cnz95/SWTE_UTN_FRN_GESE_PID/docs/graf_interp_surf_EN_s.png

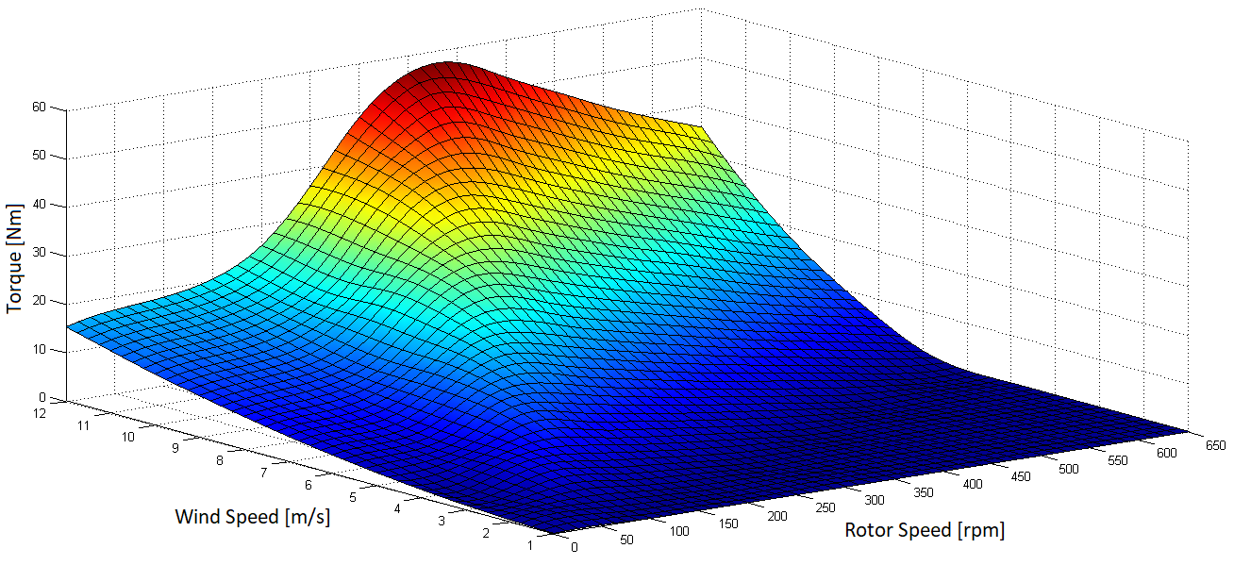
docs/graf_interp_surf_EN_s.png
