cnz95/SWTE_UTN_FRN_GESE_PID/docs/imgs otros/Figuras.docx

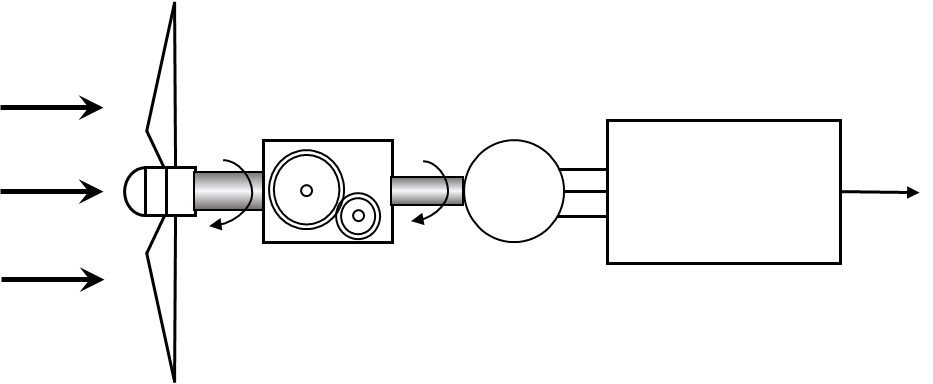
[picture p5: figure]
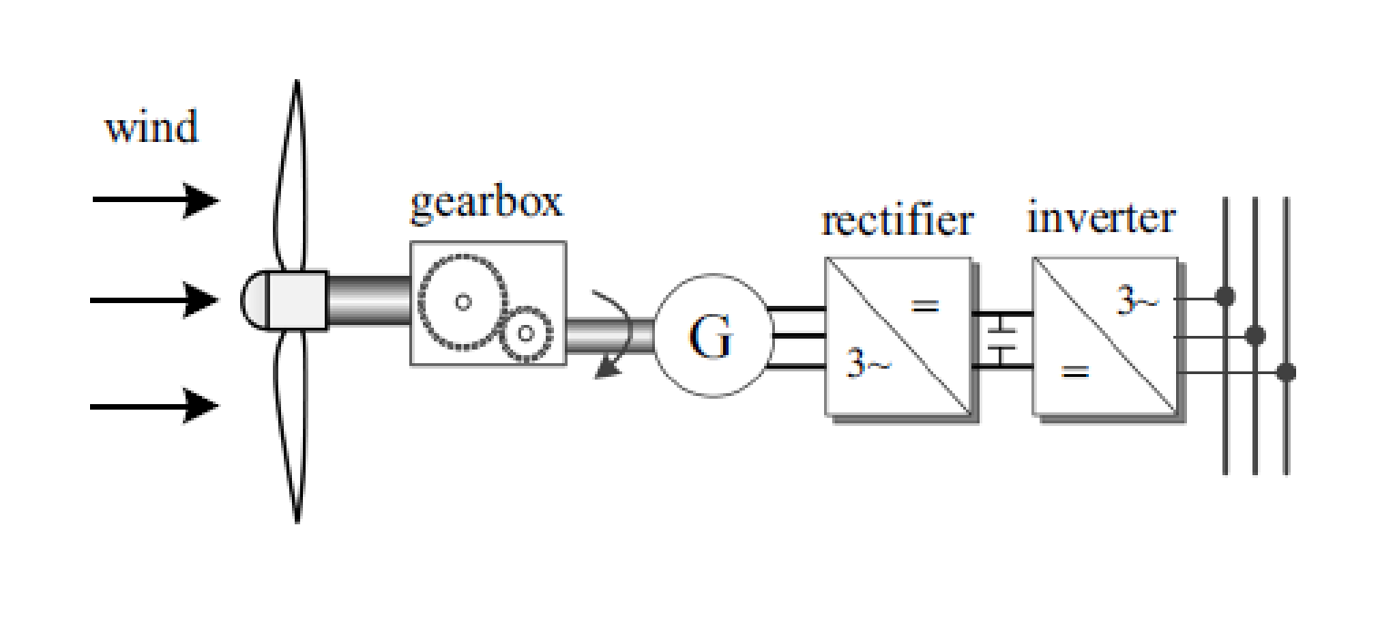
[picture p6: figure]
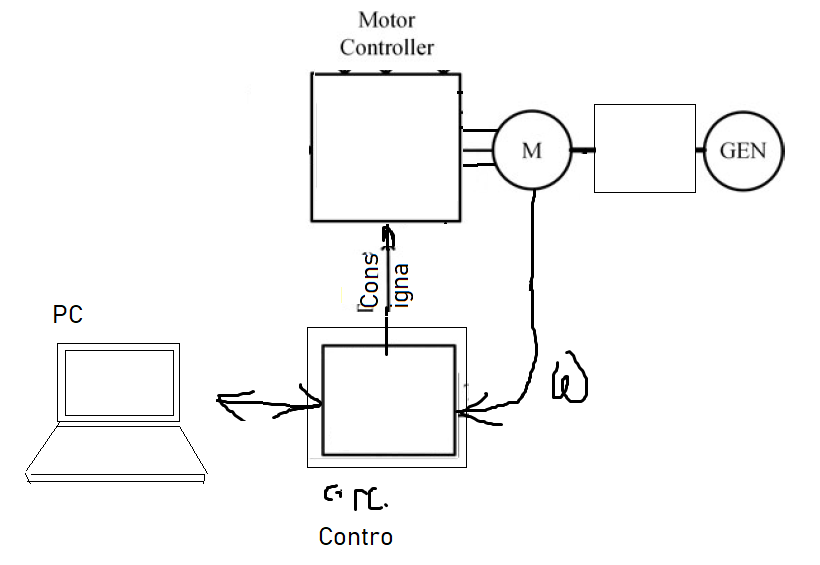
[picture p7: figure]
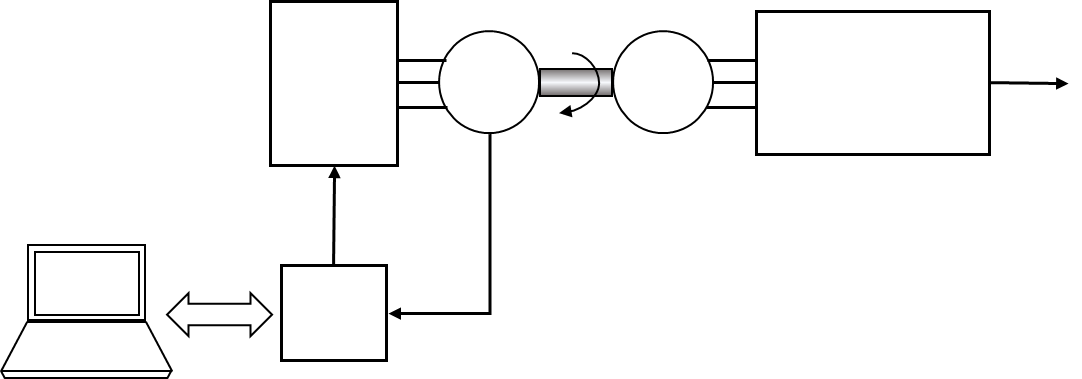
[picture p8: figure]
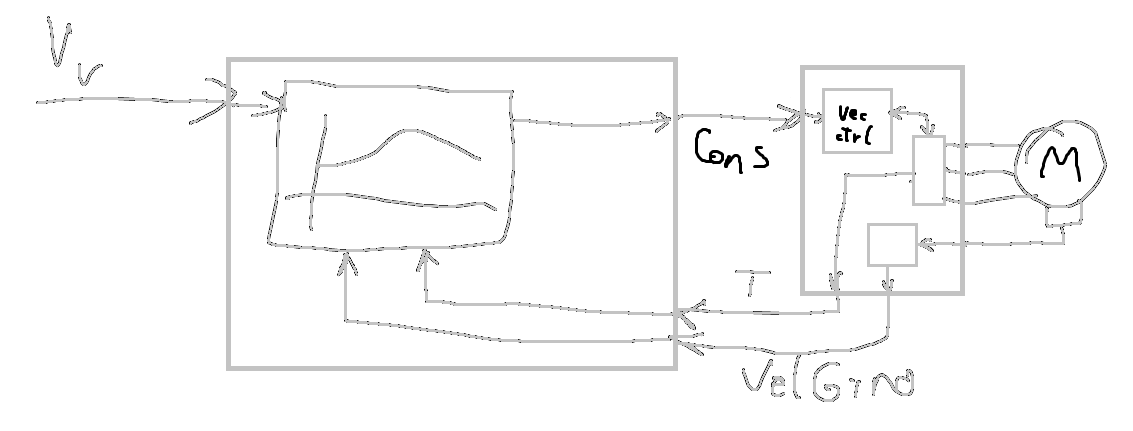
[picture p9: figure]
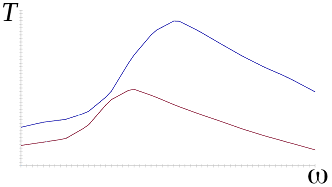
[picture p10: figure]
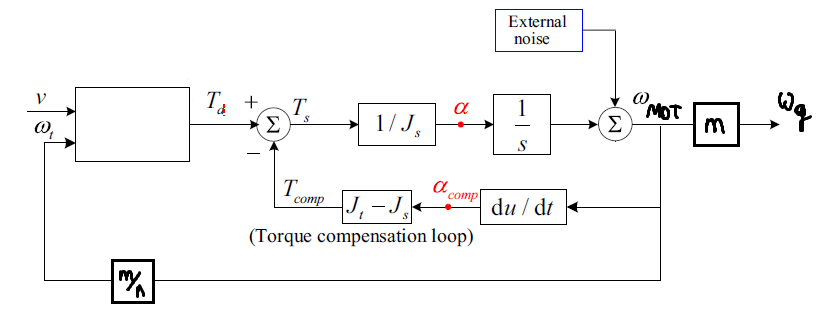
[picture p11: figure]
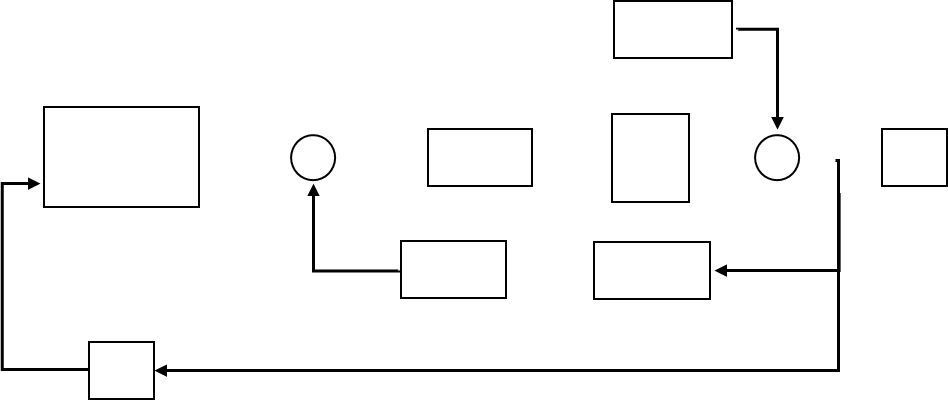
[picture p12: figure]
