cnz95/SWTE_UTN_FRN_GESE_PID/docs/control/flowchart_tarea_control_simplified.png

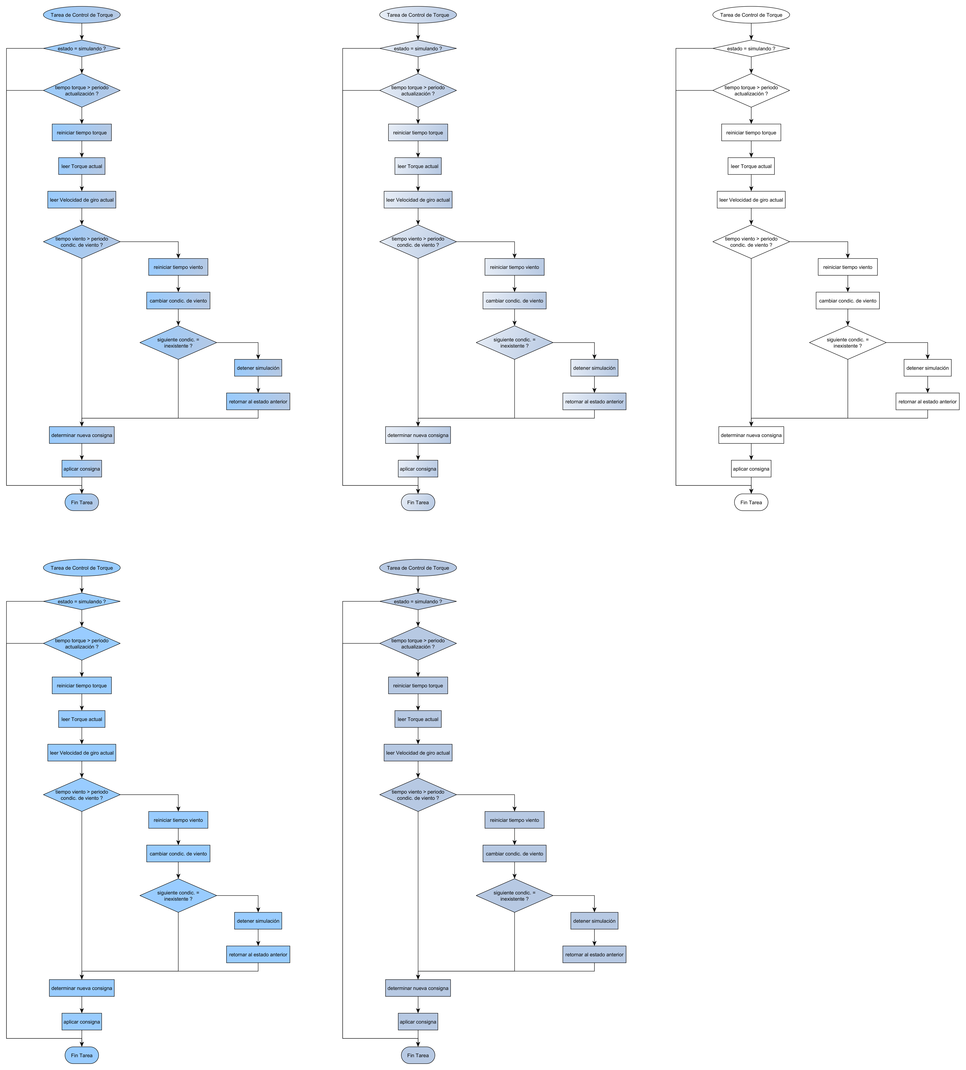
docs/control/flowchart_tarea_control_simplified.png
