cnz95/SWTE_UTN_FRN_GESE_PID/docs/control/flowchart_tarea_control_simplified_1.2.png

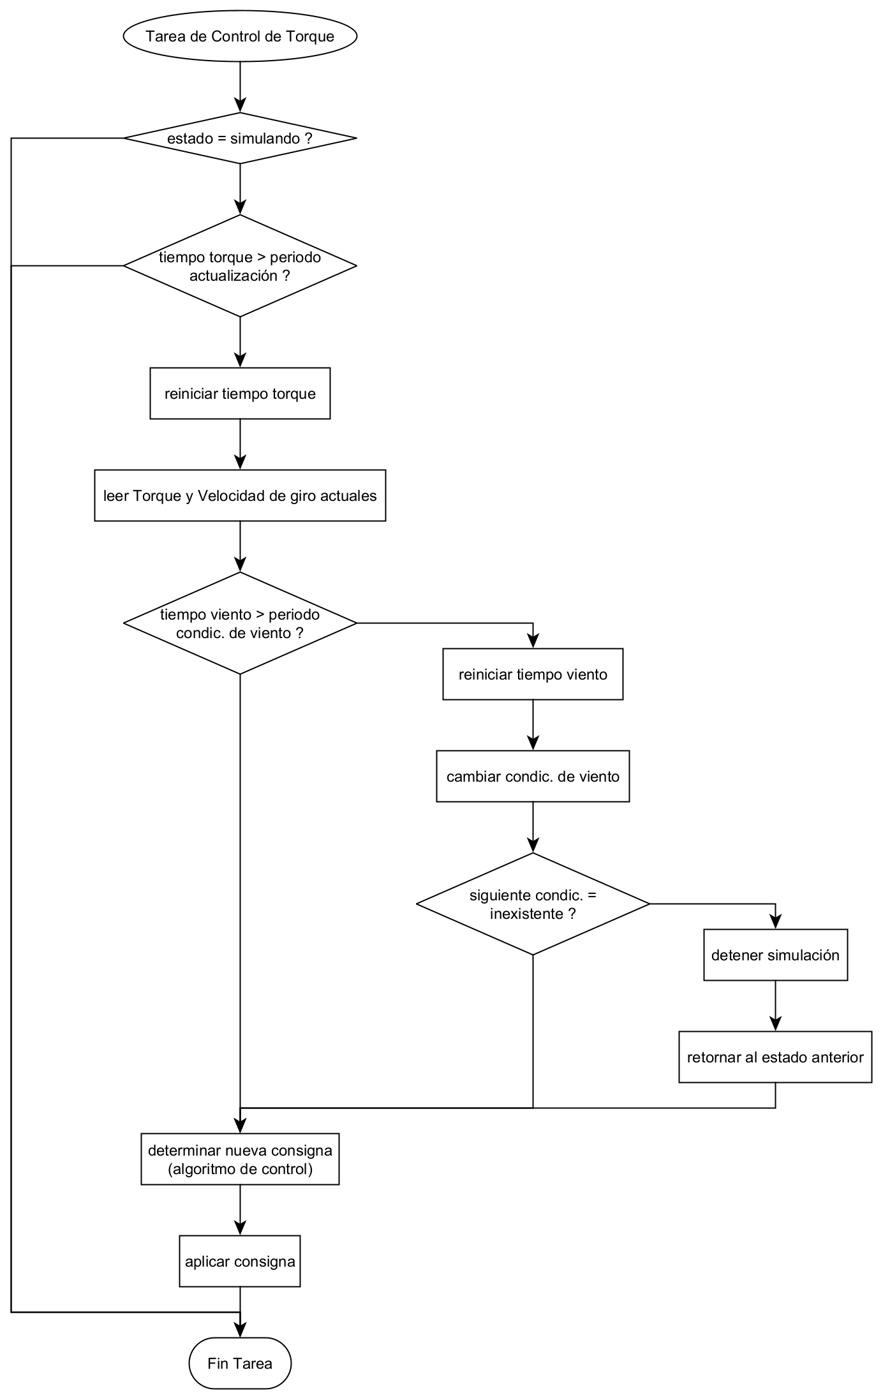
docs/control/flowchart_tarea_control_simplified_1.2.png
