cnz95/SWTE_UTN_FRN_GESE_PID/docs/imgs otros/capt_GUI.png

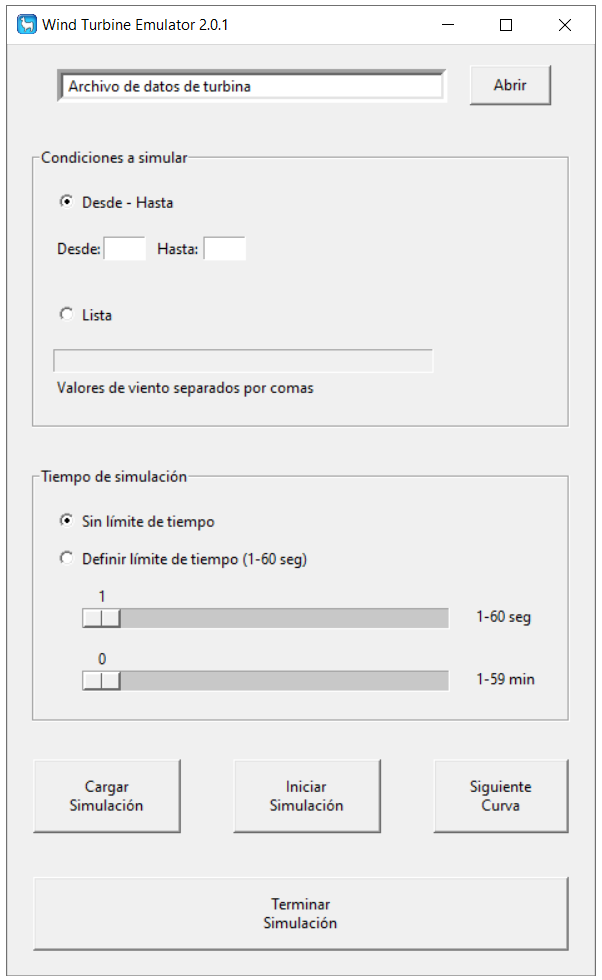
docs/imgs otros/capt_GUI.png
