cnz95/SWTE_UTN_FRN_GESE_PID/docs/imgs otros/control_circuit_1.png

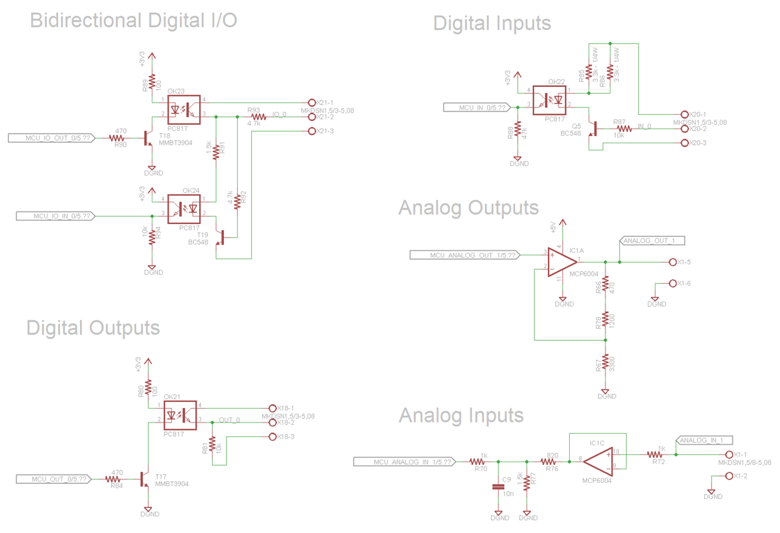
docs/imgs otros/control_circuit_1.png
