cnz95/SWTE_UTN_FRN_GESE_PID/docs/imgs otros/control_circuit_2.png

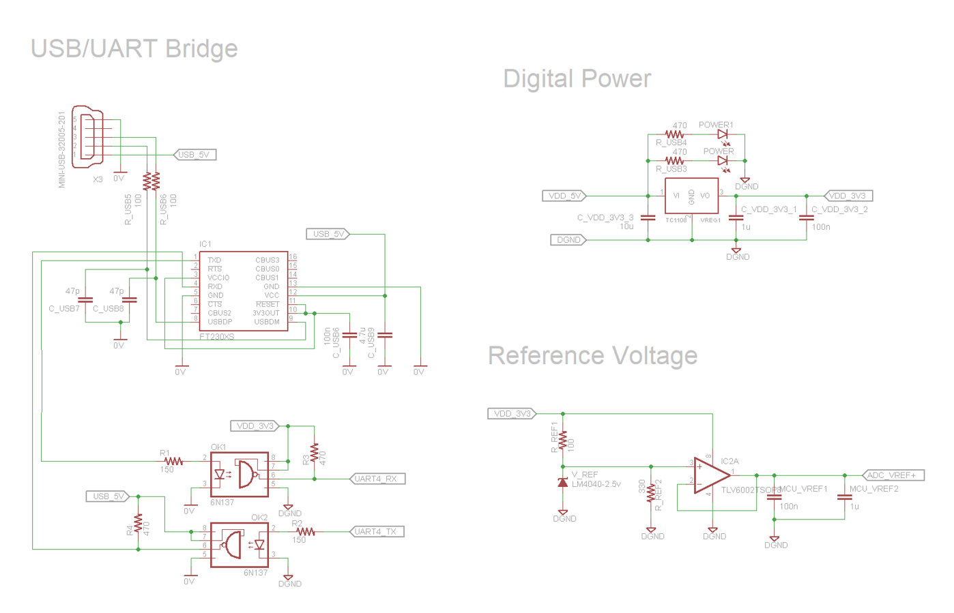
docs/imgs otros/control_circuit_2.png
