cnz95/SWTE_UTN_FRN_GESE_PID/docs/imgs otros/diagr_circ_control.png

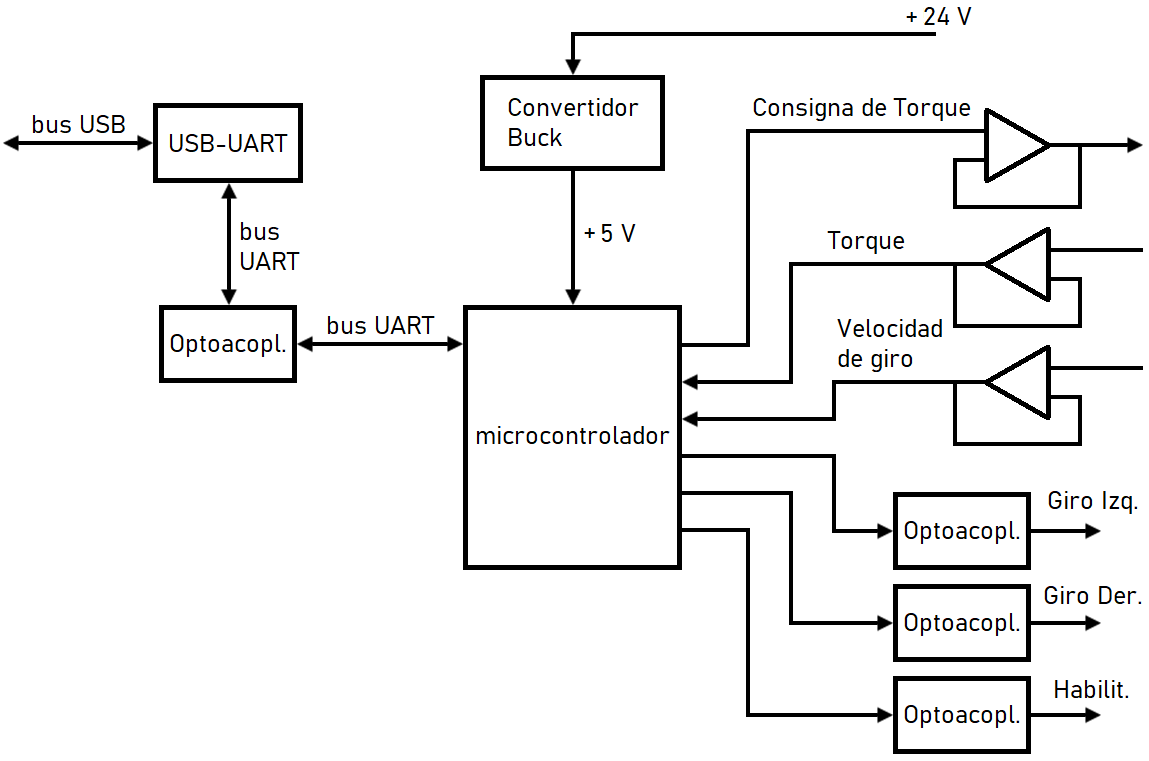
docs/imgs otros/diagr_circ_control.png
