cnz95/SWTE_UTN_FRN_GESE_PID/docs/imgs otros/ESQ1.png

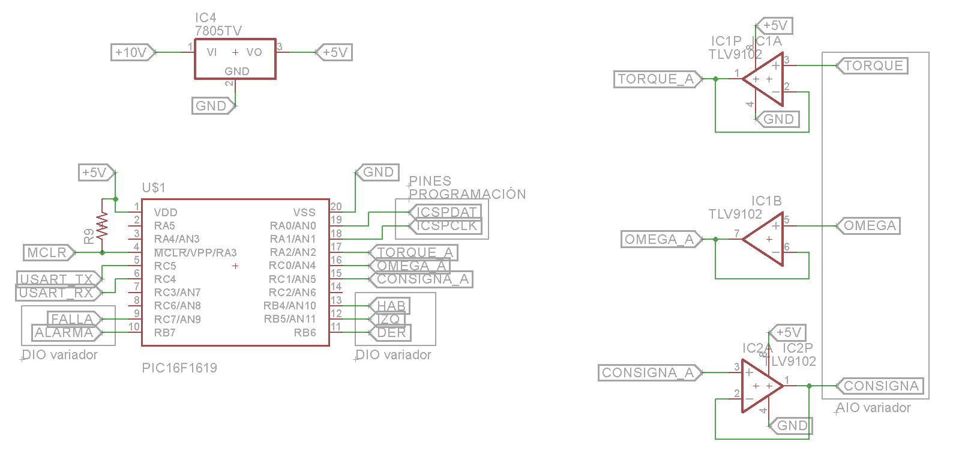
docs/imgs otros/ESQ1.png
