cnz95/SWTE_UTN_FRN_GESE_PID/docs/imgs otros/esq_circ_ed_control.png

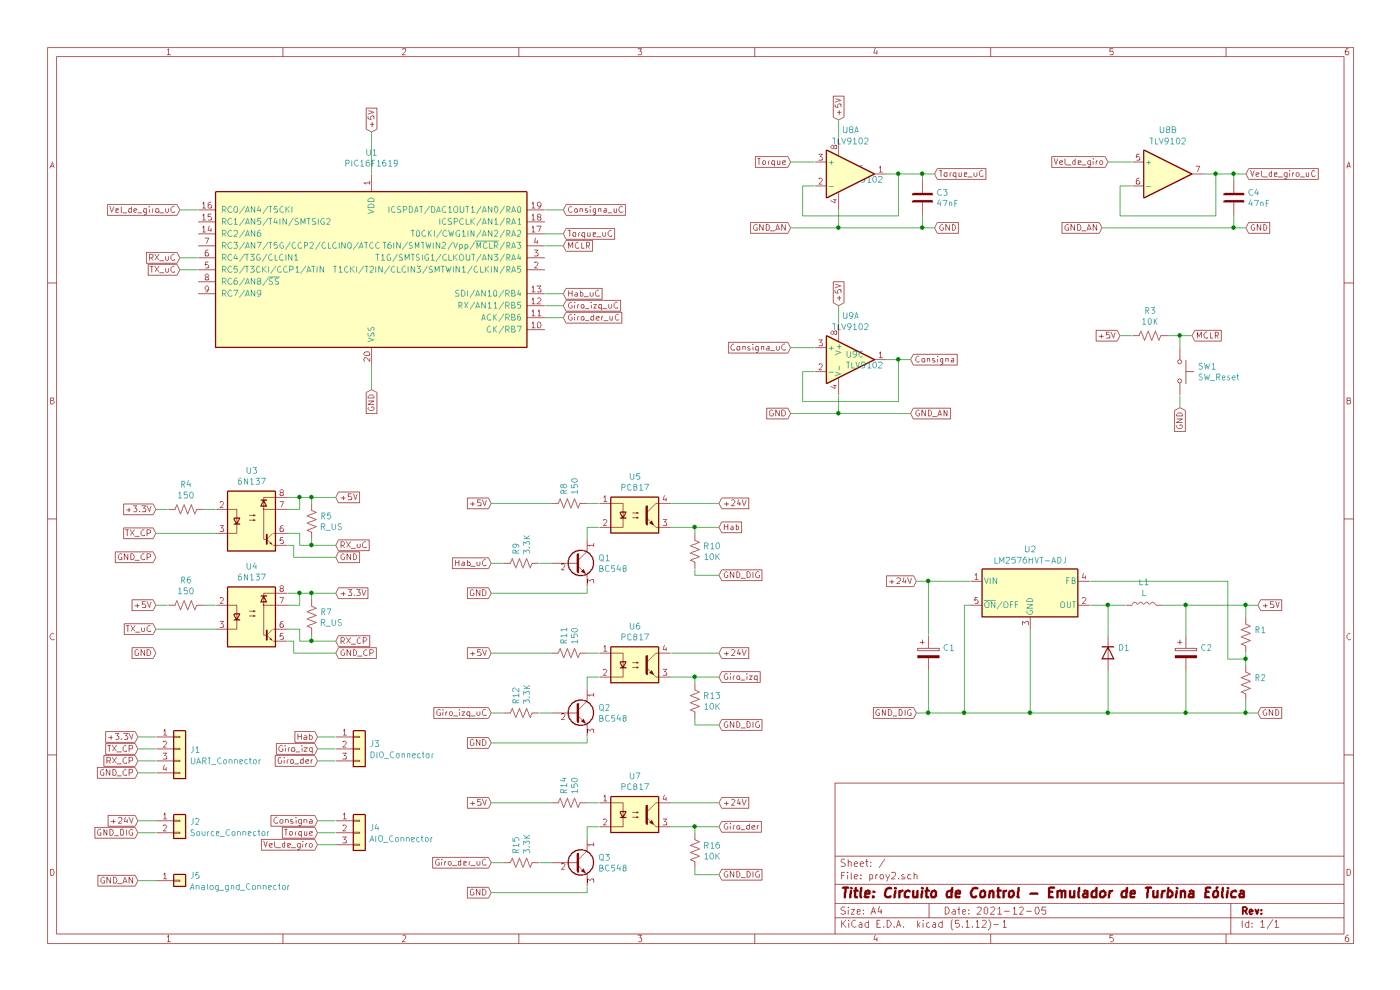
docs/imgs otros/esq_circ_ed_control.png
