cnz95/SWTE_UTN_FRN_GESE_PID/docs/imgs otros/Figures_1_EN/Diagrama de bloques control_fig3.png

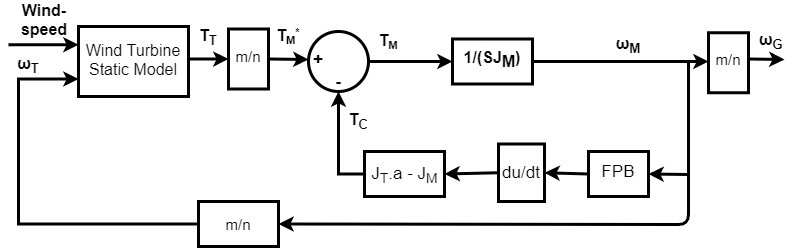
docs/imgs otros/Figures_1_EN/Diagrama de bloques control_fig3.png
