cnz95/SWTE_UTN_FRN_GESE_PID/docs/imgs otros/Figures_1_EN/Figure_Aplicativo_fig5.png

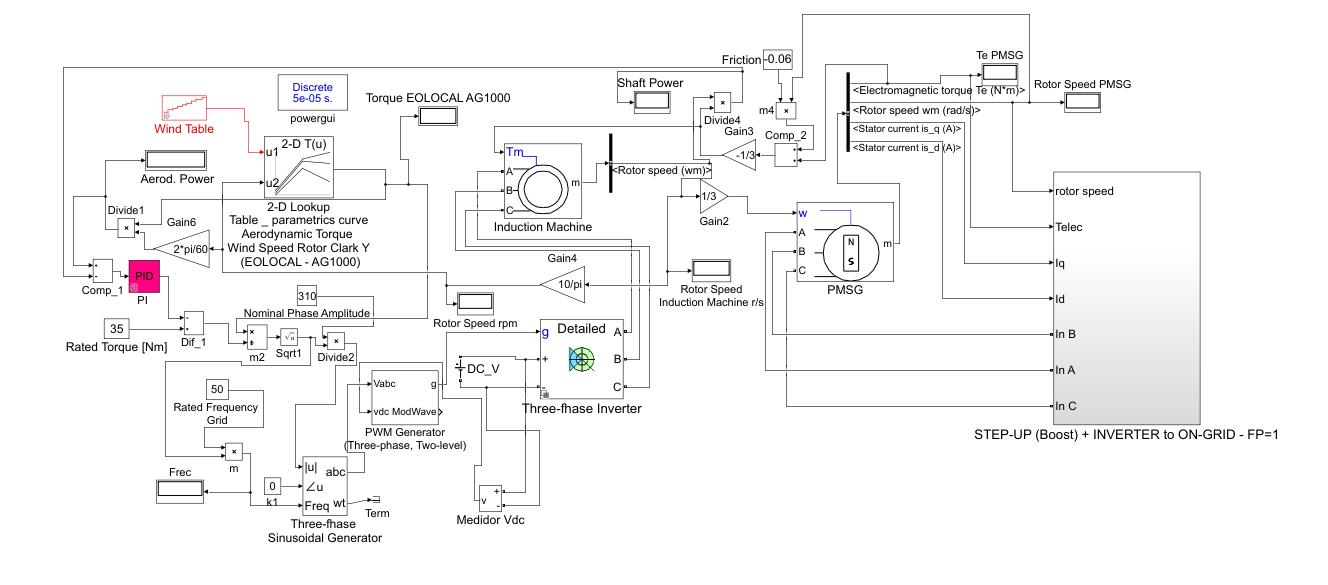
docs/imgs otros/Figures_1_EN/Figure_Aplicativo_fig5.png
