cnz95/SWTE_UTN_FRN_GESE_PID/docs/imgs otros/Figures_1_EN/Modelo_dinamico_WTE_fig2.jpg

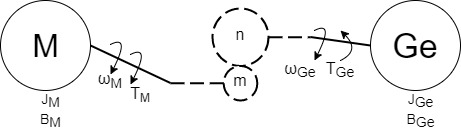
docs/imgs otros/Figures_1_EN/Modelo_dinamico_WTE_fig2.jpg
