cnz95/SWTE_UTN_FRN_GESE_PID/docs/imgs otros/Figures_1_EN/Modelo_simplificado_aplicativo_informático_grid_fig4.png

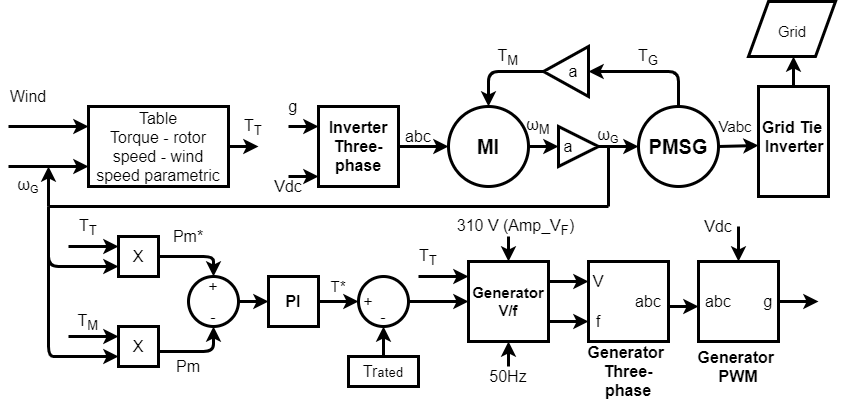
docs/imgs otros/Figures_1_EN/Modelo_simplificado_aplicativo_informático_grid_fig4.png
