cnz95/SWTE_UTN_FRN_GESE_PID/docs/imgs otros/graf_interp_plot3.png

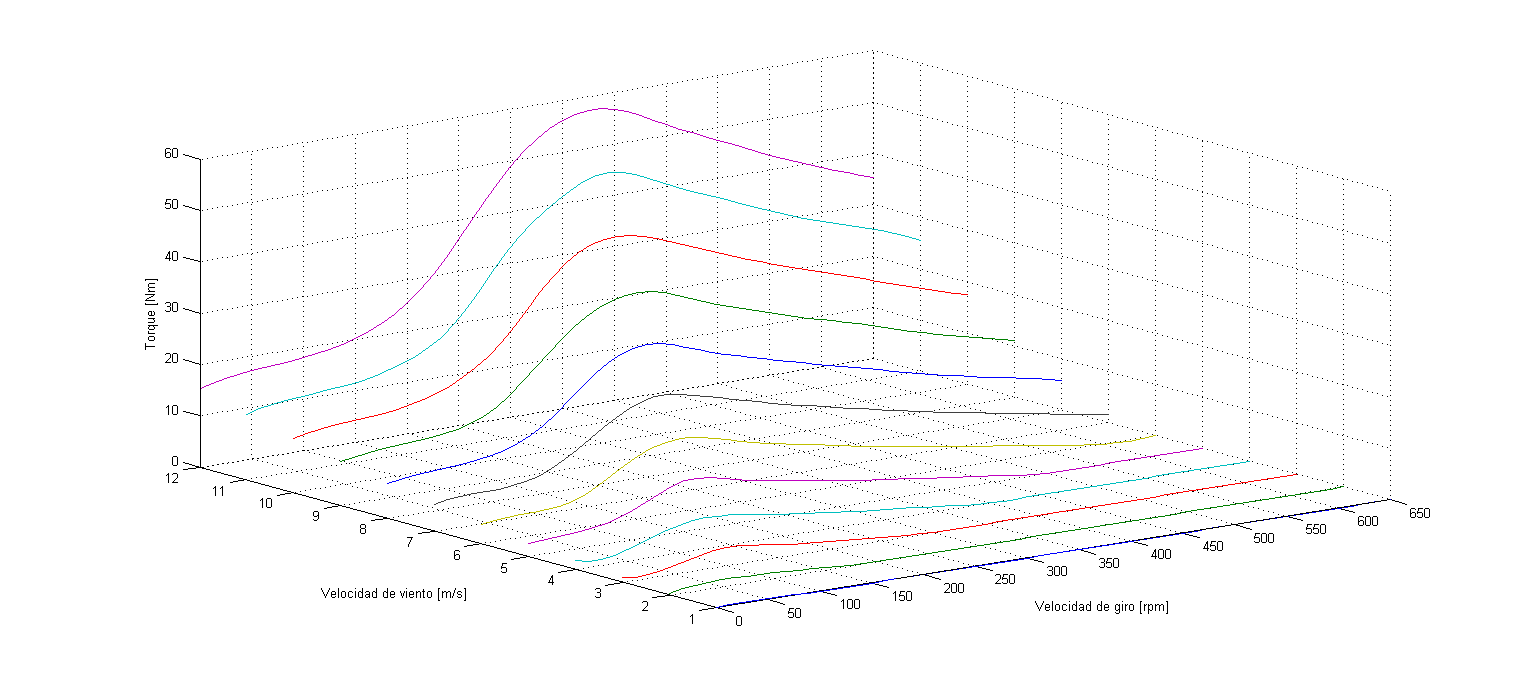
docs/imgs otros/graf_interp_plot3.png
