cnz95/SWTE_UTN_FRN_GESE_PID/docs/imgs otros/graf_mesh.png

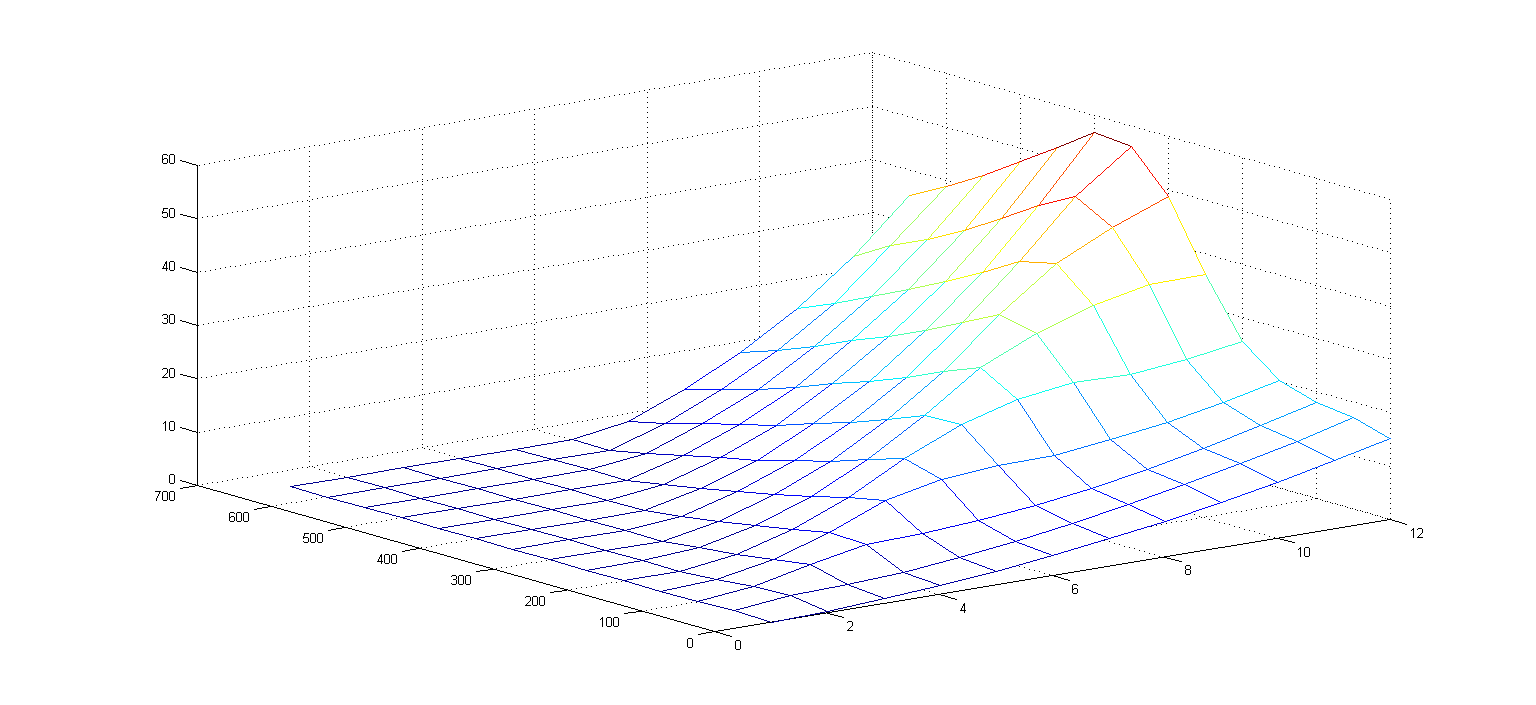
docs/imgs otros/graf_mesh.png
