cnz95/SWTE_UTN_FRN_GESE_PID/docs/imgs otros/graf_perfil_viento_simulado.png

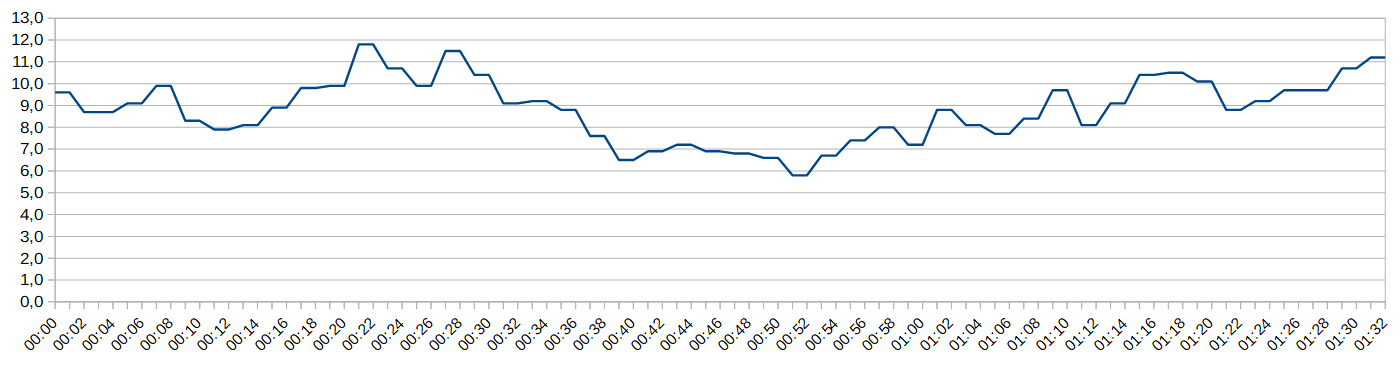
docs/imgs otros/graf_perfil_viento_simulado.png
