cnz95/SWTE_UTN_FRN_GESE_PID/docs/imgs otros/graf_torque-omega_areas.png

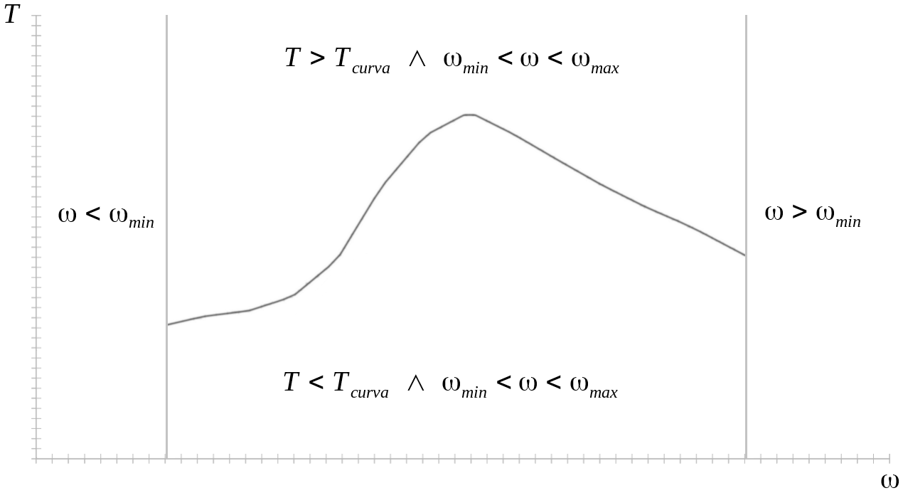
docs/imgs otros/graf_torque-omega_areas.png
