cnz95/SWTE_UTN_FRN_GESE_PID/docs/imgs otros/graf_torque-omega_mini_ok_1.png

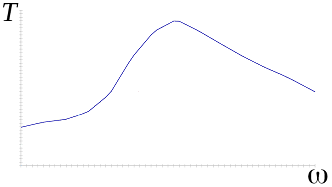
docs/imgs otros/graf_torque-omega_mini_ok_1.png
