cnz95/SWTE_UTN_FRN_GESE_PID/docs/imgs otros/IMG_control_block_diagram_3.png

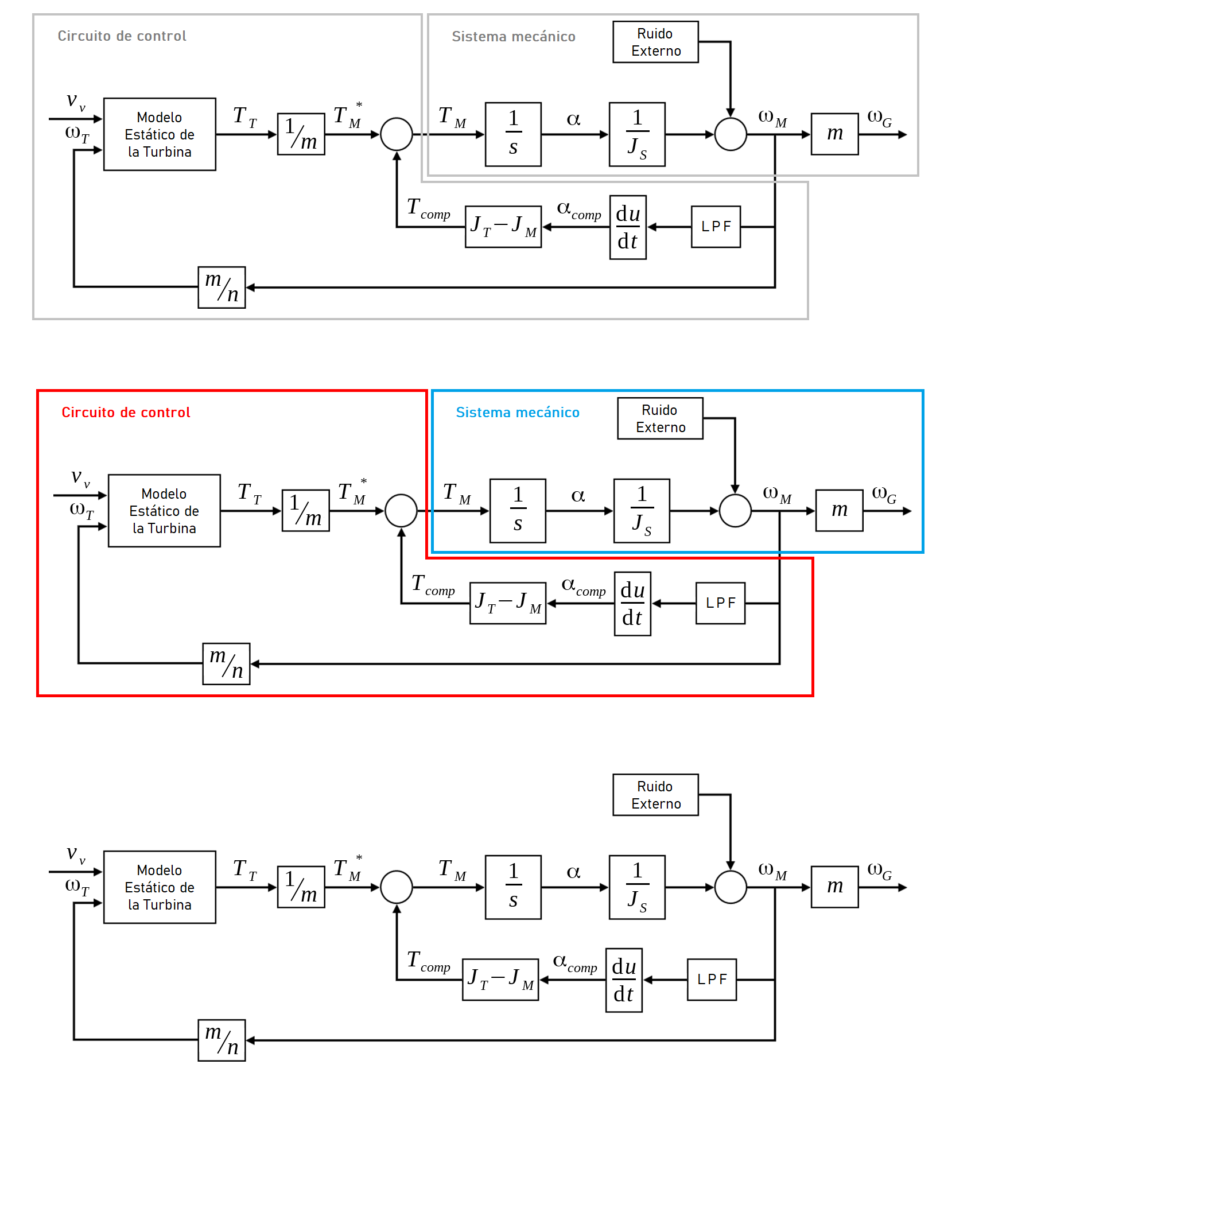
docs/imgs otros/IMG_control_block_diagram_3.png
