cnz95/SWTE_UTN_FRN_GESE_PID/docs/imgs otros/IMG_data_sequence_2.png

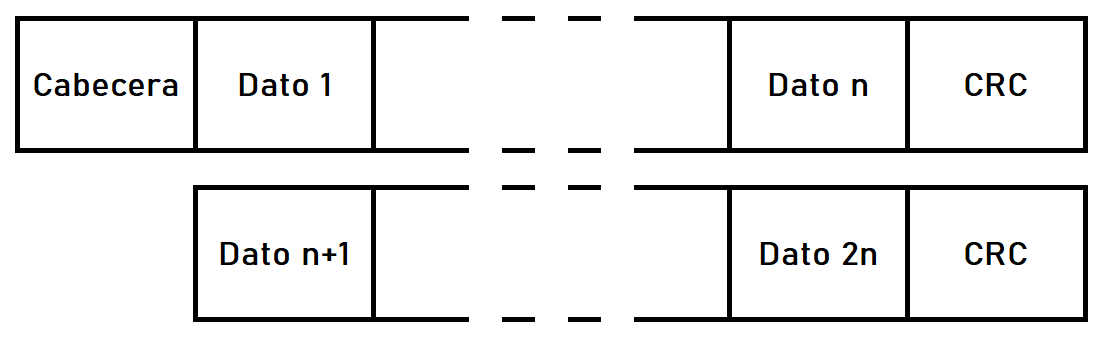
docs/imgs otros/IMG_data_sequence_2.png
