cnz95/SWTE_UTN_FRN_GESE_PID/docs/imgs otros/IMG_mecanic_models.png

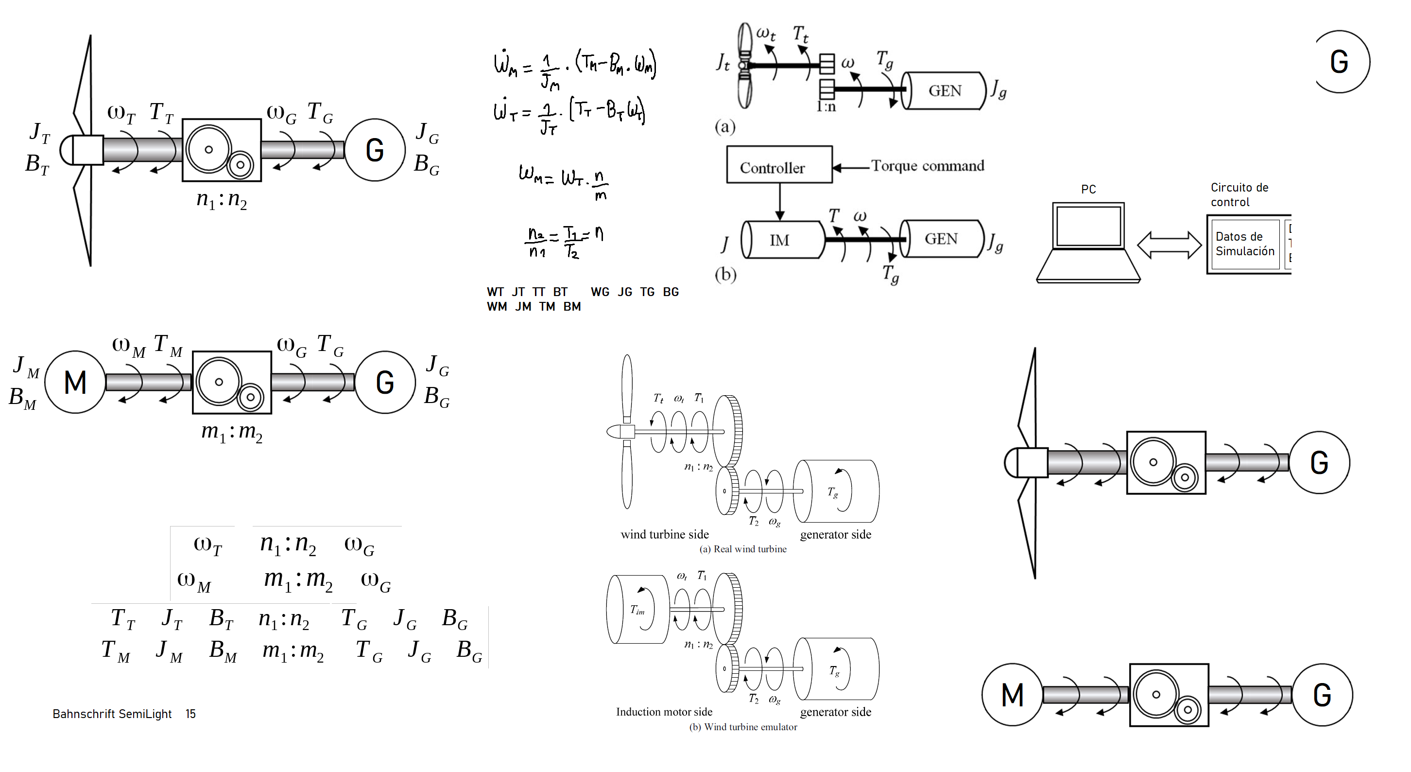
docs/imgs otros/IMG_mecanic_models.png
