cnz95/SWTE_UTN_FRN_GESE_PID/docs/imgs otros/IMG_mecanic_models_ok_1.png

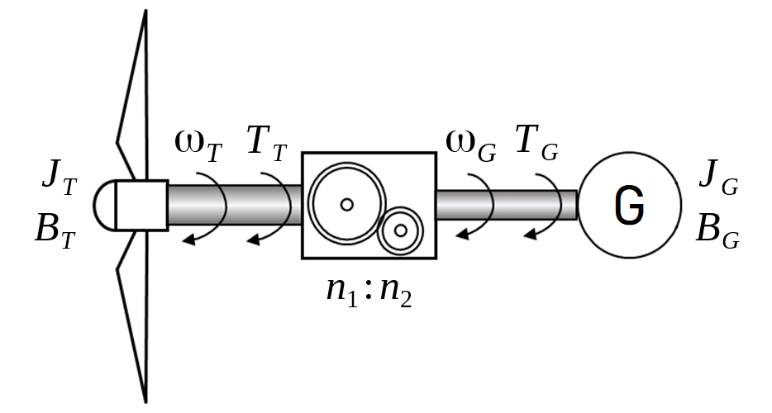
docs/imgs otros/IMG_mecanic_models_ok_1.png
