cnz95/SWTE_UTN_FRN_GESE_PID/docs/imgs otros/IMG_WECS_block_diagram.png

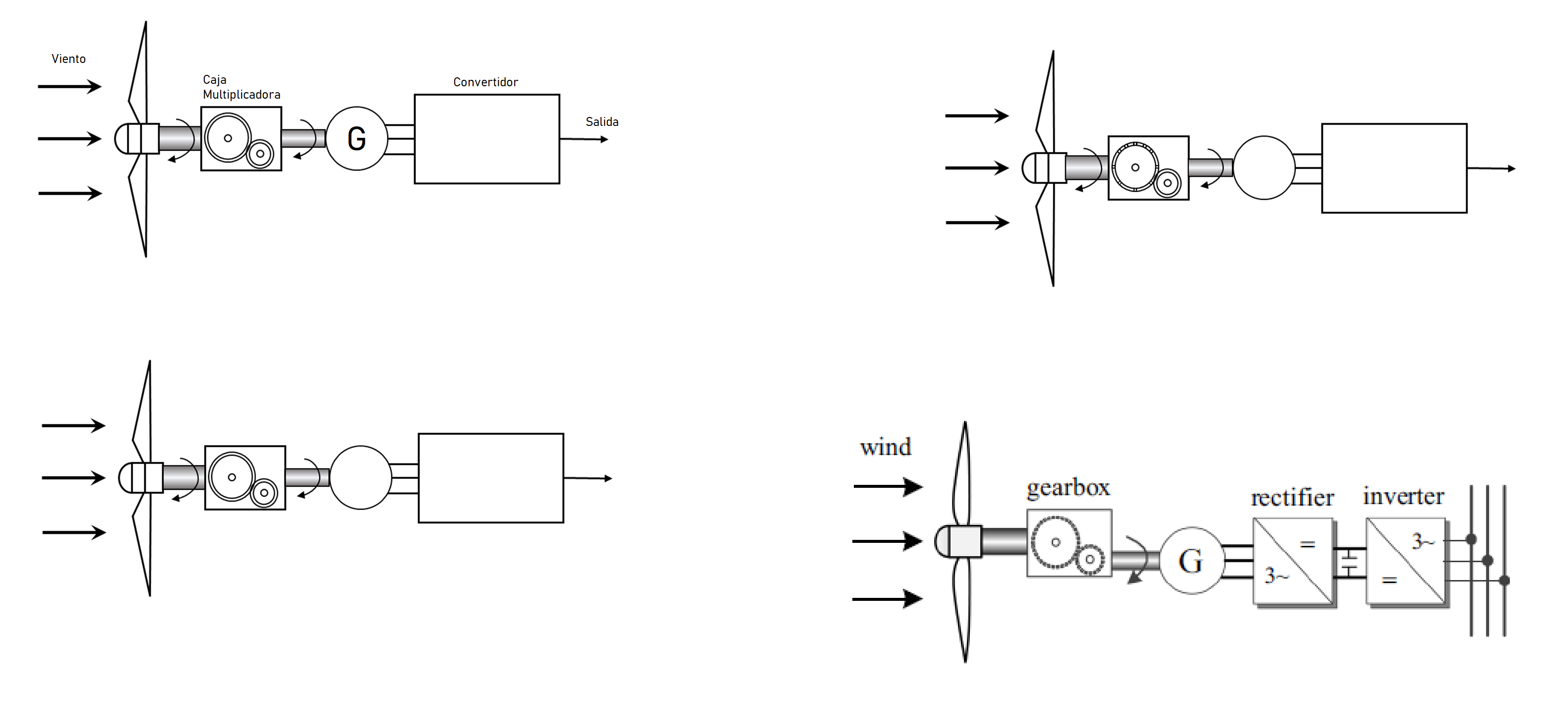
docs/imgs otros/IMG_WECS_block_diagram.png
