cnz95/SWTE_UTN_FRN_GESE_PID/docs/imgs otros/solving_mecanic_model_equation.png

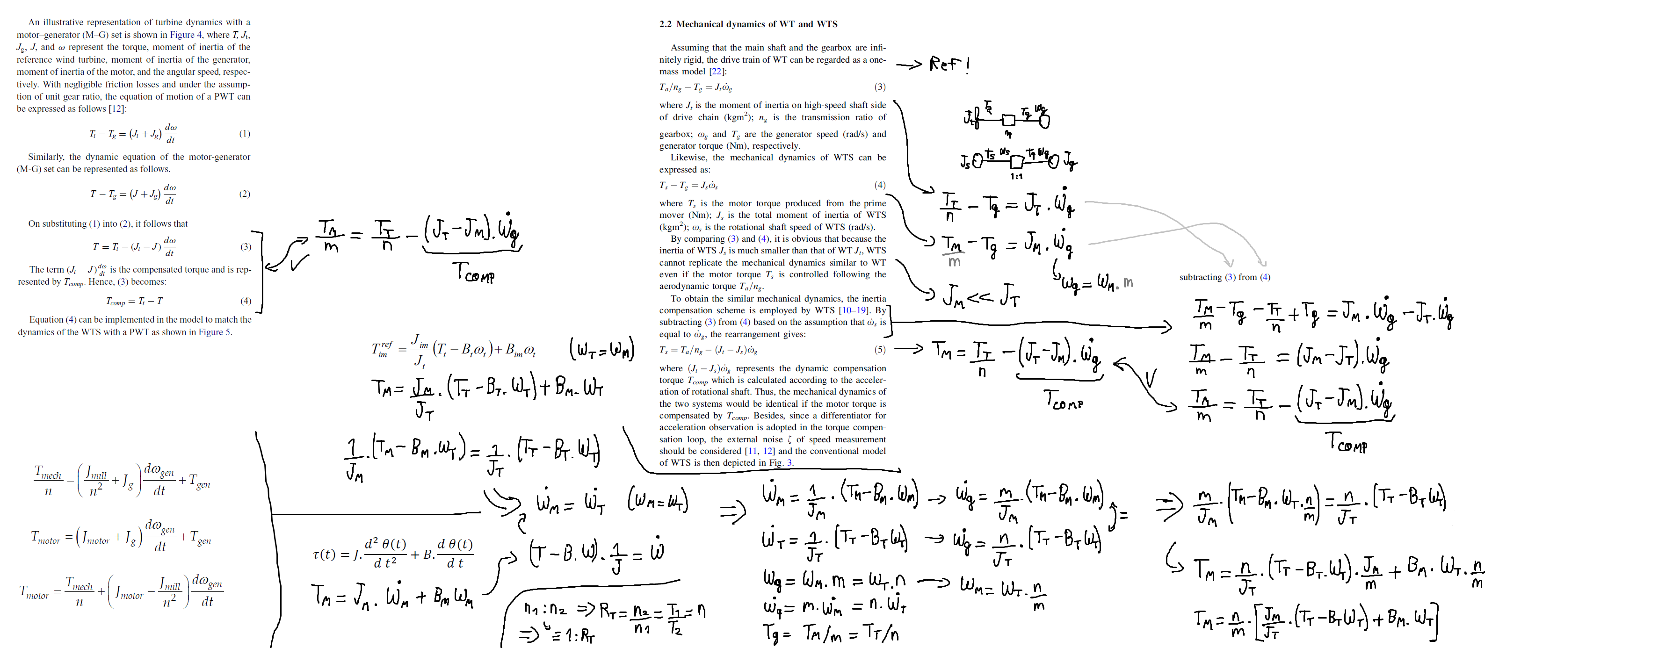
docs/imgs otros/solving_mecanic_model_equation.png
