cnz95/SWTE_UTN_FRN_GESE_PID/docs/pruebas lab/Simulacion en triangulo rev 3 - edit.xlsx

mt/seg | VL1 | VL2 | VL3 | IL1 | IL2 | IL3 | S | P | Q |  |  |  | Fricción Viscosa [NmS] | resistencias de fase PMSG
10 | 78.98 | 85.27 | 84.37 | 7 | 6.97 | 7.73 | 1039.82 | 1039.69 | 16.88 |  |  |  | 0.06 | 0.8
10 | 79.19 | 85.37 | 84.42 | 7.03 | 6.99 | 7.77 | 1045.44 | 1045.29 | 17.12 |  |  |  | Flujo de enlace PMSG [V.S]
10 | 75.96 | 81.98 | 81.14 | 6.75 | 6.73 | 7.5 | 967.06 | 966.94 | 15.29 |  |  |  | 0.275
9 | 65.19 | 69.95 | 69.73 | 5.74 | 5.79 | 6.12 | 696.75 | 696.66 | 11.01 |  |  |  | Cte Vel. PMSG (V_rms L-L)/rpm
9 | 65.92 | 70.82 | 70.58 | 5.82 | 5.87 | 6.23 | 715.65 | 715.56 | 11.29 |  |  |  | 0.2166
9 | 65.95 | 71.18 | 70.9 | 5.87 | 5.94 | 6.32 | 726.48 | 726.38 | 11.91
9 | 66.24 | 71.15 | 70.91 | 5.87 | 5.94 | 6.33 | 728.26 | 728.16 | 11.76
8 | 52.6 | 56.52 | 56.36 | 4.67 | 4.72 | 5.04 | 460.02 | 459.96 | 7.52
8 | 51.58 | 55.69 | 55.51 | 4.6 | 4.65 | 4.96 | 445.95 | 445.89 | 7.5
8 | 52.72 | 56.85 | 56.66 | 4.7 | 4.75 | 5.07 | 465.04 | 464.98 | 7.74
8 | 51.26 | 55.34 | 55.19 | 4.55 | 4.59 | 4.86 | 436.47 | 436.4 | 7.35
7 | 35.91 | 38.67 | 38.61 | 3.18 | 3.2 | 3.39 | 213.1 | 213.06 | 4.03
7 | 35.65 | 38.4 | 38.31 | 3.16 | 3.18 | 3.37 | 210.05 | 210.02 | 3.9
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
