cnz95/SWTE_UTN_FRN_GESE_PID/conversión e inyección a la red/pruebas/med V-I vs T-W - 2025-08/PIV(convertidor) vs TW - viento V2 2025-8-14.xlsx

 |  |  |  |  | Fluke |  |  |  |  |  |  | Convertidor |  |  | Multímetros
VV [m/s] | Torque [V] | Torque [Nm] | Omega [V] | Omega [rpm] | V [V] | I [A] | P [W] | S [VA] | Q [VAr] | PF | DPF | P [W] | VDC [V] | Vred [V] | Vgen [V] | Igen [A] |  | * voltajes y corrientes son eficaces
3
 |  |  |  |  |  |  |  |  |  |  |  |  |  |  |  |  |  | Nota: pruebas realizadas con valores de I-V reajustados ("desplazados")
4 | 0.11 |  | 1.72 |  |  |  |  |  |  |  |  | 27.9 | 47.5 | 222.6
 |  |  |  |  |  |  |  |  |  |  |  | 29.1 | 41.4 | 222.7
 |  |  |  |  |  |  |  |  |  |  |  | 18.1 | 40.8 | 222.5
5 | 0.19 |  | 2.22 |  |  |  |  |  |  |  |  | 74.9 | 52.6 | 223
 |  |  |  |  |  |  |  |  |  |  |  | 72.5 | 53.4 | 222.9
 |  |  |  |  |  |  |  |  |  |  |  | 75.3 | 52.6 | 222.9
6 | 0.32 |  | 2.58 |  |  |  |  |  |  |  |  | 164.7 | 60.6 | 224.1
 |  |  |  |  |  |  |  |  |  |  |  | 154.9 | 60.6 | 224.1
 |  |  |  |  |  |  |  |  |  |  |  | 157.3 | 60 | 224.1
7 | 0.44 |  | 2.96 |  |  |  |  |  |  |  |  | 284.8 | 68 | 224.6
 |  |  |  |  |  |  |  |  |  |  |  | 280.6 | 68.1 | 224.7
 |  |  |  |  |  |  |  |  |  |  |  | 283.5 | 68.5 | 223.9
8 | 0.58 |  | 3.28 |  |  |  |  |  |  |  |  | 430.1 | 73.9 | 224.7
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
