cnz95/SWTE_UTN_FRN_GESE_PID/conversión e inyección a la red/pruebas/medición potencia generada - 2022/calculating TEMP.xlsx

10 Ohm |  |  |  |  |  | 15 Ohm |  |  |  |  |  | 20 Ohm |  |  |  |  |  | 30 Ohm |  |  |  |  |  | 40 Ohm |  |  |  |  |  | 50 Ohm |  |  |  |  |  | 60 Ohm
 |  |  |  |  |  |  | Medición |  | Motor | Generador | Potencias |  | Medición |  | Motor | Generador | Potencias |  | Medición |  | Motor | Generador | Potencias |  | Medición |  | Motor | Generador | Potencias |  | Medición |  | Motor | Generador | Potencias |  | Medición |  | Motor | Generador | Potencias |  | Medición |  | Motor | Generador | Potencias
 |  |  |  |  |  | Omega | 0.6 | Omega [rpm] | 180 | 60 | 23.58381039 | Omega | 1.76 | Omega [rpm] | 528 | 176 | 138.3583543 | Omega | 2.28 | Omega [rpm] | 684 | 228 | 167.6732842 | Omega | 2.58 | Omega [rpm] | 774 | 258 | 179.9216502 | Omega | 2.78 | Omega [rpm] | 834 | 278 | 179.7694966 | Omega | 2.92 | Omega [rpm] | 876 | 292 | 181.4178274 | Omega |  | Omega [rpm] | 0 | 0 | 0
 |  |  |  |  |  | Torque | 0.62 | Torque [Nm] | 1.25116 | 3.75348 |  | Torque | 1.24 | Torque [Nm] | 2.50232 | 7.50696 |  | Torque | 1.16 | Torque [Nm] | 2.34088 | 7.02264 |  | Torque | 1.1 | Torque [Nm] | 2.2198 | 6.6594 |  | Torque | 1.02 | Torque [Nm] | 2.05836 | 6.17508 |  | Torque | 0.98 | Torque [Nm] | 1.97764 | 5.93292 |  | Torque |  | Torque [Nm] | 0 | 0
 |  |  |  |  |  | Voltaje [V] |  |  |  |  | 0 | Voltaje [V] | 43 |  |  |  | 92.45 | Voltaje [V] | 56 |  |  |  | 106.4 | Voltaje [V] | 64 |  |  |  | 102.4 | Voltaje [V] | 69.2 |  |  |  | 95.7728 | Voltaje [V] | 73.2 |  |  |  | 89.304 | Voltaje [V] |  |  |  |  | 0
 |  |  |  |  |  | Corriente [A] |  |  |  |  |  | Corriente [A] | 2.15 |  |  |  |  | Corriente [A] | 1.9 |  |  |  |  | Corriente [A] | 1.6 |  |  |  |  | Corriente [A] | 1.384 |  |  |  |  | Corriente [A] | 1.22 |  |  |  |  | Corriente [A]
 |  |  |  |  |  | Vel Viento |  |  |  | Pres/Pmotor | 0 | Vel Viento | 5 |  |  | Pres/Pmotor | 0.6681923942 | Vel Viento | 5 |  |  | Pres/Pmotor | 0.6345674001 | Vel Viento | 5 |  |  | Pres/Pmotor | 0.5691366208 | Vel Viento | 5 |  |  | Pres/Pmotor | 0.5327533414 | Vel Viento | 5 |  |  | Pres/Pmotor | 0.4922559225 | Vel Viento |  |  |  | Pres/Pmotor | #DIV/0!
 |  |  |  |  |  |  | Medición |  | Motor | Generador | Potencias |  | Medición |  | Motor | Generador | Potencias |  | Medición |  | Motor | Generador | Potencias |  | Medición |  | Motor | Generador | Potencias |  | Medición |  | Motor | Generador | Potencias |  | Medición |  | Motor | Generador | Potencias
 |  |  |  |  |  | Omega | 0.96 | Omega [rpm] | 288 | 96 | 53.55807262 | Omega | 2.22 | Omega [rpm] | 666 | 222 | 208.2982995 | Omega | 2.68 | Omega [rpm] | 804 | 268 | 227.6725265 | Omega | 3.04 | Omega [rpm] | 912 | 304 | 248.6190076 | Omega | 3.28 | Omega [rpm] | 984 | 328 | 241.2141983 | Omega | 3.44 | Omega [rpm] | 1032 | 344 | 239.8955336
 |  |  |  |  |  | Torque | 0.88 | Torque [Nm] | 1.77584 | 5.32752 |  | Torque | 1.48 | Torque [Nm] | 2.98664 | 8.95992 |  | Torque | 1.34 | Torque [Nm] | 2.70412 | 8.11236 |  | Torque | 1.29 | Torque [Nm] | 2.60322 | 7.80966 |  | Torque | 1.16 | Torque [Nm] | 2.34088 | 7.02264 |  | Torque | 1.1 | Torque [Nm] | 2.2198 | 6.6594
 |  |  |  |  |  | Voltaje [V] |  |  |  |  | 0 | Voltaje [V] | 53.6 |  |  |  | 147.4 | Voltaje [V] | 66 |  |  |  | 151.8 | Voltaje [V] | 75.2 |  |  |  | 141.376 | Voltaje [V] | 82.4 |  |  |  | 135.7952 | Voltaje [V] | 86.4 |  |  |  | 124.416
 |  |  |  |  |  | Corriente [A] |  |  |  |  |  | Corriente [A] | 2.75 |  |  |  |  | Corriente [A] | 2.3 |  |  |  |  | Corriente [A] | 1.88 |  |  |  |  | Corriente [A] | 1.648 |  |  |  |  | Corriente [A] | 1.44
 |  |  |  |  |  | Vel Viento |  |  |  | Pres/Pmotor | 0 | Vel Viento | 5.5 |  |  | Pres/Pmotor | 0.7076389983 | Vel Viento | 5.5 |  |  | Pres/Pmotor | 0.6667471141 | Vel Viento | 5.5 |  |  | Pres/Pmotor | 0.5686451788 | Vel Viento | 5.5 |  |  | Pres/Pmotor | 0.5629652026 | Vel Viento | 6 |  |  | Pres/Pmotor | 0.5186257457
 |  |  |  |  |  |  | Medición |  | Motor | Generador | Potencias |  | Medición |  | Motor | Generador | Potencias |  | Medición |  | Motor | Generador | Potencias |  | Medición |  | Motor | Generador | Potencias |  | Medición |  | Motor | Generador | Potencias |  | Medición |  | Motor | Generador | Potencias
 |  |  |  |  |  | Omega | 2.16 | Omega [rpm] | 648 | 216 | 241.0113268 | Omega | 2.56 | Omega [rpm] | 768 | 256 | 272.6592788 | Omega | 3.1 | Omega [rpm] | 930 | 310 | 298.7282649 | Omega | 3.5 | Omega [rpm] | 1050 | 350 | 315.0847786 | Omega | 3.76 | Omega [rpm] | 1128 | 376 | 307.5024567 | Omega | 3.96 | Omega [rpm] | 1188 | 396 | 306.2852278
 |  |  |  |  |  | Torque | 1.76 | Torque [Nm] | 3.55168 | 10.65504 |  | Torque | 1.68 | Torque [Nm] | 3.39024 | 10.17072 |  | Torque | 1.52 | Torque [Nm] | 3.06736 | 9.20208 |  | Torque | 1.42 | Torque [Nm] | 2.86556 | 8.59668 |  | Torque | 1.29 | Torque [Nm] | 2.60322 | 7.80966 |  | Torque | 1.22 | Torque [Nm] | 2.46196 | 7.38588
 |  |  |  |  |  | Voltaje [V] | 51.2 |  |  |  | 176.64 | Voltaje [V] | 62 |  |  |  | 198.4 | Voltaje [V] | 77.6 |  |  |  | 197.88 | Voltaje [V] | 86.8 |  |  |  | 188.356 | Voltaje [V] | 94 |  |  |  | 176.72 | Voltaje [V] | 99.2 |  |  |  | 164.0106667
 |  |  |  |  |  | Corriente [A] | 3.45 |  |  |  |  | Corriente [A] | 3.2 |  |  |  |  | Corriente [A] | 2.55 |  |  |  |  | Corriente [A] | 2.17 |  |  |  |  | Corriente [A] | 1.88 |  |  |  |  | Corriente [A] | 1.653333333
 |  |  |  |  |  | Vel Viento | 6 |  |  | Pres/Pmotor | 0.7329116119 | Vel Viento | 6 |  |  | Pres/Pmotor | 0.7276480774 | Vel Viento | 6 |  |  | Pres/Pmotor | 0.6624080251 | Vel Viento | 6 |  |  | Pres/Pmotor | 0.5977946661 | Vel Viento | 6 |  |  | Pres/Pmotor | 0.5746945956 | Vel Viento | 6.5 |  |  | Pres/Pmotor | 0.5354834376
 |  |  |  |  |  |  | Medición |  | Motor | Generador | Potencias |  | Medición |  | Motor | Generador | Potencias |  | Medición |  | Motor | Generador | Potencias |  | Medición |  | Motor | Generador | Potencias |  | Medición |  | Motor | Generador | Potencias
 |  |  |  |  |  | Omega | 2.56 | Omega [rpm] | 768 | 256 | 331.0862671 | Omega | 3 | Omega [rpm] | 900 | 300 | 361.3648366 | Omega | 3.56 | Omega [rpm] | 1068 | 356 | 383.6807002 | Omega | 4.06 | Omega [rpm] | 1218 | 406 | 406.681255 | Omega | 4.32 | Omega [rpm] | 1296 | 432 | 388.904641
 |  |  |  |  |  | Torque | 2.04 | Torque [Nm] | 4.11672 | 12.35016 |  | Torque | 1.9 | Torque [Nm] | 3.8342 | 11.5026 |  | Torque | 1.7 | Torque [Nm] | 3.4306 | 10.2918 |  | Torque | 1.58 | Torque [Nm] | 3.18844 | 9.56532 |  | Torque | 1.42 | Torque [Nm] | 2.86556 | 8.59668
 |  |  |  |  |  | Voltaje [V] | 61 |  |  |  | 250.1 | Voltaje [V] | 72.8 |  |  |  | 273 | Voltaje [V] | 88.8 |  |  |  | 270.84 | Voltaje [V] | 100 |  |  |  | 250 | Voltaje [V] | 107 |  |  |  | 228.98
 |  |  |  |  |  | Corriente [A] | 4.1 |  |  |  |  | Corriente [A] | 3.75 |  |  |  |  | Corriente [A] | 3.05 |  |  |  |  | Corriente [A] | 2.5 |  |  |  |  | Corriente [A] | 2.14
 |  |  |  |  |  | Vel Viento | 6.5 |  |  | Pres/Pmotor | 0.7553922492 | Vel Viento | 6.5 |  |  | Pres/Pmotor | 0.755469189 | Vel Viento | 6.5 |  |  | Pres/Pmotor | 0.7058994625 | Vel Viento | 6.5 |  |  | Pres/Pmotor | 0.6147320461 | Vel Viento | 6.5 |  |  | Pres/Pmotor | 0.5887818655
 |  |  |  |  |  |  | Medición |  | Motor | Generador | Potencias |  | Medición |  | Motor | Generador | Potencias |  | Medición |  | Motor | Generador | Potencias
 |  |  |  |  |  | Omega | 2.96 | Omega [rpm] | 888 | 296 | 435.3622115 | Omega | 3.36 | Omega [rpm] | 1008 | 336 | 451.5919305 | Omega | 4.06 | Omega [rpm] | 1218 | 406 | 478.7513509
 |  |  |  |  |  | Torque | 2.32 | Torque [Nm] | 4.68176 | 14.04528 |  | Torque | 2.12 | Torque [Nm] | 4.27816 | 12.83448 |  | Torque | 1.86 | Torque [Nm] | 3.75348 | 11.26044
 |  |  |  |  |  | Voltaje [V] | 70.4 |  |  |  | 334.4 | Voltaje [V] | 82 |  |  |  | 344.4 | Voltaje [V] | 100 |  |  |  | 325
 |  |  |  |  |  | Corriente [A] | 4.75 |  |  |  |  | Corriente [A] | 4.2 |  |  |  |  | Corriente [A] | 3.25
 |  |  |  |  |  | Vel Viento | 7 |  |  | Pres/Pmotor | 0.7680960615 | Vel Viento | 7 |  |  | Pres/Pmotor | 0.7626354165 | Vel Viento | 7 |  |  | Pres/Pmotor | 0.6788492595
 | Medición |  | Motor | Generador | Potencias |  | Medición |  | Motor | Generador | Potencias |  | Medición |  | Motor | Generador | Potencias
Omega | 2.6 | Omega [rpm] | 780 | 260 | 454.93931 | Omega | 3.36 | Omega [rpm] | 1008 | 336 | 553.8391601 | Omega | 3.86 | Omega [rpm] | 1158 | 386 | 562.8415823
Torque | 2.76 | Torque [Nm] | 5.56968 | 16.70904 |  | Torque | 2.6 | Torque [Nm] | 5.2468 | 15.7404 |  | Torque | 2.3 | Torque [Nm] | 4.6414 | 13.9242
Voltaje [V] | 58.4 |  |  |  | 344.56 | Voltaje [V] | 80 |  |  |  | 428 | Voltaje [V] | 93.6 |  |  |  | 435.24
Corriente [A] | 5.9 |  |  |  |  | Corriente [A] | 5.35 |  |  |  |  | Corriente [A] | 4.65
Vel Viento | 7.5 |  |  | Pres/Pmotor | 0.7573757475 | Vel Viento | 7.5 |  |  | Pres/Pmotor | 0.7727875363 | Vel Viento | 7.5 |  |  | Pres/Pmotor | 0.7732904137
 | Medición |  | Motor | Generador | Potencias |  | Medición |  | Motor | Generador | Potencias |  | Medición |  | Motor | Generador | Potencias
Omega | 2.96 | Omega [rpm] | 888 | 296 | 585.4871121 | Omega | 3.76 | Omega [rpm] | 1128 | 376 | 676.9821528 | Omega | 4.24 | Omega [rpm] | 1272 | 424 | 698.8922734
Torque | 3.12 | Torque [Nm] | 6.29616 | 18.88848 |  | Torque | 2.84 | Torque [Nm] | 5.73112 | 17.19336 |  | Torque | 2.6 | Torque [Nm] | 5.2468 | 15.7404
Voltaje [V] | 68 |  |  |  | 472.6 | Voltaje [V] | 88.8 |  |  |  | 532.8 | Voltaje [V] | 104 |  |  |  | 530.4
Corriente [A] | 6.95 |  |  |  |  | Corriente [A] | 6 |  |  |  |  | Corriente [A] | 5.1
Vel Viento | 8 |  |  | Pres/Pmotor | 0.8071911239 | Vel Viento | 8 |  |  | Pres/Pmotor | 0.7870222248 | Vel Viento | 8 |  |  | Pres/Pmotor | 0.7589152437
 | Medición |  | Motor | Generador | Potencias |  | Medición |  | Motor | Generador | Potencias
Omega | 3.4 | Omega [rpm] | 1020 | 340 | 758.7393621 | Omega | 4.22 | Omega [rpm] | 1266 | 422 | 834.7147341
Torque | 3.52 | Torque [Nm] | 7.10336 | 21.31008 |  | Torque | 3.12 | Torque [Nm] | 6.29616 | 18.88848
Voltaje [V] | 76.8 |  |  |  | 595.2 | Voltaje [V] | 98.4 |  |  |  | 649.44
Corriente [A] | 7.75 |  |  |  |  | Corriente [A] | 6.6
Vel Viento | 8.5 |  |  | Pres/Pmotor | 0.7844591038 | Vel Viento | 8.5 |  |  | Pres/Pmotor | 0.7780382608
 | Medición |  | Motor | Generador | Potencias
Omega | 3.76 | Omega [rpm] | 1128 | 376 | 915.3561502
Torque | 3.84 | Torque [Nm] | 7.74912 | 23.24736
Voltaje [V] | 84 |  |  |  | 730.8
Corriente [A] | 8.7
Vel Viento | 9 |  |  | Pres/Pmotor | 0.7983777678
