cnz95/SWTE_UTN_FRN_GESE_PID/conversión e inyección a la red/pruebas/med salida rect enero-2025/con placa V-I-P/barrido V1 25-03-15.xlsx

Res [Ohm] | Torque [%] | Voltaje [V] | Omega [%] | omega real [rpm]
10 | 2 | 9.5 | 8.33 | 145 |  |  |  | 1500 max omega
 | 2.5 | 13 | 12.41 | 198
 | 3 | 17.3 | 16.19 | 254
 | 3.5 | 22 | 19.54 | 317
 | 4 | 25.5 | 21.54 | 361
 | 4.5 | 28.9 | 25.2 | 408 | 21.6 | 19.78 | 307
 | 5 |  |  |  | 24.5 | 22.44 | 346
 | 5.5 |  |  |  | 27.5 | 25.25 | 387
 | 6 |  |  |  | 30.5 | 27.16 | 427
 | 6.5 |  |  |  | 33.6 | 29.96 | 470
 | 7 |  |  |  | 36.7 | 32.5 | 512
 | 7.5 |  |  |  | 47 a 100
 | 8
 | 8.5
 | 9
 | 9.5
 | 10
 | 10.5
 | 11
 | 11.5
 | 12
 | 12.5
 | 13
 | 13.5
 | 14
 | 14.5
 | 15
 | 15.5
 | 16
 | 16.5
 | 17
 | 17.5
 | 18
 | 18.5
 | 19
 | 19.5
 | 20
