cnz95/SWTE_UTN_FRN_GESE_PID/conversión e inyección a la red/pruebas/med salida rect enero-2025/con placa V-I-P/TWV_10_Ohm.csv

Torque Omega Voltaje
7.50 35.19 38.4
8.00 37.75 41.5
8.50 40.34 45.0
9.00 42.56 47.6
9.50 45.93 50.6
10.00 47.72 53.0
10.50 50.60 55.7
11.00 53.04 58.6
11.50 55.26 61.0
12.00 57.88 63.9
12.50 59.63 66.5
13.00 62.91 69.3
13.50 65.71 72.4
14.00 67.86 75.7
14.50 70.96 78.5
15.00 74.58 81.6
15.50 76.70 84.8
16.00 79.54 87.8
16.50 82.88 90.7
17.00 85.69 94.0
