cnz95/SWTE_UTN_FRN_GESE_PID/docs/pruebas lab/Simulacion en triangulo rev 1.xlsx

mt/seg | VL1 | VL2 | VL3 | IL1 | IL2 | IL3 | S | P | Q
9 | 78.36 | 84.5 | 83.59 | 7.04 | 6.92 | 7.75 | 1030.94 | 1030.8 | 16.93
9 | 76.3 | 82.17 | 81.28 | 6.87 | 6.75 | 7.59 | 980.35 | 980.21 | 16.35
9 | 75.84 | 81.95 | 81.12 | 6.87 | 6.75 | 7.61 | 977.37 | 977.23 | 16.79
9 | 76.01 | 82.1 | 81.25 | 6.89 | 6.77 | 7.64 | 982.95 | 982.8 | 16.79
8 | 62.68 | 7.66 | 67.01 | 5.69 | 5.58 | 6.3 | 668.39 | 668.29 | 11.24
8 | 62.49 | 67.53 | 66.9 | 5.67 | 5.57 | 6.29 | 665.34 | 665.25 | 11.34
8 | 63.78 | 68.87 | 68.22 | 5.79 | 5.68 | 6.41 | 692.56 | 692.46 | 11.73
8 | 62.66 | 67.51 | 66.96 | 5.68 | 5.57 | 6.29 | 666.58 | 666.48 | 11.33
8 | 63.01 | 68.09 | 67.47 | 5.63 | 5.51 | 6.08 | 659.21 | 659.12 | 10.73
8 | 61.46 | 66.34 | 65.73 | 5.5 | 5.38 | 5.49 | 627.44 | 627.35 | 10.23
7 | 50.68 | 54.55 | 54.1 | 4.52 | 4.43 | 4.89 | 425 | 424.94 | 7.08
7 | 49.51 | 53.44 | 52.98 | 4.43 | 4.33 | 4.77 | 406.59 | 406.53 | 6.89
6 | 39.72 | 42.76 | 42.44 | 3.55 | 3.47 | 3.82 | 260.84 | 260.8 | 4.61
6 | 37.54 | 40.5 | 40.22 | 3.66 | 3.28 | 3.72 | 233.9 | 233.86 | 4.29
5 | No encuentra punto de equilibrio
Promedio
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
