cnz95/SWTE_UTN_FRN_GESE_PID/docs/pruebas lab/Simulacion en triangulo.xlsx

mt/seg | VL1 | VL2 | VL3 | IL1 | IL2 | IL3 | S | P | Q
10 | Sale de rango de operación por velocidad
9 | 63.21 | 68.03 | 68.42 | 5.62 | 5.51 | 6.07 | 658.29 | 658.2 | 10.92
9 | 61.83 | 66.48 | 65.87 | 5.5 | 5.39 | 5.44 | 630.03 | 629.94 | 10.41
8 | 63.01 | 68.09 | 67.47 | 5.63 | 5.51 | 6.08 | 659.21 | 659.12 | 10.73
8 | 61.46 | 66.34 | 65.73 | 5.5 | 5.38 | 5.49 | 627.44 | 627.35 | 10.23
7 | 50.68 | 54.55 | 54.1 | 4.52 | 4.43 | 4.89 | 425 | 424.94 | 7.08
7 | 49.51 | 53.44 | 52.98 | 4.43 | 4.33 | 4.77 | 406.59 | 406.53 | 6.89
6 | 39.72 | 42.76 | 42.44 | 3.55 | 3.47 | 3.82 | 260.84 | 260.8 | 4.61
6 | 37.54 | 40.5 | 40.22 | 3.66 | 3.28 | 3.72 | 233.9 | 233.86 | 4.29
5 | No encuentra punto de equilibrio
Promedio
mt/seg | VL1 | VL2 | VL3 | IL1 | IL2 | IL3 | S | P | Q
9 | 62.52 | 67.255 | 67.145 | 5.56 | 5.45 | 5.755 | 644.16 | 644.07 | 10.665
8 | 62.235 | 67.215 | 66.6 | 5.565 | 5.445 | 5.785 | 643.325 | 643.235 | 10.48
7 | 50.095 | 53.995 | 53.54 | 4.475 | 4.38 | 4.83 | 415.795 | 415.735 | 6.985
6 | 38.63 | 41.63 | 41.33 | 3.605 | 3.375 | 3.77 | 247.37 | 247.33 | 4.45
