cnz95/SWTE_UTN_FRN_GESE_PID/conversión e inyección a la red/pruebas/med V-I vs T-W - 2025-04/VI vs TW.xlsx

Cargas [Ohm] | Torque [%] | Omega [%] | Va [V] | Vb [V] | Vc [V] | Ia [A] | Ib [A] | Ic [A]
60
 | 0.5
 | 0.75
 | 1
 | 1.25
 | 1.5
 | 1.75
 | 2
 | 2.25
 | 2.5 | 30
 | 2.75
 | 3 | 38
 | 3.25
 | 3.5 | 49
 | 3.75
 | 4 | 62
 | 4.25
 | 4.5 | 71
 | 4.75
 | 5
40
 | 0.5
 | 0.75
 | 1
 | 1.25
 | 1.5
 | 1.75
 | 2
 | 2.25
 | 2.5 | 30
 | 2.75
 | 3 | 38
 | 3.25
 | 3.5 | 49
 | 3.75
 | 4 | 62
 | 4.25
 | 4.5 | 71
 | 4.75
 | 5
 | 5.25
 | 5.5
20
 | 0.5
 | 1
 | 1.5
 | 2
 | 2.5
 | 3 | 33
 | 3.5 | 40
 | 4 | 48
 | 4.5 | 57
 | 5 | 66
 | 5.5
 | 6
 | 6.5
 | 7
10
 | 3
 | 3.5
 | 4
 | 4.5
 | 5
 | 5.5
 | 6
 | 6.5
 | 7
 | 7.5 | 38.4
 | 8 | 41.5
 | 8.5 | 45
 | 9 | 47.6
 | 9.5 | 50.6
 | 10 | 53
 | 10.5
 | 11
 | 11.5
 | 12
 | 12.5
 | 13
 | 13.5
 | 14
 | 14.5
 | 15
 | 15.5
 | 16
6.66
 | 1
 | 2
 | 3
 | 4
 | 5
 | 6
 | 7
 | 8
 | 9
 | 10
 | 11
 | 12
 | 13
 | 14
 | 15
 | 16
 | 17
 | 18
 | 19
 | 20
 | 21
 | 22
 | 23
 | 24
¿¿¿¿¿¿¿¿¿¿¿¿¿¿¿¿¿¿¿¿¿¿¿¿¿¿¿¿¿¿ 5 ????????????????????????????????????????????????????????????????????????????????????????????????????????????????
