cnz95/SWTE_UTN_FRN_GESE_PID/conversión e inyección a la red/pruebas/med V-I vs T-W - 2025-05/PIV(convertidor) vs TW - viento Mayo V2.xlsx

 |  |  |  |  | Fluke |  |  |  |  |  |  | Convertidor |  |  | Multímetros
VV [m/s] | Torque [V] | Torque [Nm] | Omega [V] | Omega [rpm] | V [V] | I [A] | P [W] | S [VA] | Q [VAr] | PF | DPF | P [W] | VDC [V] | Vred [V] | Vgen [V] | Igen [A] | * voltajes y corrientes son eficaces
3 | 0.096 | 2.94912 | 1.32 | 132 | 231.4 | 0.3 | 0 | 0.06 | 0.06 | -0.01 | -0.02 | 0 | 38.8 | 288 | 25.45 | 0.04
 |  |  |  |  | 231.4 | 0.3 | 0 | 0.06 | 0.06 | -0.01 | -0.02 | 0 | 41.2 | 288.4 | 22.21 | 0.03
 |  |  |  |  | 231.4 | 0.3 | 0 | 0.06 | 0.06 | -0.01 | -0.04 | 0 | 41.2 | 228.4 | 23.84 | 0.04
4 | 0.168 | 5.16096 | 1.8 | 180 | 231.8 | 0.2 | 0.03 | 0.06 | 0.05 | 0.48 | 0.52 | 24 | 40.1 | 228.1 | 34.46 | 0.83
 |  |  |  |  | 230.9 | 0.2 | 0.03 | 0.06 | 0.05 | 0.48 | 0.52 | 26 | 43.4 | 228 | 32.23 | 0.88
 |  |  |  |  | 230.8 | 0.2 | 0.03 | 0.06 | 0.05 | 0.47 | 0.51 | 26 | 43.4 | 228 | 33.09 | 0.79
5 | 0.248 | 7.61856 | 2 | 200 | 231.2 | 0.4 | 0.08 | 0.09 | 0.05 | 0.83 | 0.89 | 72.2 | 45.5 | 228.4 | 36.39 | 1.7
 |  |  |  |  | 231.1 | 0.4 | 0.07 | 0.09 | 0.05 | 0.83 | 0.88 | 86.9 | 45.4 | 228.5 | 36.19 | 1.74
 |  |  |  |  | 231.1 | 0.4 | 0.07 | 0.08 | 0.05 | 0.79 | 0.84 | 95.7 | 45.6 | 228.8 | 36.49 | 99
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
