cnz95/SWTE_UTN_FRN_GESE_PID/conversión e inyección a la red/pruebas/med V-I vs T-W - 2025-05/PIV(convertidor) vs TW - viento Mayo.xlsx

 |  |  |  |  | Fluke |  |  |  |  |  |  | Convertidor |  |  | Multímetros
VV [m/s] | Torque [V] | Torque [Nm] | Omega [V] | Omega [rpm] | V [V] | I [A] | P [W] | S [VA] | Q [VAr] | PF | DPF | P [W] | VDC [V] | Vred [V] | Vgen [V] | Igen [A] | * voltajes y corrientes son eficaces
6 | 0.344 | 10.56768 | 2.08 | 208 | 230.5 | 0.5 | 0.12 | 0.12 | 0.04 | 0.93 | 0.96 | 132 | 47.4 | 228.2 | 37.68 | 2.63
 |  |  |  |  | 230.4 | 0.6 | 0.12 | 0.13 | 0.04 | 0.94 | 0.96 | 145.5 | 46.6 | 228.2 | 37.84 | 2.54
 |  |  |  |  | 230.6 | 0.6 | 0.13 | 0.14 | 0.05 | 0.94 | 0.97 | 132.1 | 47 | 228.2 | 37.9 | 2.57
7 | 0.42 | 12.9024 | 2.32 | 232 | 230.7 | 0.9 | 0.2 | 0.2 | 0.06 | 0.96 | 0.99 | 223.3 | 52.4 | 228.7 | 41.81 | 3.59
 |  |  |  |  | 230.7 | 0.8 | 0.19 | 0.19 | 0.05 | 0.96 | 0.99 | 239.5 | 51.2 | 228.8 | 40.99 | 3.57
 |  |  |  |  | 230.8 | 0.9 | 0.19 | 0.2 | 0.06 | 0.96 | 0.99 | 238.4 | 53.4 | 228.7 | 42.69 | 3.57
8 | 0.6 | 18.432 | 3.2 | 320 | 232.1 | 1.7 | 0.38 | 0.39 | 0.05 | 0.99 | 1 | 437.5 | 70.5 | 229.7 | 57.01 | 5.31
 |  |  |  |  | 232.1 | 1.7 | 0.38 | 0.39 | 0.05 | 0.99 | 1 | 440 | 70.5 | 229.6 | 56.97 | 5.17
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
