cnz95/SWTE_UTN_FRN_GESE_PID/conversión e inyección a la red/pruebas/med V-I vs T-W - 2025-05/PIV(convertidor) vs TW.xlsx

Cargas [Ohm] | Torque [%] | Omega [%] | V [V] | I [A] | P [W] | VDC [V] | Vred [V] | V [V] | I [A] | I(punta+osc) [A] |  | * voltajes y corrientes son eficaces
60
 | 0.5
 | 0.75
 | 1
 | 1.25
 | 1.5
 | 1.75
 | 2
 | 2.25
 | 2.5 | 30
 | 2.75
 | 3 | 38
 | 3.25
 | 3.5 | 49
 | 3.75
 | 4 | 62
 | 4.25
 | 4.5 | 71
 | 4.75
 | 5
40
 | 0.5 |  |  |  |  |  |  |  |  |  |  | * v e i frec demasiado baja
 |  |  |  |  |  |  |  |  |  |  |  |  |  |  |  | T | W | V | I | P [W]
 |  |  |  |  |  |  |  |  |  |  |  |  |  |  | 40 | 2 | 11 | 10.2 | 0.51 | 5.202
 | 0.75 |  |  |  |  |  |  |  |  |  |  |  |  |  |  | 10 | 92 | 89.58 | 3.87 | 346.6746
 |  |  |  |  |  |  |  |  |  |  |  |  |  |  | 20 | 3 | 12 | 10.8 | 1.05 | 11.34
 |  |  |  |  |  |  |  |  |  |  |  |  |  |  |  | 17 | 95 | 86.6 | 7.48 | 647.768
 | 1 |  |  |  |  |  |  | 7 | 0.37 | 0.35 |  | * voltaje frec demasiado baja |  |  | 10 | 5 | 14 | 11.57 | 2.05 | 23.7185
 |  |  |  |  |  |  |  |  |  |  |  |  |  |  |  | 23 | 78 | 63.47 | 10.52 | 667.7044
 |  |  |  |  |  |  |  |  |  |  |  |  |  |  | 6.6 |  |  |  |  | 0
 | 1.25 |  |  |  |  |  |  |  |  |  |  |  |  |  |  |  |  |  |  | 0
 | 1.5 |  |  |  |  |  |  |  | 0.37 | 0.35 |  | * voltaje frec demasiado baja
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
