cnz95/SWTE_UTN_FRN_GESE_PID/conversión e inyección a la red/pruebas/med V-I vs T-W - 2025-06/PIV(convertidor) vs TW - viento V2 - Junio.xlsx

 |  |  |  |  | Fluke |  |  |  |  |  |  | Convertidor |  |  | Multímetros
VV [m/s] | Torque [V] | Torque [Nm] | Omega [V] | Omega [rpm] | V [V] | I [A] | P [W] | S [VA] | Q [VAr] | PF | DPF | P [W] | VDC [V] | Vred [V] | Vgen [V] | Igen [A] | * voltajes y corrientes son eficaces
3 | 0.088 | 2.70336 | 1.3 | 130 |  |  |  |  |  |  |  | 0 | 29.4 | 229.4 | 22.26 | 0.03
 |  |  |  |  |  |  |  |  |  |  |  | 0 | 33.1 | 229.4 | 19.97 | 0.04
 |  |  |  |  |  |  |  |  |  |  |  | 0 | 35.1 | 229.3 | 19.58 | 0.04
4 | 0.156 | 4.79232 | 1.76 | 176 |  |  |  |  |  |  |  | 26.1 | 41.1 | 229.8 | 34.88 | 0.87
 |  |  |  |  |  |  |  |  |  |  |  | 32.4 | 41 | 229.9 | 33.36 | 0.86
 |  |  |  |  |  |  |  |  |  |  |  | 36.8 | 43.6 | 229.8 | 33.44 | 0.86
5 | 0.236 | 7.24992 | 1.96 | 196 |  |  |  |  |  |  |  | 73.6 | 45 | 230.2 | 36.54 | 1.77
 |  |  |  |  |  |  |  |  |  |  |  | 72.9 | 44.9 | 229.9 | 36.1 | 1.52
 |  |  |  |  |  |  |  |  |  |  |  | 64.7 | 45 | 229.8 | 36.14 | 1.41
6 | 0.336 | 10.32192 | 2.08 | 208 |  |  |  |  |  |  |  | 136.7 | 46.6 | 229.8 | 37.81 | 2.78
 |  |  |  |  |  |  |  |  |  |  |  | 138.9 | 46.6 | 230 | 37.81 | 2.88
 |  |  |  |  |  |  |  |  |  |  |  | 141.4 | 46.5 | 230.1 | 37.42 | 2.49
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
