cnz95/SWTE_UTN_FRN_GESE_PID/conversión e inyección a la red/pruebas/med V-I vs T-W - 2025-07/PIV(convertidor) vs TW - viento V2.xlsx

Sheet: Hoja1
 |  |  |  |  | Fluke |  |  |  |  |  |  | Convertidor |  |  | Multímetros
VV [m/s] | Torque [V] | Torque [Nm] | Omega [V] | Omega [rpm] | V [V] | I [A] | P [W] | S [VA] | Q [VAr] | PF | DPF | P [W] | VDC [V] | Vred [V] | Vgen [V] | Igen [A] | * voltajes y corrientes son eficaces
3 | 0.076 | 2.33472 | 1.64 | 164 |  |  |  |  |  |  |  | 18 | 40 | 226.6 |  | 0.59
 |  |  |  |  |  |  |  |  |  |  |  | 25.2 | 42.9 | 226.8 |  | 0.55
 |  |  |  |  |  |  |  |  |  |  |  | 18.5 | 44.6 | 226.7 |  | 0.75
4 | 0.132 | 4.05504 | 2.12 | 212 |  |  |  |  |  |  |  | 54.3 | 52.5 | 227.3 |  | 1.2
 |  |  |  |  |  |  |  |  |  |  |  | 68.7 | 55.6 | 227.3 |  | 1.15
 |  |  |  |  |  |  |  |  |  |  |  | 62.1 | 54.6 | 227.3 |  | 1.37
5 | 0.22 | 6.7584 | 2.36 | 236 |  |  |  |  |  |  |  | 82 | 57.1 | 227.4 |  | 1.51
 |  |  |  |  |  |  |  |  |  |  |  | 78 | 57 | 227.5 |  | 1.56
 |  |  |  |  |  |  |  |  |  |  |  | 87.2 | 56.5 | 227.5 |  | 1.63
6 | 0.312 | 9.58464 | 2.84 | 284 |  |  |  |  |  |  |  | 227.2 | 69.8 | 228.8 |  | 3.11
 |  |  |  |  |  |  |  |  |  |  |  | 227.2 | 69.8 | 228.8 |  | 3.18
 |  |  |  |  |  |  |  |  |  |  |  | 224.3 | 68.9 | 229 |  | 3.15
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
