cnz95/SWTE_UTN_FRN_GESE_PID/conversión e inyección a la red/pruebas/medición potencia generada - 2022/prueba eolocal calc.xlsx

 | Torque vs rpm con vientos de 1m/s a 12m/s en pasos de 0.5m/s , Export File Created with QBlade v0.963 64bit on 11.01.2022 at 13:18:22
 |  | 10 | 9 | 8 | 7 | 6 | 5 | 4 | 3 | 2 | 1
 | R [Ohm] | 2 | 2.22 | 2.5 | 2.85 | 3.33 | 4 | 5 | 6.66 | 10 | 20
1 | V [V]
 | I [A]
 | P [W]
1.5 | V [V]
 | I [A]
 | P [W]
2 | V [V]
 | I [A]
 | P [W]
2.5 | V [V]
 | I [A]
 | P [W]
3 | V [V]
 | I [A]
 | P [W]
3.5 | V [V]
 | I [A]
 | P [W]
4 | V [V]
 | I [A]
 | P [W]
4.5 | V [V]
 | I [A]
 | P [W]
5 | V [V] | 0.6139 |  | 0.7626 |  | 0.9984 | 1.2301 | 1.2845 | 1.8278 | 3.3312 | 5.928
 | I [A] | 0.3289 |  | 0.34 |  | 0.3334 | 0.3515 | 0.29248 | 0.32392 | 0.3472 | 0.3352
 | P [W] | 0.20191171 | 0 | 0.259284 | 0 | 0.33286656 | 0.43238015 | 0.37569056 | 0.592060976 | 1.15659264 | 1.9870656
5.5 | V [V]
 | I [A]
 | P [W]
6 | V [V] | 1.1697 |  | 1.4033 |  | 1.8933 | 2.2772 | 2.5379 | 3.5831 | 6.1936 | 10.5814
 | I [A] | 0.6027 |  | 0.5942 |  | 0.6009 | 0.6094 | 0.54083 | 0.58641 | 0.6341 | 0.56744
 | P [W] | 0.70497819 | 0 | 0.83384086 | 0 | 1.13768397 | 1.38772568 | 1.372572457 | 2.101165671 | 3.92736176 | 6.004309616
6.5 | V [V]
 | I [A]
 | P [W]
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
