cnz95/SWTE_UTN_FRN_GESE_PID/conversión e inyección a la red/pruebas/medición salida generador - 2023/Simulación.xlsx

mt/seg | Vr | Vs | Vt | Ir | Is | It | S | P | Q
7 | 83.51 | 89.99 | 89.63 | 2.44 | 2.46 | 2.7 | 385 | 384.9 | 8.69
6 | 63.83 | 68.58 | 68.4 | 1.86 | 1.87 | 2.05 | 223.7 | 223.6 | 5.61
5 | 48.12 | 51.64 | 51.5 | 1.4 | 1.41 | 1.55 | 127.27 | 127.22 | 3.79
4 | 34.93 | 37.53 | 37.44 | 1.02 | 1.03 | 1.13 | 67.32 | 67.27 | 2.53
3 | No encuentra punto de equilibrio
2 | No encuentra punto de equilibrio
1 | No encuentra punto de equilibrio
