cnz95/SWTE_UTN_FRN_GESE_PID/conversión e inyección a la red/pruebas/medición salida generador - 2023/Simulación_v2.xlsx

mt/seg | Vr | Vs | Vt | Ir | Is | It | S | P | Q | m/seg | prom Vr | prom Vs | prom Vt | prom Ir | prom Is | prom It | prom S | prom P | prom Q
7 | 83.51 | 89.99 | 89.63 | 2.44 | 2.46 | 2.7 | 385 | 384.9 | 8.69 | 7 | 82.58 | 88.83666667 | 88.49 | 2.41 | 2.426666667 | 2.656666667 | 375.3233333 | 375.23 | 8.32
6 | 63.83 | 68.58 | 68.4 | 1.86 | 1.87 | 2.05 | 223.7 | 223.6 | 5.61 | 6 | 65.89333333 | 70.77666667 | 70.58333333 | 1.92 | 1.933333333 | 2.12 | 238.6566667 | 238.5733333 | 5.823333333
5 | 48.12 | 51.64 | 51.5 | 1.4 | 1.41 | 1.55 | 127.27 | 127.22 | 3.79 | 5 | 48.37666667 | 51.97333333 | 51.84 | 1.41 | 1.42 | 1.56 | 128.7833333 | 128.7333333 | 3.726666667
4 | 34.93 | 37.53 | 37.44 | 1.02 | 1.03 | 1.13 | 67.32 | 67.27 | 2.53 | 4 | 32.81333333 | 35.29666667 | 35.21666667 | 0.96 | 0.97 | 1.06 | 59.67 | 59.62333333 | 2.35
3 | No encuentra punto de equilibrio
2 | No encuentra punto de equilibrio
1 | No encuentra punto de equilibrio
mt/seg | Vr | Vs | Vt | Ir | Is | It | S | P | Q
7 | 81.45 | 87.39 | 87.06 | 2.37 | 2.39 | 2.61 | 363.43 | 363.34 | 8.22
6 | 67.64 | 72.8 | 72.6 | 1.97 | 1.99 | 2.18 | 252.17 | 252.1 | 5.9
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
