cnz95/SWTE_UTN_FRN_GESE_PID/conversión e inyección a la red/pruebas/med salida rect enero-2025/con placa V-I-P/rastreo umbral 50VDC V1 25-03-14.xlsx

 |  |  |  |  |  |  | Interpolados para obtener 50VDC
Cargas [Ohm] | Torque [%] | VDC [V] | Omega [%] |  | mTorque | mOmega | Omega [%] | Torque [%]
20 | 3 | 33 | 20 |  | 0.07142857143 | 0.7142857143 | 29.11 | 4.11
 | 3.5 | 40 | 25 |  | 0.0625 | 0.375 | 29.11 | 4.11
 | 4 | 48 | 28 |  | 0.05555555556 | 0.5555555556 | 29.11 | 4.11
 | 4.5 | 57 | 33 |  | 0.05555555556 | 0.5555555556 | 29.11 | 4.11
 | 5 | 66 | 38 |  |  |  | 29.11 | 4.11
40 | 2.5 | 30 | 22 |  | 0.0625 | 1 | 37.85 | 3.54
 | 3 | 38 | 30 |  | 0.04545454545 | 0.6363636364 | 37.85 | 3.54
 | 3.5 | 49 | 37 |  | 0.03846153846 | 0.8461538462 | 37.85 | 3.54
 | 4 | 62 | 48 |  | 0.05555555556 | 0.8888888889 | 37.85 | 3.54
 | 4.5 | 71 | 56 |  |  |  | 37.85 | 3.54
10 | 7.5 | 38.4 | 35.2 |  | 0.1612903226 | 0.8387096774 | 46.80 | 8.08
 | 8 | 41.5 | 37.8 |  | 0.1428571429 | 0.7142857143 | 46.80 | 8.08
 | 8.5 | 45 | 40.3 |  | 0.009090909091 | 1.058333333 | 46.80 | 8.08
 | 9 | 47.6 | 42.6 | inestable | 0.1851851852 | 0.9444444444 | 46.80 | 8.08
 | 9.5 | 50.6 | 45.9
 | 10 | 53 | 47.7 |  |  |  | 46.80 | 8.08
6.66 | 7 ???
