cnz95/SWTE_UTN_FRN_GESE_PID/docs/imgs otros/graf_prueba2_demo2.png

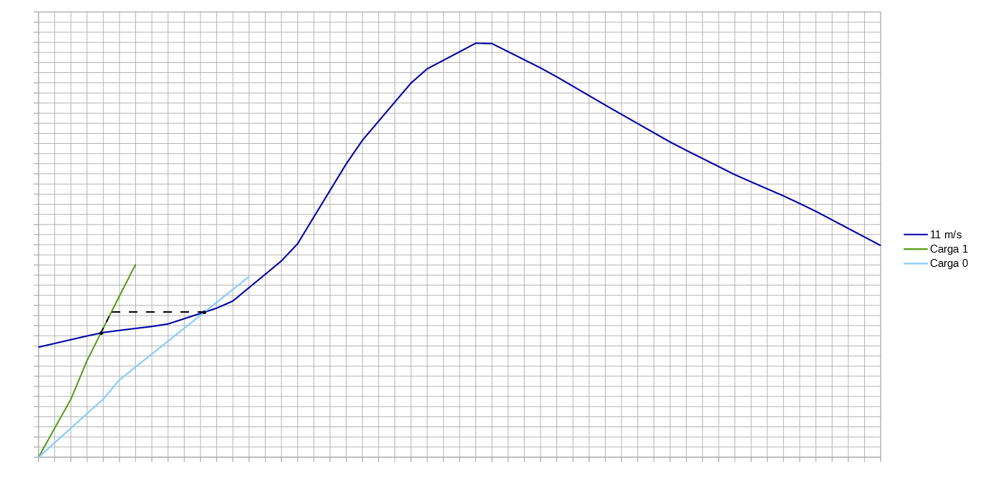
docs/imgs otros/graf_prueba2_demo2.png
