cnz95/SWTE_UTN_FRN_GESE_PID/docs/imgs otros/graph_test1_torque.png

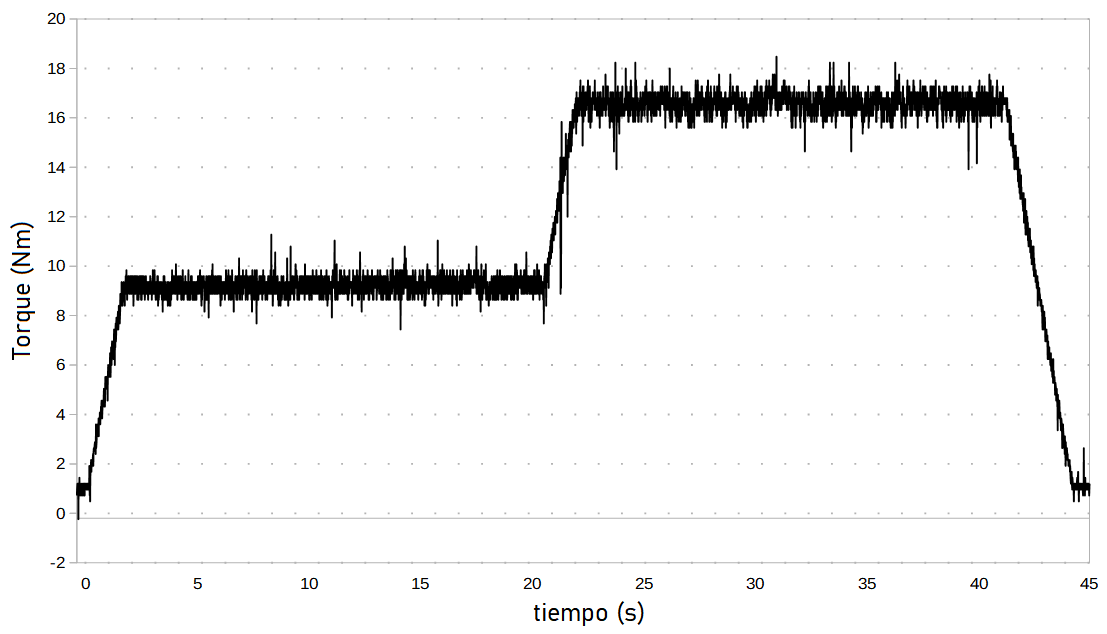
docs/imgs otros/graph_test1_torque.png
