cnz95/SWTE_UTN_FRN_GESE_PID/docs/imgs otros/graph_test3_speed.png

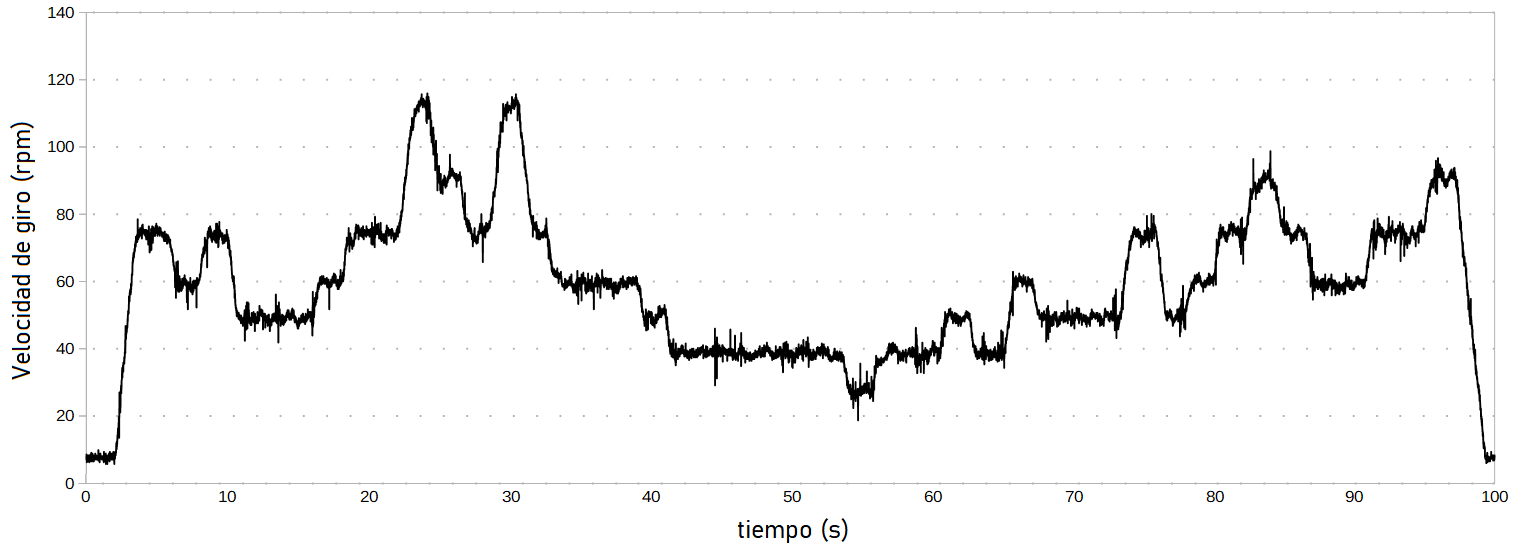
docs/imgs otros/graph_test3_speed.png
