cnz95/SWTE_UTN_FRN_GESE_PID/conversión e inyección a la red/rectificador trifásico/placa capacitores v3/rect_placa_pcb.pdf

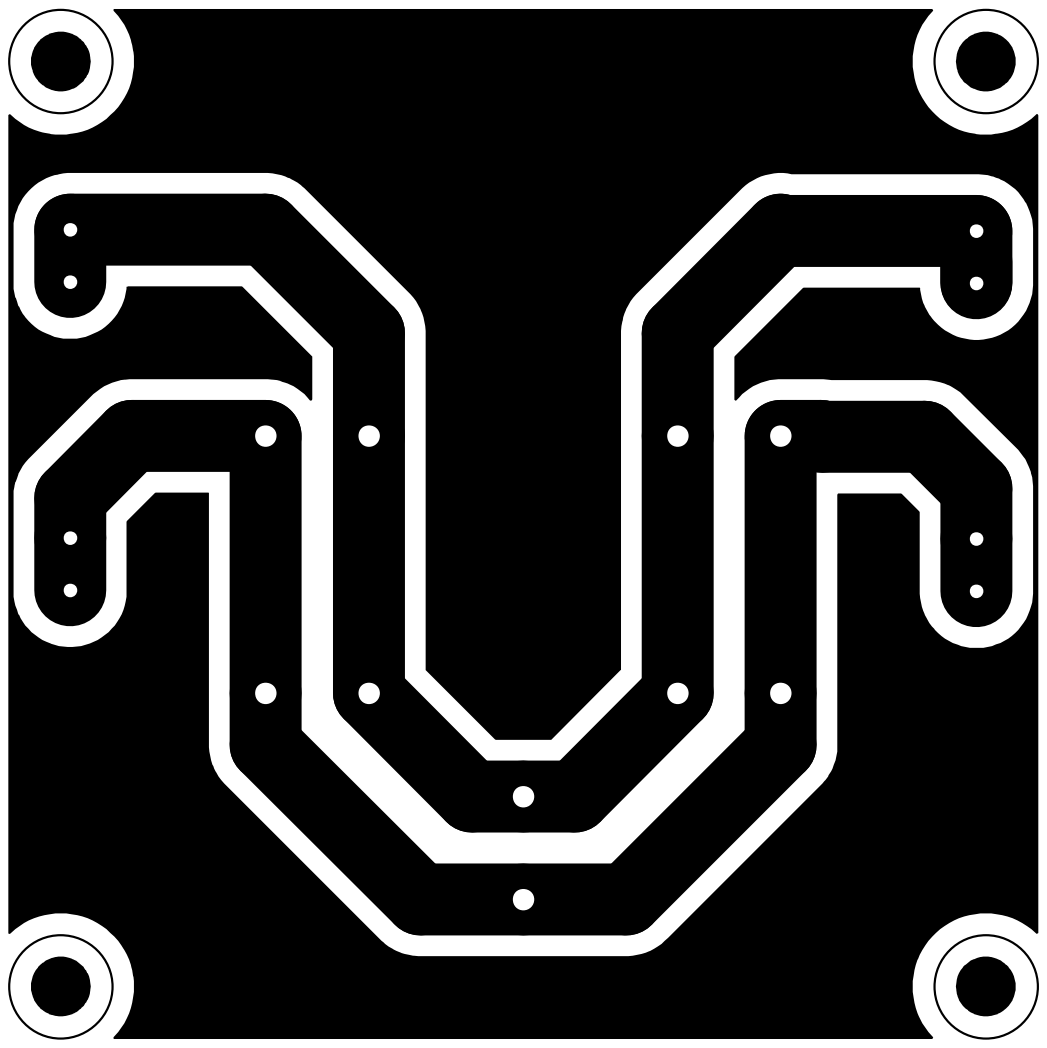
[picture p82: page 1]
