cnz95/SWTE_UTN_FRN_GESE_PID/conversión e inyección a la red/rectificador trifásico/placa capacitores v3/placa_v3.kicad_pcb

## KiCad design conversión e inyección a la red/rectificador trifásico/placa capacitores v3/placa_v3.kicad_pcb (2025-10-28)

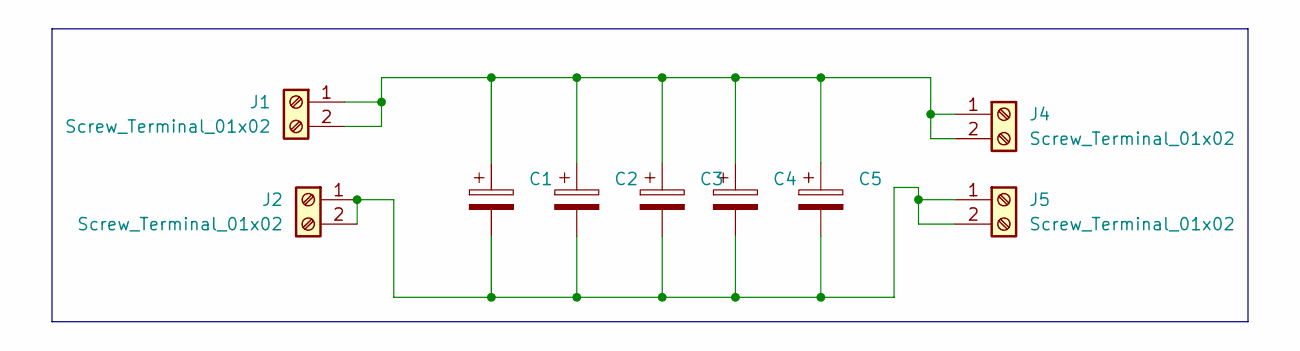
[picture p83: schematic placa_v3.kicad_sch]

Parts:
C1, C2, C3, C4, C5: C_Polarized; CP_Radial_D22.0mm_P10.00mm_SnapIn
J1, J2, J4, J5: Screw_Terminal_01x02; TerminalBlock_Phoenix_MKDS-1,5-2-5.08_1x02_P5.08mm_Horizont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

Connections:
unnamed: C1.1, C2.1, C3.1, C4.1, C5.1, J1.1, J1.2, J4.1, J4.2
unnamed: C1.2, C2.2, C3.2, C4.2, C5.2, J2.1, J2.2, J5.1, J5.2

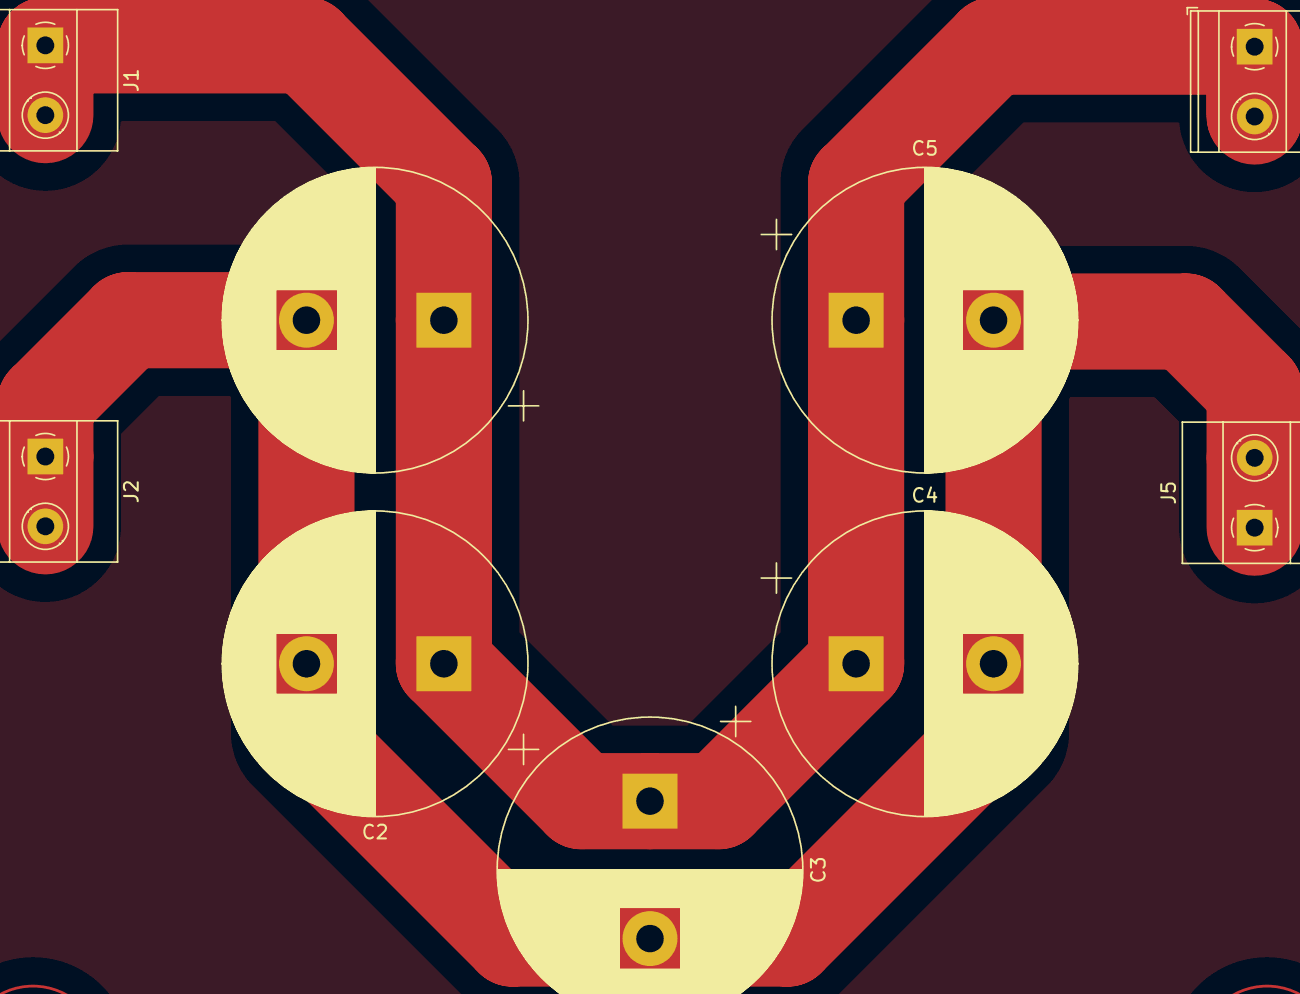
[picture p84: board placa_v3.kicad_pcb from above]

Board: 2 copper layers, 9 parts (0 on the bottom side), 2 nets.
