cnz95/SWTE_UTN_FRN_GESE_PID/partes/placa de control/placa micro PCB/WT_Interface/WT_ControlBoardV2.brd

## EAGLE design partes/placa de control/placa micro PCB/WT_Interface/WT_ControlBoardV2.brd (2025-10-28)

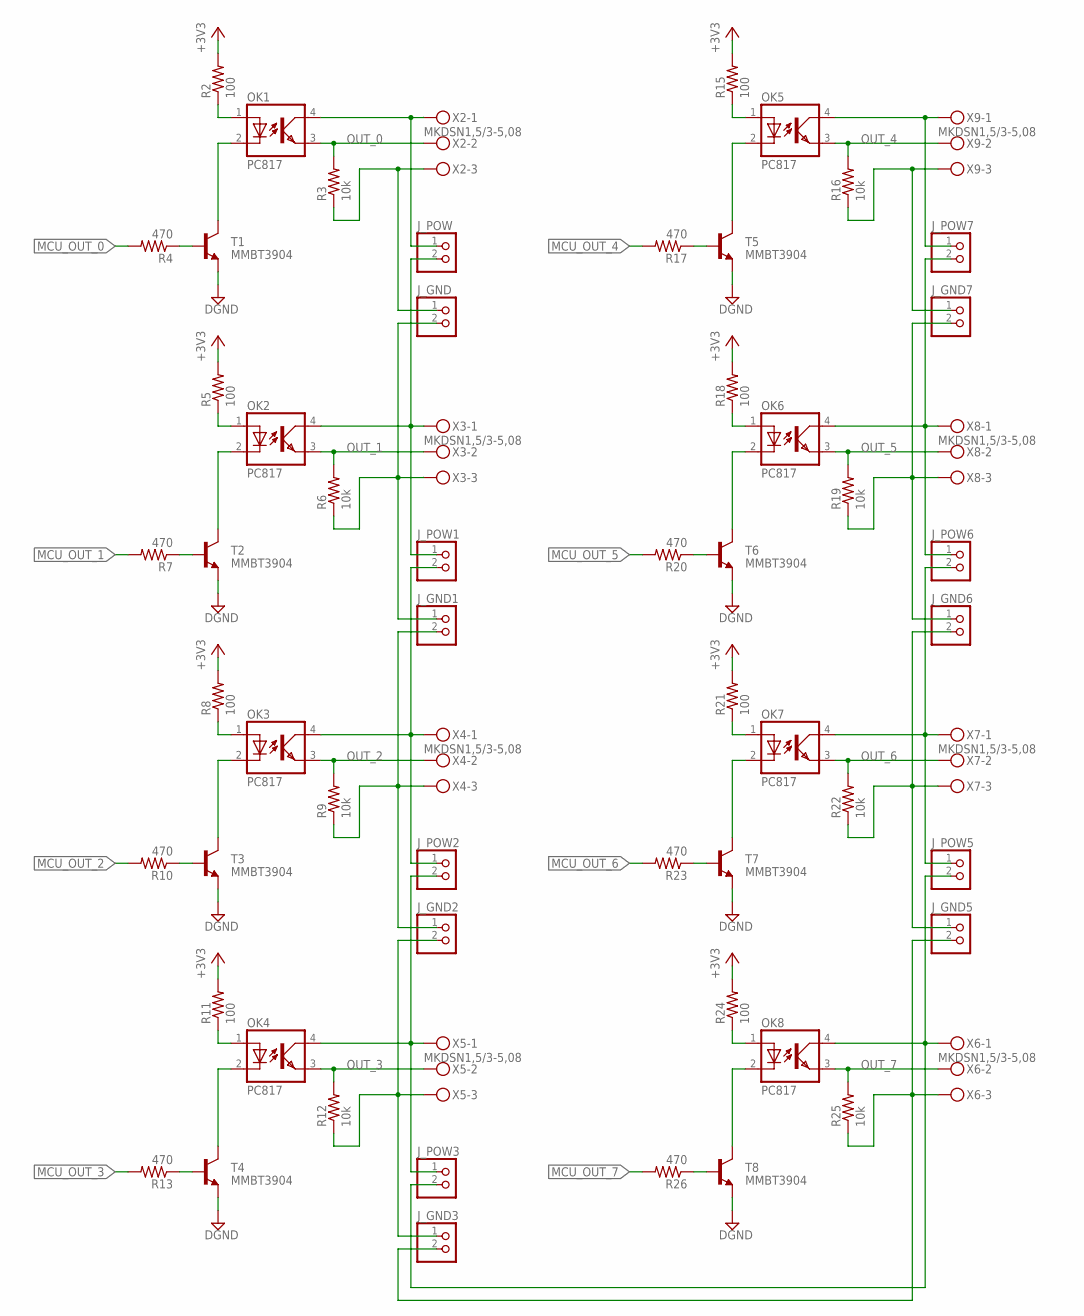
[picture p85: schematic WT_ControlBoardV2.sch, sheet 1, Outpus]

Parts:
J_GND, J_GND1, J_GND2, J_GND3, J_GND5, J_GND6, J_GND7: PINHD-1X2; 1X02
J_POW, J_POW1, J_POW2, J_POW3, J_POW5, J_POW6, J_POW7: PINHD-1X2; 1X02
OK1, OK2, OK3, OK4, OK5, OK6, OK7, OK8: PC817; DIL04
R2, R5, R8, R11, R15, R18, R21, R24: 100; R0402
R3, R6, R9, R12, R16, R19, R22, R25: 10k; R0402
R4, R7, R10, R13, R20, R23, R26: 470; 0204/5
R17: 470; 0204/7
T1, T2, T3, T4, T5, T6, T7, T8: MMBT3904; SOT23-BEC
X2, X3, X4, X5, X6, X7, X8, X9: MKDSN1,5/3-5,08

Connections:
+3V3: R2.2, R5.2, R8.2, R11.2, R15.2, R18.2, R21.2, R24.2; also elsewhere on the board
DGND: T1.E, T2.E, T3.E, T4.E, T5.E, T6.E, T7.E, T8.E; also elsewhere on the board
MCU_OUT_0: R4.2; also elsewhere on the board
MCU_OUT_1: R7.2; also elsewhere on the board
MCU_OUT_2: R10.2; also elsewhere on the board
MCU_OUT_3: R13.2; also elsewhere on the board
MCU_OUT_4: R17.2; also elsewhere on the board
MCU_OUT_5: R20.2; also elsewhere on the board
MCU_OUT_6: R23.2; also elsewhere on the board
MCU_OUT_7: R26.2; also elsewhere on the board
unnamed: OK1.2 (C), T1.C
unnamed: OK2.2 (C), T2.C
unnamed: R4.1, T1.B
unnamed: OK1.1 (A), R2.1
unnamed: R7.1, T2.B
unnamed: OK2.1 (A), R5.1
unnamed: OK3.2 (C), T3.C
unnamed: R10.1, T3.B
unnamed: OK3.1 (A), R8.1
unnamed: OK4.2 (C), T4.C
unnamed: R13.1, T4.B
unnamed: OK4.1 (A), R11.1
unnamed: OK5.2 (C), T5.C
unnamed: R17.1, T5.B
unnamed: OK5.1 (A), R15.1
unnamed: OK6.2 (C), T6.C
unnamed: R20.1, T6.B
unnamed: OK6.1 (A), R18.1
unnamed: OK7.2 (C), T7.C
unnamed: R23.1, T7.B
unnamed: OK7.1 (A), R21.1
unnamed: OK8.2 (C), T8.C
unnamed: R26.1, T8.B
unnamed: OK8.1 (A), R24.1
unnamed: J_GND6.1, J_GND7.2, R19.1, X8.3
unnamed: J_GND.1, R3.1, X2.3
unnamed: J_GND.2, J_GND1.1, R6.1, X3.3
unnamed: J_POW.2, J_POW1.1, OK2.4 (COL), X3.1
unnamed: J_POW1.2, J_POW2.1, OK3.4 (COL), X4.1
unnamed: J_GND1.2, J_GND2.1, R9.1, X4.3
unnamed: J_POW2.2, J_POW3.1, OK4.4 (COL), X5.1
unnamed: J_GND2.2, J_GND3.1, R12.1, X5.3
unnamed: J_GND3.2, J_GND5.2, R25.1, X6.3
unnamed: J_POW3.2, J_POW5.2, OK8.4 (COL), X6.1
unnamed: J_POW5.1, J_POW6.2, OK7.4 (COL), X7.1
unnamed: J_GND5.1, J_GND6.2, R22.1, X7.3
unnamed: J_POW6.1, J_POW7.2, OK6.4 (COL), X8.1
unnamed: J_POW7.1, OK5.4 (COL), X9.1
unnamed: J_GND7.1, R16.1, X9.3
unnamed: J_POW.1, OK1.4 (COL), X2.1
OUT_0: OK1.3 (EMIT), R3.2, X2.2
OUT_1: OK2.3 (EMIT), R6.2, X3.2
OUT_2: OK3.3 (EMIT), R9.2, X4.2
OUT_3: OK4.3 (EMIT), R12.2, X5.2
OUT_4: OK5.3 (EMIT), R16.2, X9.2
OUT_5: OK6.3 (EMIT), R19.2, X8.2
OUT_6: OK7.3 (EMIT), R22.2, X7.2
OUT_7: OK8.3 (EMIT), R25.2, X6.2

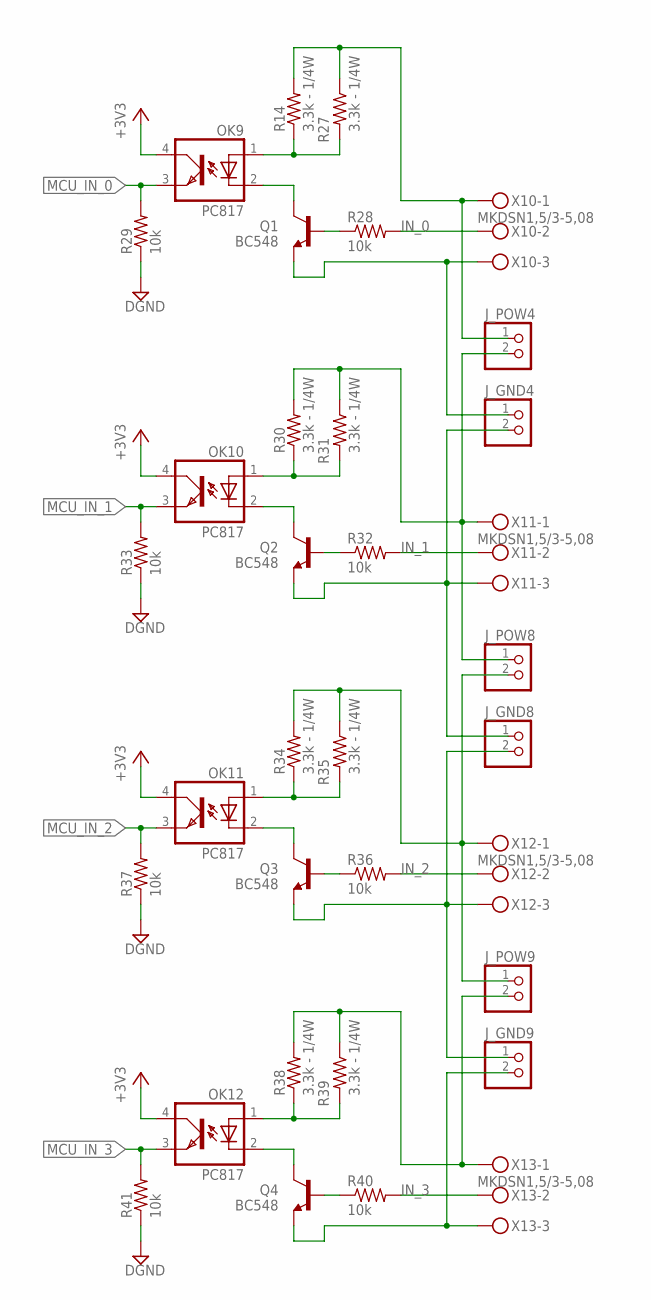
[picture p86: schematic WT_ControlBoardV2.sch, sheet 2, Inputs]

Parts:
J_GND4, J_GND8, J_GND9: PINHD-1X2; 1X02
J_POW4, J_POW8, J_POW9: PINHD-1X2; 1X02
OK9, OK10, OK11, OK12: PC817; DIL04
Q1, Q2, Q3, Q4: BC548; TO92-EBC
R14, R27, R30, R31, R34, R35, R38, R39: 3.3k - 1/4W; 0204V
R28, R32, R36, R40: 10k; 0204/5
R29, R33, R37, R41: 10k; R0402
X10, X11, X12, X13: MKDSN1,5/3-5,08

Connections:
+3V3: OK9.4 (COL), OK10.4 (COL), OK11.4 (COL), OK12.4 (COL); also elsewhere on the board
DGND: R29.1, R33.1, R37.1, R41.1; also elsewhere on the board
IN_0: R28.2, X10.2
IN_1: R32.2, X11.2
IN_2: R36.2, X12.2
IN_3: R40.2, X13.2
MCU_IN_0: OK9.3 (EMIT), R29.2; also elsewhere on the board
MCU_IN_1: OK10.3 (EMIT), R33.2; also elsewhere on the board
MCU_IN_2: OK11.3 (EMIT), R37.2; also elsewhere on the board
MCU_IN_3: OK12.3 (EMIT), R41.2; also elsewhere on the board
unnamed: OK9.1 (A), R14.1, R27.2
unnamed: OK9.2 (C), Q1.C
unnamed: Q1.B, R28.1
unnamed: OK10.1 (A), R30.1, R31.2
unnamed: OK10.2 (C), Q2.C
unnamed: Q2.B, R32.1
unnamed: OK11.1 (A), R34.1, R35.2
unnamed: OK11.2 (C), Q3.C
unnamed: Q3.B, R36.1
unnamed: OK12.1 (A), R38.1, R39.2
unnamed: OK12.2 (C), Q4.C
unnamed: Q4.B, R40.1
unnamed: J_GND4.2, J_GND8.1, Q2.E, X11.3
unnamed: J_GND9.2, Q4.E, X13.3
unnamed: J_POW9.2, R38.2, R39.1, X13.1
unnamed: J_POW4.2, J_POW8.1, R30.2, R31.1, X11.1
unnamed: J_GND8.2, J_GND9.1, Q3.E, X12.3
unnamed: J_POW8.2, J_POW9.1, R34.2, R35.1, X12.1
unnamed: J_GND4.1, Q1.E, X10.3
unnamed: J_POW4.1, R14.2, R27.1, X10.1

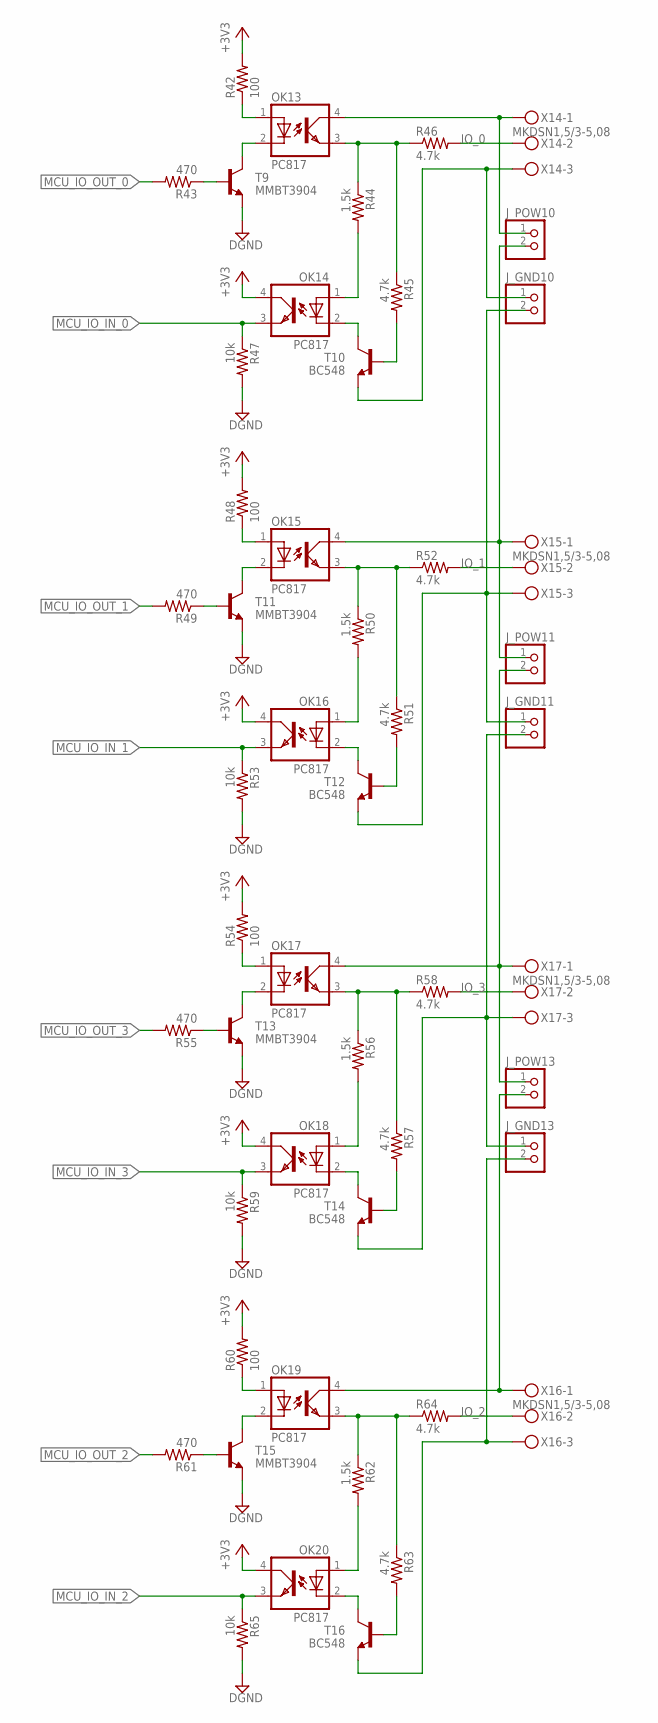
[picture p87: schematic WT_ControlBoardV2.sch, sheet 3, Bidirectional]

Parts:
J_GND10, J_GND11, J_GND13: PINHD-1X2; 1X02
J_POW10, J_POW11, J_POW13: PINHD-1X2; 1X02
OK13, OK14, OK15, OK16, OK17, OK18, OK19, OK20: PC817; DIL04
R42, R48, R54, R60: 100; 0204/7
R43, R49, R55, R61: 470; R0402
R44, R50, R56, R62: 1.5k; 0204/5
R45, R46, R51, R52, R57, R58, R63, R64: 4.7k; 0204V
R47, R53, R59, R65: 10k; 0204/5
T9, T11, T13, T15: MMBT3904; SOT23-BEC
T10, T12, T14, T16: BC548; TO92-CBE
X14, X15, X16, X17: MKDSN1,5/3-5,08

Connections:
+3V3: OK14.4 (COL), OK16.4 (COL), OK18.4 (COL), OK20.4 (COL), R42.2, R48.2, R54.2, R60.2; also elsewhere on the board
DGND: R47.2, R53.2, R59.2, R65.2, T9.E, T11.E, T13.E, T15.E; also elsewhere on the board
IO_0: R46.2, X14.2
IO_1: R52.2, X15.2
IO_2: R64.2, X16.2
IO_3: R58.2, X17.2
MCU_IO_IN_0: OK14.3 (EMIT), R47.1; also elsewhere on the board
MCU_IO_IN_1: OK16.3 (EMIT), R53.1; also elsewhere on the board
MCU_IO_IN_2: OK20.3 (EMIT), R65.1; also elsewhere on the board
MCU_IO_IN_3: OK18.3 (EMIT), R59.1; also elsewhere on the board
MCU_IO_OUT_0: R43.2; also elsewhere on the board
MCU_IO_OUT_1: R49.2; also elsewhere on the board
MCU_IO_OUT_2: R61.2; also elsewhere on the board
MCU_IO_OUT_3: R55.2; also elsewhere on the board
unnamed: OK14.2 (C), T10.C
unnamed: OK13.2 (C), T9.C
unnamed: R43.1, T9.B
unnamed: OK13.1 (A), R42.1
unnamed: OK13.3 (EMIT), R44.1, R45.1, R46.1
unnamed: OK14.1 (A), R44.2
unnamed: R45.2, T10.B
unnamed: OK16.2 (C), T12.C
unnamed: OK15.2 (C), T11.C
unnamed: R49.1, T11.B
unnamed: OK15.1 (A), R48.1
unnamed: OK15.3 (EMIT), R50.1, R51.1, R52.1
unnamed: OK16.1 (A), R50.2
unnamed: R51.2, T12.B
unnamed: OK18.2 (C), T14.C
unnamed: OK17.2 (C), T13.C
unnamed: R55.1, T13.B
unnamed: OK17.1 (A), R54.1
unnamed: OK17.3 (EMIT), R56.1, R57.1, R58.1
unnamed: OK18.1 (A), R56.2
unnamed: R57.2, T14.B
unnamed: OK20.2 (C), T16.C
unnamed: OK19.2 (C), T15.C
unnamed: R61.1, T15.B
unnamed: OK19.1 (A), R60.1
unnamed: OK19.3 (EMIT), R62.1, R63.1, R64.1
unnamed: OK20.1 (A), R62.2
unnamed: R63.2, T16.B
unnamed: J_POW11.2, J_POW13.1, OK17.4 (COL), X17.1
unnamed: J_GND13.2, T16.E, X16.3
unnamed: J_POW10.1, OK13.4 (COL), X14.1
unnamed: J_GND10.1, T10.E, X14.3
unnamed: J_POW10.2, J_POW11.1, OK15.4 (COL), X15.1
unnamed: J_GND10.2, J_GND11.1, T12.E, X15.3
unnamed: J_GND11.2, J_GND13.1, T14.E, X17.3
unnamed: J_POW13.2, OK19.4 (COL), X16.1

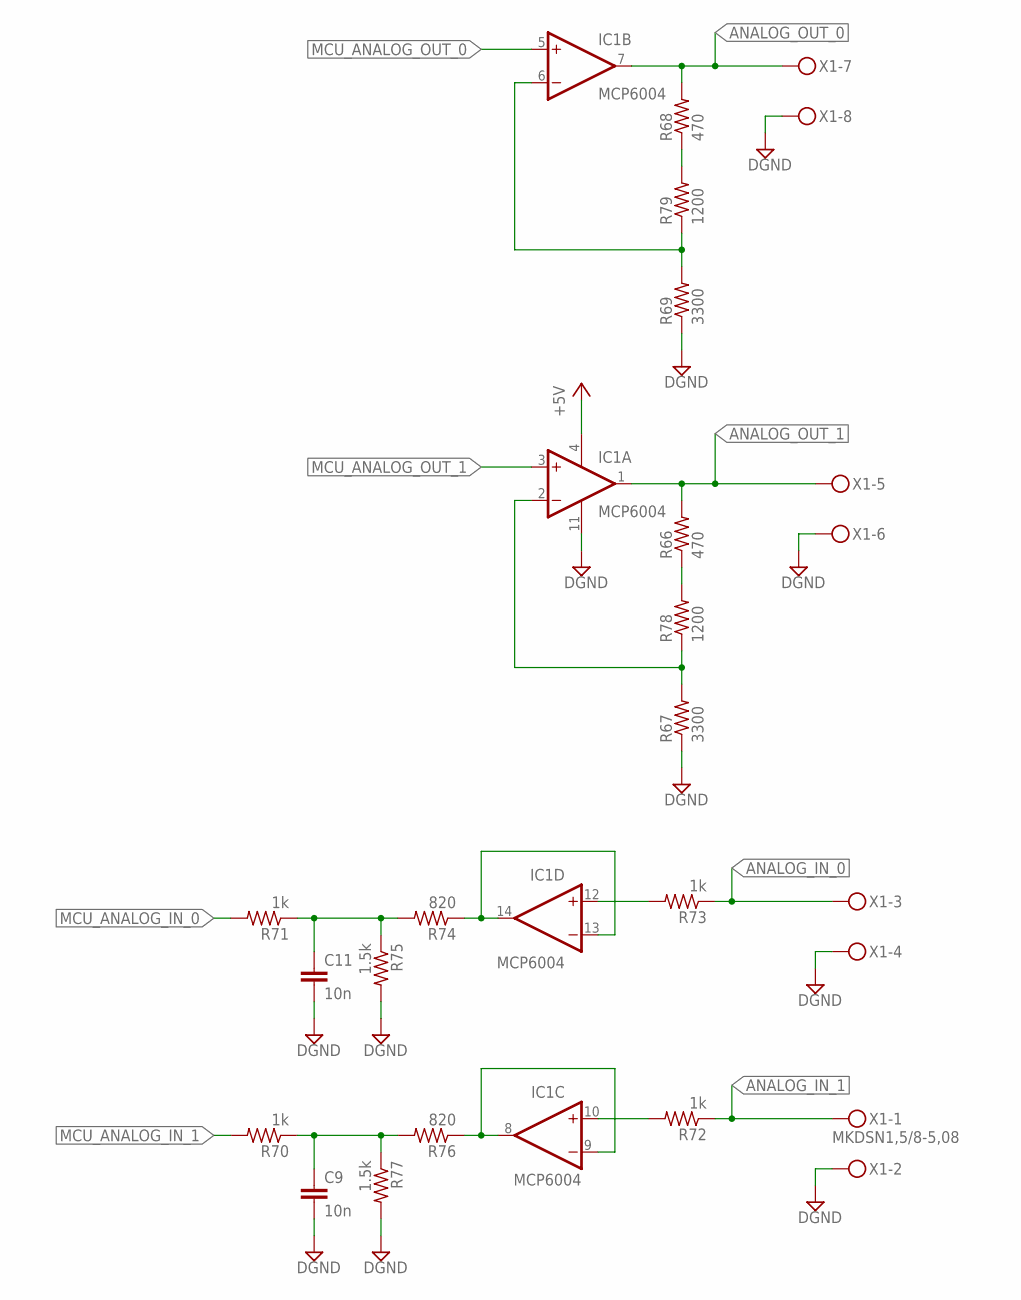
[picture p88: schematic WT_ControlBoardV2.sch, sheet 4, Analog IO]

Parts:
C9, C11: 10n; C0402
IC1: MCP6004; SO14
R66, R68: 470; R0402
R67, R69: 3300; R0402
R70, R71: 1k; R0402
R72: 1k; 0204V
R73: 1k; 0204/7
R74, R76: 820; R0402
R75, R77: 1.5k; R0402
R78, R79: 1200; R0402
X1: MKDSN1,5/8-5,08

Connections:
+5V: IC1.4 (V+); also elsewhere on the board
ANALOG_IN_0: R73.1, X1.3
ANALOG_IN_1: R72.1, X1.1
ANALOG_OUT_0: IC1.7 (OUT), R68.2, X1.7
ANALOG_OUT_1: IC1.1 (OUT), R66.2, X1.5
DGND: C9.2, C11.2, IC1.11 (V-), R67.1, R69.1, R75.2, R77.2, X1.2, X1.4, X1.6, X1.8; also elsewhere on the board
MCU_ANALOG_IN_0: R71.2; also elsewhere on the board
MCU_ANALOG_IN_1: R70.2; also elsewhere on the board
MCU_ANALOG_OUT_0: IC1.5 (+IN); also elsewhere on the board
MCU_ANALOG_OUT_1: IC1.3 (+IN); also elsewhere on the board
unnamed: IC1.6 (-IN), R69.2, R79.1
unnamed: IC1.2 (-IN), R67.2, R78.1
unnamed: IC1.10 (+IN), R72.2
unnamed: IC1.12 (+IN), R73.2
unnamed: IC1.8 (OUT), IC1.9 (-IN), R76.1
unnamed: IC1.13 (-IN), IC1.14 (OUT), R74.1
unnamed: C9.1, R70.1, R76.2, R77.1
unnamed: C11.1, R71.1, R74.2, R75.1
unnamed: R66.1, R78.2
unnamed: R68.1, R79.2

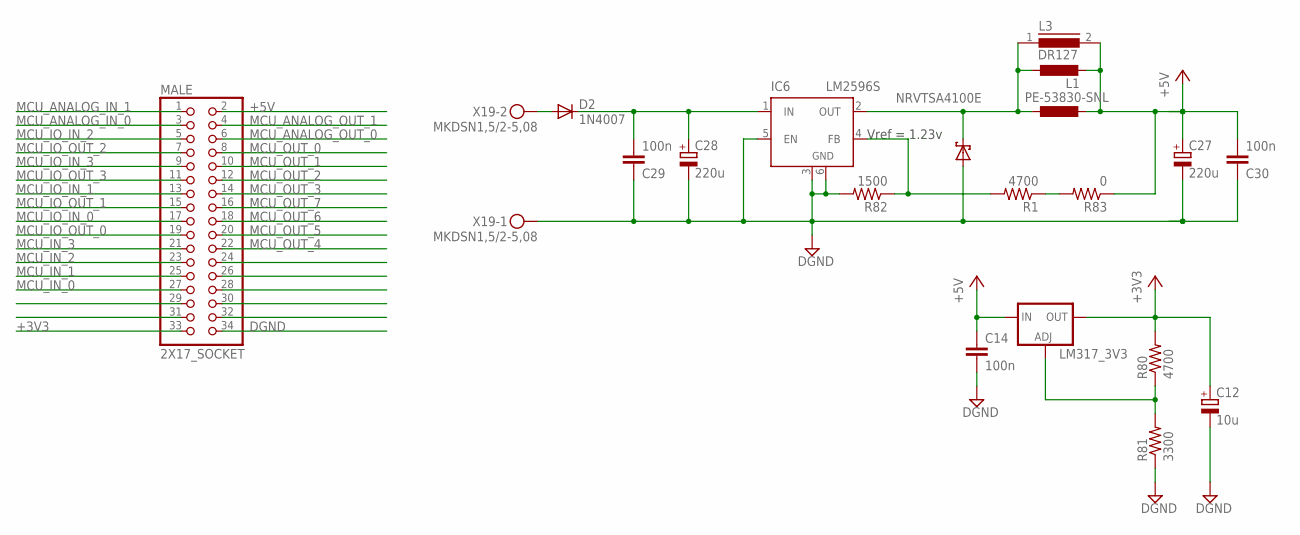
[picture p89: schematic WT_ControlBoardV2.sch, sheet 5, Power]

Parts:
C12: 10u; E1,8-4
C14, C29, C30: 100n; C1206
C27, C28: 220u; E5-10,5
D2: 1N4007; C1702-05
D8: NRVTSA4100E; SMA-2
IC6: LM2596S; TO263-5
L1: L-EUPIS2816; PIS2816
L2: PE-53830-SNL; LCI-44
L3: DR127
LM317_3V3: LM317TS; 317TS
MALE: 2X17_SOCKET
R1: 4700; R0402
R80: 4700; 0204V
R81: 3300; 0204V
R82: 1500; R0402
R83: 0; R0402
X19: MKDSN1,5/2-5,08

Connections:
+3V3: C12.+, LM317_3V3.2 (OUT), MALE.33, R80.2; also elsewhere on the board
+5V: C14.1, C27.+, C30.2, L1.2, L2.1, L3.2, LM317_3V3.3 (IN), MALE.2, R83.1; also elsewhere on the board
DGND: C12.-, C14.2, C27.-, C28.-, C29.1, C30.1, D8.A, IC6.3 (GND), IC6.5 (EN), IC6.6 (GND), MALE.34, R81.1, R82.2, X19.1; also elsewhere on the board
MCU_ANALOG_IN_0: MALE.3; also elsewhere on the board
MCU_ANALOG_IN_1: MALE.1; also elsewhere on the board
MCU_ANALOG_OUT_0: MALE.6; also elsewhere on the board
MCU_ANALOG_OUT_1: MALE.4; also elsewhere on the board
MCU_IN_0: MALE.27; also elsewhere on the board
MCU_IN_1: MALE.25; also elsewhere on the board
MCU_IN_2: MALE.23; also elsewhere on the board
MCU_IN_3: MALE.21; also elsewhere on the board
MCU_IO_IN_0: MALE.17; also elsewhere on the board
MCU_IO_IN_1: MALE.13; also elsewhere on the board
MCU_IO_IN_2: MALE.5; also elsewhere on the board
MCU_IO_IN_3: MALE.9; also elsewhere on the board
MCU_IO_OUT_0: MALE.19; also elsewhere on the board
MCU_IO_OUT_1: MALE.15; also elsewhere on the board
MCU_IO_OUT_2: MALE.7; also elsewhere on the board
MCU_IO_OUT_3: MALE.11; also elsewhere on the board
MCU_OUT_0: MALE.8; also elsewhere on the board
MCU_OUT_1: MALE.10; also elsewhere on the board
MCU_OUT_2: MALE.12; also elsewhere on the board
MCU_OUT_3: MALE.14; also elsewhere on the board
MCU_OUT_4: MALE.22; also elsewhere on the board
MCU_OUT_5: MALE.20; also elsewhere on the board
MCU_OUT_6: MALE.18; also elsewhere on the board
MCU_OUT_7: MALE.16; also elsewhere on the board
unnamed: D2.A, X19.2
unnamed: D8.C, IC6.2 (OUT), L1.1, L2.2, L3.1
unnamed: C28.+, C29.2, D2.C, IC6.1 (IN)
unnamed: LM317_3V3.1 (ADJ), R80.1, R81.2
unnamed: IC6.4 (FB), R1.2, R82.1
unnamed: R1.1, R83.2

Notes on the sheet:
Vref = 1.23v

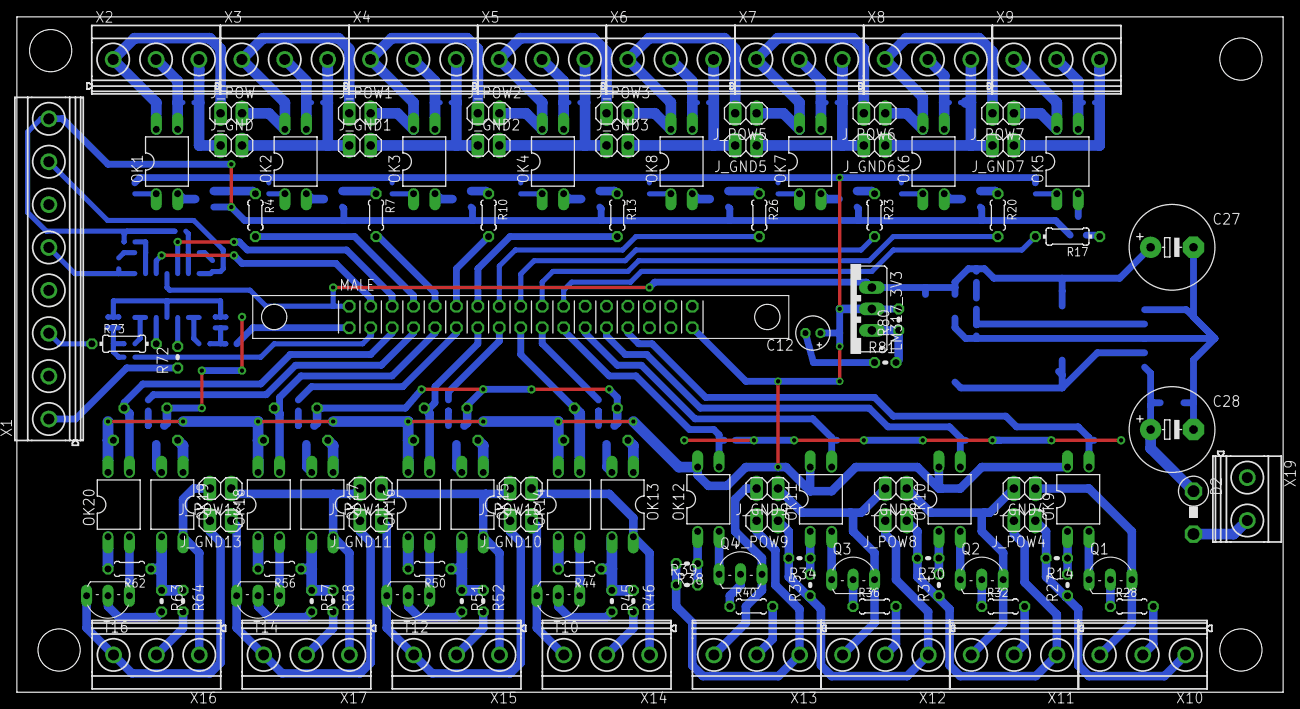
[picture p90: board WT_ControlBoardV2.brd from above]

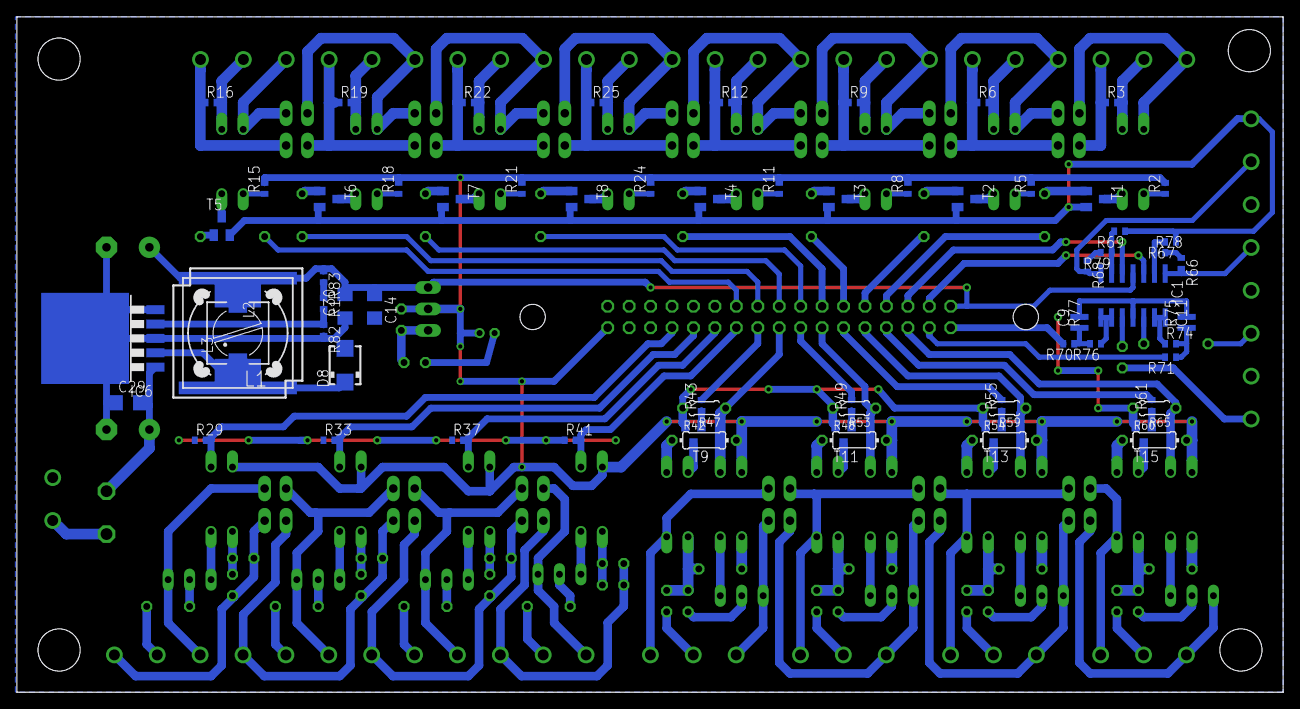
[picture p91: board WT_ControlBoardV2.brd from below]

Board: 2 copper layers, 150.0 x 80.0 mm, 184 parts (70 on the bottom side), 159 nets.
