cnz95/SWTE_UTN_FRN_GESE_PID/partes/placa de control/placa micro PCB/WT_Interface/ControlBoardUsb.brd

## EAGLE design partes/placa de control/placa micro PCB/WT_Interface/ControlBoardUsb.brd (2025-10-28)

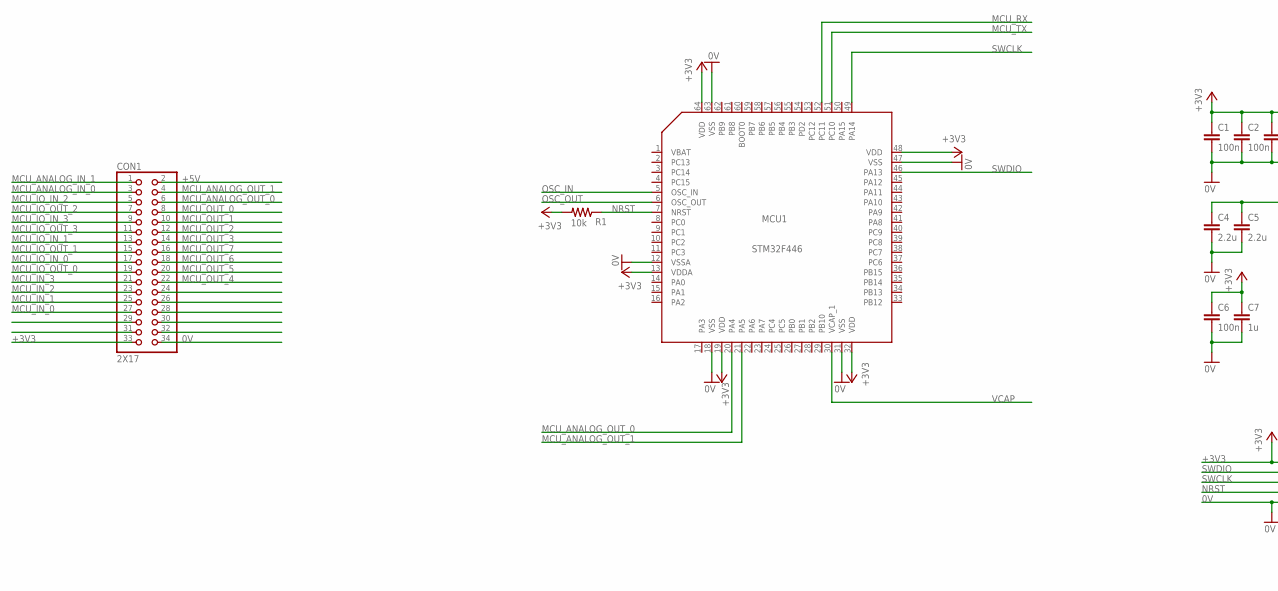
[picture p92: schematic ControlBoardUsb.sch, part in row 1, column 1]

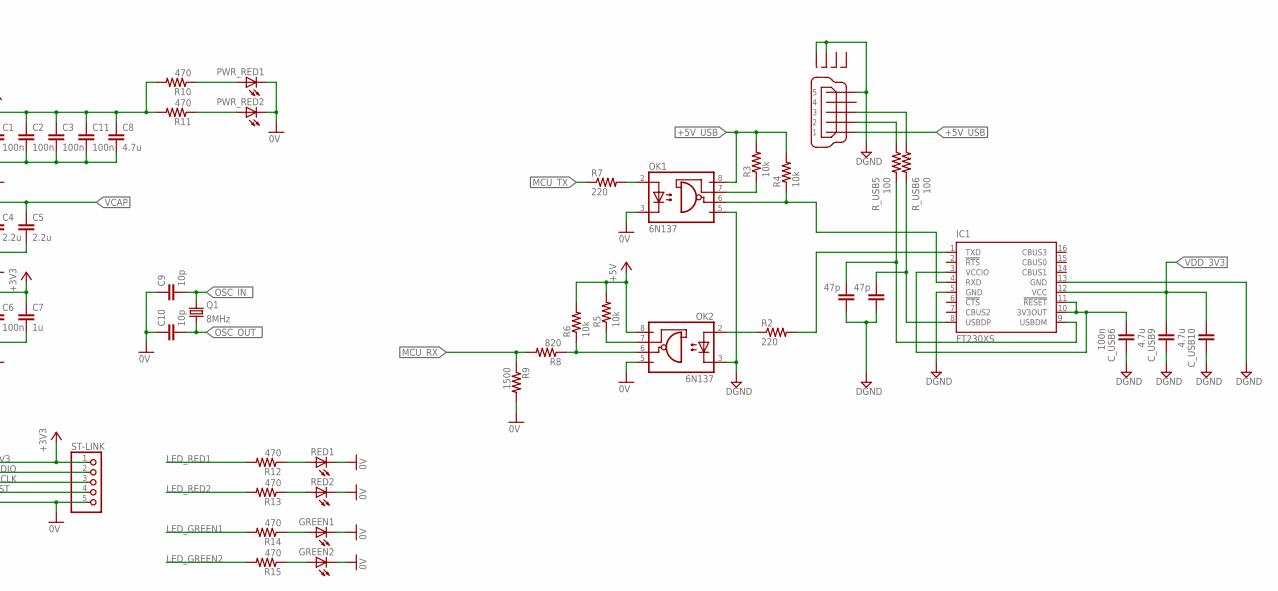
[picture p93: schematic ControlBoardUsb.sch, part in row 1, column 2]

Parts:
C1, C2, C3, C6, C11: 100n; C0402
C4, C5: 2.2u; C0402
C7: 1u; C0402
C8: 4.7u; C0402
C9, C10: 10p; C0402
CON1: 2X17
CON3: MICRO_USB_TYPE_A; MINI_USB_TYPE_A_THOLE
C_USB6: 100n; C0402
C_USB7, C_USB8: 47p; C0402
C_USB9, C_USB10: 4.7u; C0402
GREEN1, GREEN2: LEDCHIP-LED0805; CHIP-LED0805
IC1: FT230XS; SSOP16
MCU1: STM32F446; LQFP-64
OK1, OK2: 6N137; DIL08
PWR_RED1, PWR_RED2: LEDCHIP-LED0805; CHIP-LED0805
Q1: 8MHz; HC33U-V
R1, R3, R4, R5, R6: 10k; R0402
R2, R7: 220; R0402
R8: 820; R0402
R9: 1500; R0402
R10, R11, R12, R13, R14, R15: 470; R0402
RED1, RED2: LEDCHIP-LED0805; CHIP-LED0805
R_USB5, R_USB6: 100; R0402
ST-LINK: PINHD-1X5/90; 1X05/90

Connections:
0V: C1.2, C2.2, C3.2, C4.2, C5.2, C6.2, C7.2, C8.2, C9.1, C10.1, C11.2, CON1.34, GREEN1.C, GREEN2.C, MCU1.12 (VSSA), MCU1.18 (VSS), MCU1.31 (VSS), MCU1.47 (VSS), MCU1.63 (VSS), OK1.3 (C), OK2.5 (GND), PWR_RED1.C, PWR_RED2.C, R9.2, RED1.C, RED2.C, ST-LINK.5
+3V3: C1.1, C2.1, C3.1, C6.1, C7.1, C8.1, C11.1, CON1.33, MCU1.13 (VDDA), MCU1.19 (VDD), MCU1.32 (VDD), MCU1.48 (VDD), MCU1.64 (VDD), R1.2, R10.2, R11.2, ST-LINK.1
+5V: CON1.2, OK2.8 (VCC), R5.2, R6.2
+5V_USB: CON3.1, OK1.8 (VCC), R3.2, R4.2
DGND: CON3.5, CON3.M3 (S3), CON3.M4 (S4), C_USB6.1, C_USB7.1, C_USB8.1, C_USB9.1, C_USB10.1, IC1.5 (GND), IC1.13 (GND), OK1.5 (GND), OK2.3 (C)
LED_GREEN1: R14.2
LED_GREEN2: R15.2
LED_RED1: R12.2
LED_RED2: R13.2
MCU_ANALOG_IN_0: CON1.3
MCU_ANALOG_IN_1: CON1.1
MCU_ANALOG_OUT_0: CON1.6, MCU1.20 (PA4)
MCU_ANALOG_OUT_1: CON1.4, MCU1.21 (PA5)
MCU_IN_0: CON1.27
MCU_IN_1: CON1.25
MCU_IN_2: CON1.23
MCU_IN_3: CON1.21
MCU_IO_IN_0: CON1.17
MCU_IO_IN_1: CON1.13
MCU_IO_IN_2: CON1.5
MCU_IO_IN_3: CON1.9
MCU_IO_OUT_0: CON1.19
MCU_IO_OUT_1: CON1.15
MCU_IO_OUT_2: CON1.7
MCU_IO_OUT_3: CON1.11
MCU_OUT_0: CON1.8
MCU_OUT_1: CON1.10
MCU_OUT_2: CON1.12
MCU_OUT_3: CON1.14
MCU_OUT_4: CON1.22
MCU_OUT_5: CON1.20
MCU_OUT_6: CON1.18
MCU_OUT_7: CON1.16
MCU_RX: MCU1.52 (PC11), R8.2, R9.1
MCU_TX: MCU1.51 (PC10), R7.1
unnamed: OK2.2 (A), R2.1
unnamed: OK2.6 (VO), R6.1, R8.1
unnamed: OK2.7 (VE), R5.1
unnamed: OK1.7 (VE), R3.1
unnamed: PWR_RED1.A, R10.1
unnamed: OK1.2 (A), R7.2
unnamed: PWR_RED2.A, R11.1
unnamed: R12.1, RED1.A
unnamed: R13.1, RED2.A
unnamed: C_USB6.2, IC1.3 (VCCIO), IC1.10 (3V3OUT), IC1.11 (!RESET)
unnamed: GREEN1.A, R14.1
unnamed: GREEN2.A, R15.1
unnamed: C_USB8.2, IC1.8 (USBDP), R_USB6.2
unnamed: C_USB7.2, IC1.9 (USBDM), R_USB5.2
unnamed: CON3.2, R_USB5.1
unnamed: CON3.3, R_USB6.1
NRST: MCU1.7 (NRST), R1.1, ST-LINK.4
OSC_IN: MCU1.5 (OSC_IN)
OSC_IN_: C9.2, Q1.2
OSC_OUT: MCU1.6 (OSC_OUT)
OSC_OUT_: C10.2, Q1.1
SWCLK: MCU1.49 (PA14), ST-LINK.3
SWDIO: MCU1.46 (PA13), ST-LINK.2
UART4_RX: IC1.1 (TXD), R2.2
UART4_TX: IC1.4 (RXD), OK1.6 (VO), R4.1
VCAP: C4.1, C5.1, MCU1.30 (VCAP_1)
VDD_3V3: C_USB9.2, C_USB10.2, IC1.12 (VCC)

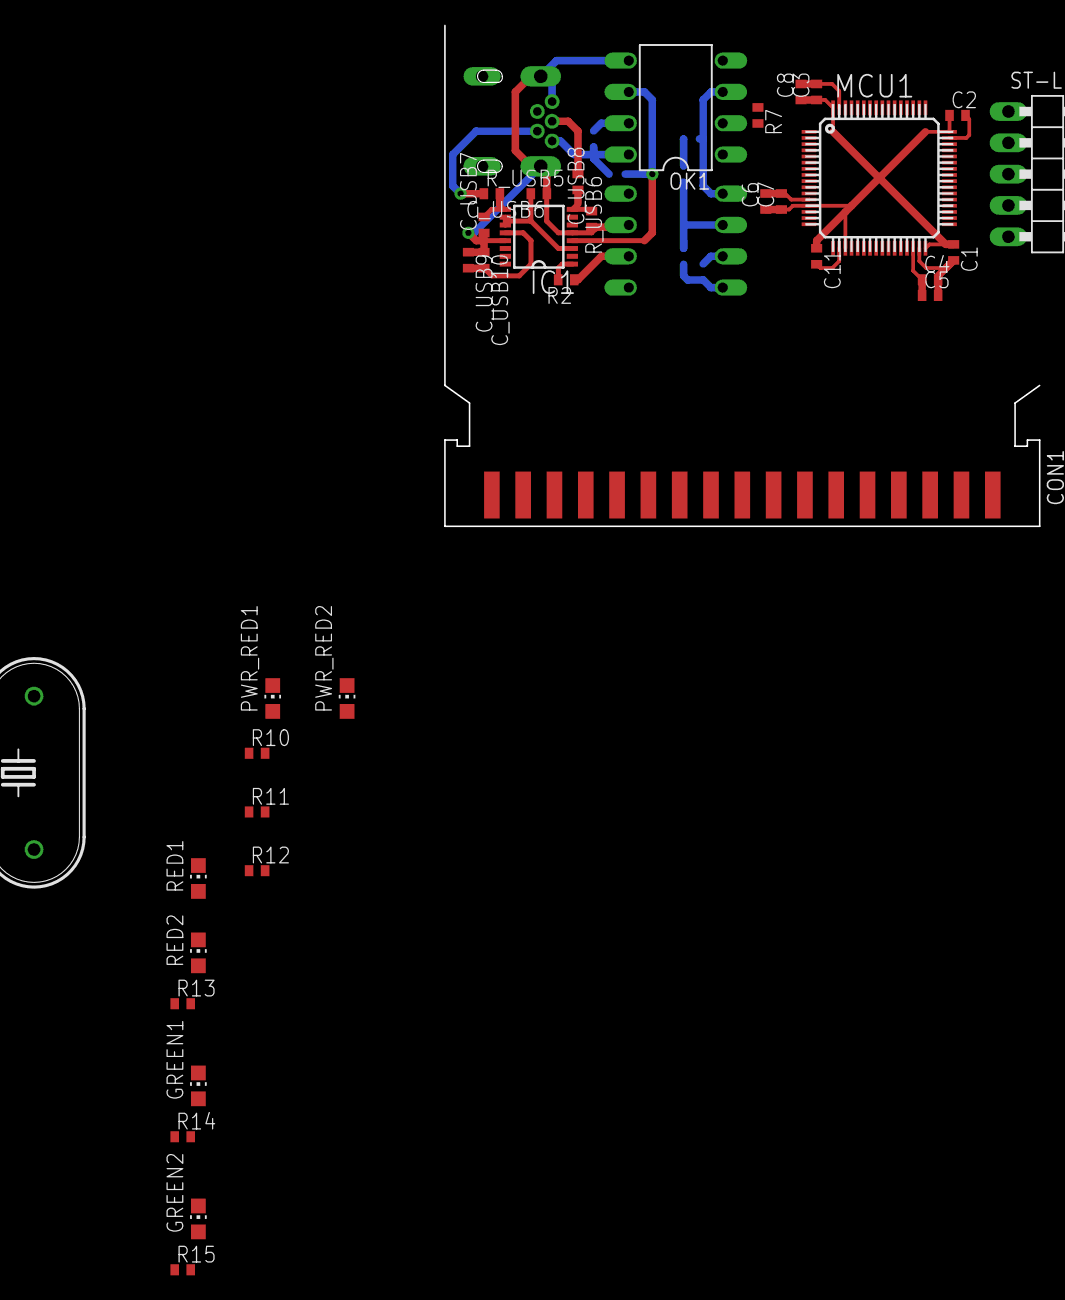
[picture p94: board ControlBoardUsb.brd from above]

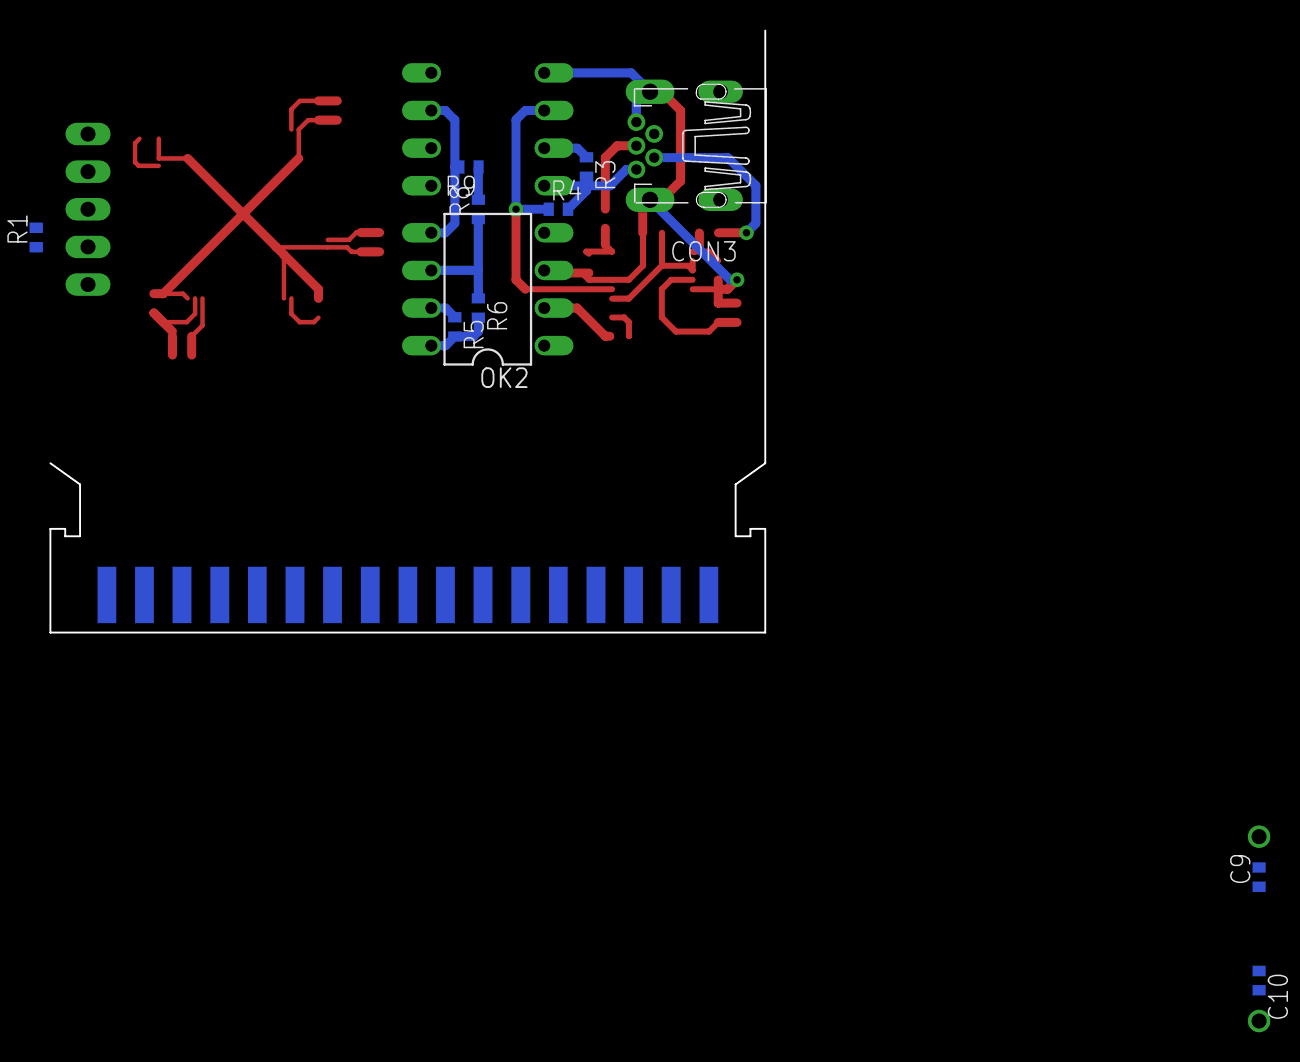
[picture p95: board ControlBoardUsb.brd from below]

Board: 2 copper layers, 47 parts (11 on the bottom side), 34 nets.
