cnz95/SWTE_UTN_FRN_GESE_PID/partes/placa de control/placa micro PCB/WT_Interface/ControlBoardEsp.brd

## EAGLE design partes/placa de control/placa micro PCB/WT_Interface/ControlBoardEsp.brd (2025-10-28)

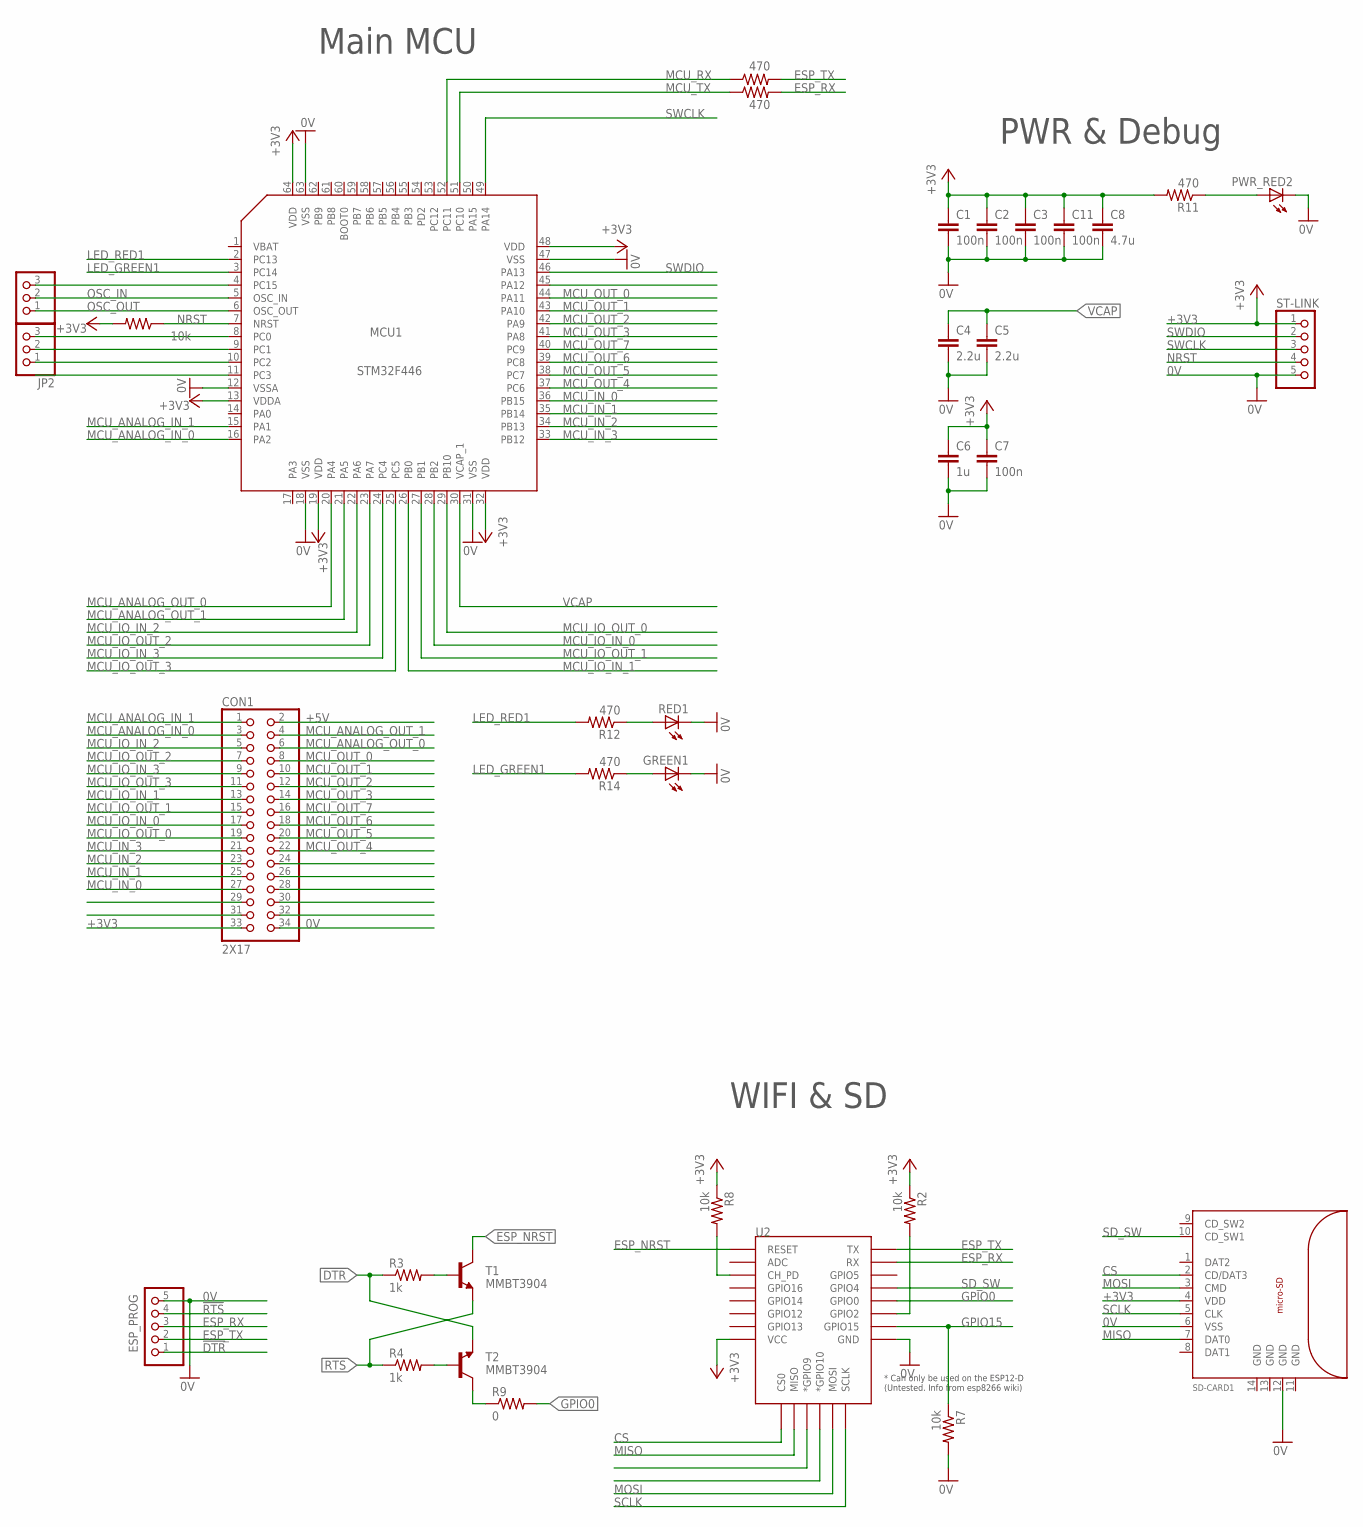
[picture p96: schematic ControlBoardEsp.sch]

Parts:
C1, C2, C3, C7, C11: 100n; C0402
C4, C5: 2.2u; C0402
C6: 1u; C0402
C8: 4.7u; C0402
CON1: 2X17
ESP_PROG: PINHD-1X5; 1X05
GREEN1: LEDCHIP-LED0805; CHIP-LED0805
JP1, JP2: PINHD-1X3; 1X03
MCU1: STM32F446; LQFP-64
PWR_RED2: LEDCHIP-LED0805; CHIP-LED0805
R1, R2, R7, R8: 10k; R0402
R3: 1k; R0402
R4: 1k; R1206
R5, R6, R11, R12, R14: 470; R0402
R9: 0; R1206
RED1: LEDCHIP-LED0805; CHIP-LED0805
SD-CARD1: MICRO-SD; MICRO_SD_FOOTPRINT
ST-LINK: PINHD-1X5; 1X05
T1, T2: MMBT3904; SOT23-BEC
U2: ESP12ESMD; ESP12E-SMD

Connections:
0V: C1.2, C2.2, C3.2, C4.2, C5.2, C6.2, C7.2, C8.2, C11.2, CON1.34, ESP_PROG.5, GREEN1.C, MCU1.12 (VSSA), MCU1.18 (VSS), MCU1.31 (VSS), MCU1.47 (VSS), MCU1.63 (VSS), PWR_RED2.C, R7.2, RED1.C, SD-CARD1.6 (VSS), SD-CARD1.12 (GND), ST-LINK.5, U2.GND
!DTR!: ESP_PROG.1, R3.1, T2.E
!RTS!: ESP_PROG.4, R4.1, T1.E
+3V3: C1.1, C2.1, C3.1, C6.1, C7.1, C8.1, C11.1, CON1.33, MCU1.13 (VDDA), MCU1.19 (VDD), MCU1.32 (VDD), MCU1.48 (VDD), MCU1.64 (VDD), R1.2, R2.1, R8.1, R11.2, SD-CARD1.4 (VDD), ST-LINK.1, U2.VCC
+5V: CON1.2
CS: SD-CARD1.2 (CD/DAT3), U2.CS0
ESP_NRST: T1.C, U2.RESET
ESP_RX: ESP_PROG.3, R6.2, U2.RXD0 (RX)
ESP_TX: ESP_PROG.2, R5.2, U2.TXD0 (TX)
GPIO0: R9.2, U2.GPIO0
GPIO15: R7.1, U2.GPIO15
LED_GREEN1: MCU1.3 (PC14), R14.2
LED_RED1: MCU1.2 (PC13), R12.2
MCU_ANALOG_IN_0: CON1.3, MCU1.16 (PA2)
MCU_ANALOG_IN_1: CON1.1, MCU1.15 (PA1)
MCU_ANALOG_OUT_0: CON1.6, MCU1.20 (PA4)
MCU_ANALOG_OUT_1: CON1.4, MCU1.21 (PA5)
MCU_IN_0: CON1.27, MCU1.36 (PB15)
MCU_IN_1: CON1.25, MCU1.35 (PB14)
MCU_IN_2: CON1.23, MCU1.34 (PB13)
MCU_IN_3: CON1.21, MCU1.33 (PB12)
MCU_IO_IN_0: CON1.17, MCU1.28 (PB2)
MCU_IO_IN_1: CON1.13, MCU1.26 (PB0)
MCU_IO_IN_2: CON1.5, MCU1.22 (PA6)
MCU_IO_IN_3: CON1.9, MCU1.24 (PC4)
MCU_IO_OUT_0: CON1.19, MCU1.29 (PB10)
MCU_IO_OUT_1: CON1.15, MCU1.27 (PB1)
MCU_IO_OUT_2: CON1.7, MCU1.23 (PA7)
MCU_IO_OUT_3: CON1.11, MCU1.25 (PC5)
MCU_OUT_0: CON1.8, MCU1.44 (PA11)
MCU_OUT_1: CON1.10, MCU1.43 (PA10)
MCU_OUT_2: CON1.12, MCU1.42 (PA9)
MCU_OUT_3: CON1.14, MCU1.41 (PA8)
MCU_OUT_4: CON1.22, MCU1.37 (PC6)
MCU_OUT_5: CON1.20, MCU1.38 (PC7)
MCU_OUT_6: CON1.18, MCU1.39 (PC8)
MCU_OUT_7: CON1.16, MCU1.40 (PC9)
MCU_RX: MCU1.52 (PC11), R5.1
MCU_TX: MCU1.51 (PC10), R6.1
MISO: SD-CARD1.7 (DAT0), U2.MISO
MOSI: SD-CARD1.3 (CMD), U2.MOSI
unnamed: R2.2, U2.GPIO2
unnamed: R3.2, T1.B
unnamed: R4.2, T2.B
unnamed: R8.2, U2.CH_PD
unnamed: R9.1, T2.C
unnamed: PWR_RED2.A, R11.1
unnamed: R12.1, RED1.A
unnamed: JP2.1, MCU1.10 (PC2)
unnamed: GREEN1.A, R14.1
unnamed: JP2.2, MCU1.9 (PC1)
unnamed: JP2.3, MCU1.8 (PC0)
unnamed: JP1.3, MCU1.4 (PC15)
NRST: MCU1.7 (NRST), R1.1, ST-LINK.4
OSC_IN: JP1.2, MCU1.5 (OSC_IN)
OSC_OUT: JP1.1, MCU1.6 (OSC_OUT)
SCLK: SD-CARD1.5 (CLK), U2.SCLK
SD_SW: SD-CARD1.10 (CD_SW1), U2.GPIO4
SWCLK: MCU1.49 (PA14), ST-LINK.3
SWDIO: MCU1.46 (PA13), ST-LINK.2
VCAP: C4.1, C5.1, MCU1.30 (VCAP_1)

Notes on the sheet:
PWR & Debug
Main MCU
WIFI & SD

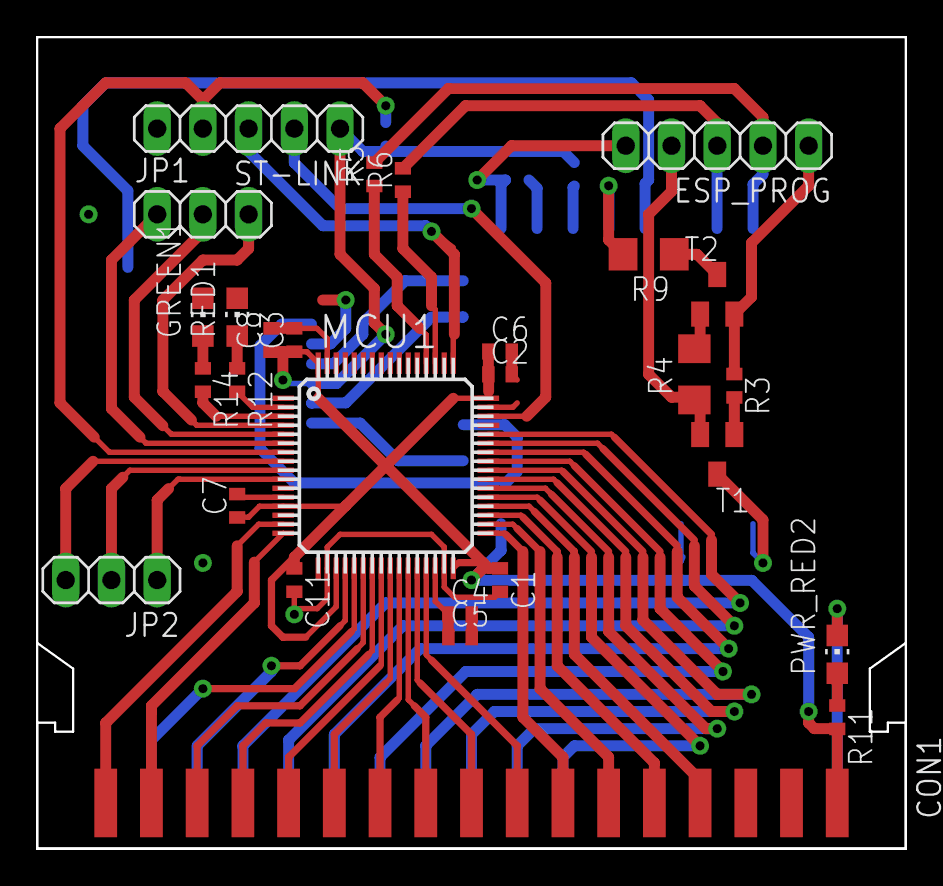
[picture p97: board ControlBoardEsp.brd from above]

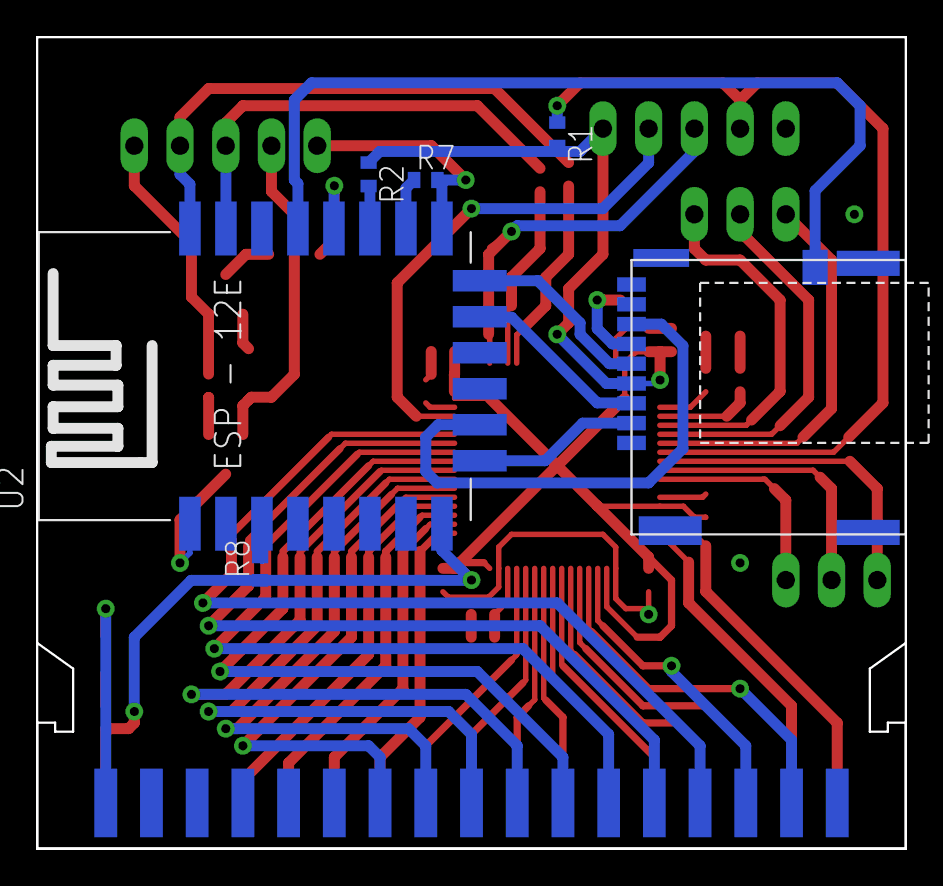
[picture p98: board ControlBoardEsp.brd from below]

Board: 2 copper layers, 48.3 x 45.1 mm, 34 parts (6 on the bottom side), 60 nets.
