cnz95/SWTE_UTN_FRN_GESE_PID/partes/placa de control/placa micro PCB/WT_Interface/SubCircuits/OptoInputs.brd

## EAGLE design partes/placa de control/placa micro PCB/WT_Interface/SubCircuits/OptoInputs.brd (2025-10-28)

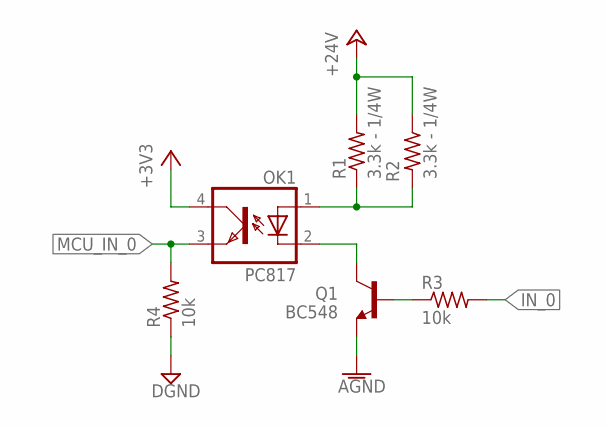
[picture p99: schematic OptoInputs.sch]

Parts:
OK1: PC817; DIL04
Q1: BC548; TO92-EBC
R1, R2: 3.3k - 1/4W; 0204V
R3: 10k; 0204/5
R4: 10k; R0402

Connections:
+3V3: OK1.4 (COL)
+24V: R1.2, R2.1
AGND: Q1.E
DGND: R4.1
IN_0: R3.2
MCU_IN_0: OK1.3 (EMIT), R4.2
unnamed: OK1.1 (A), R1.1, R2.2
unnamed: OK1.2 (C), Q1.C
unnamed: Q1.B, R3.1

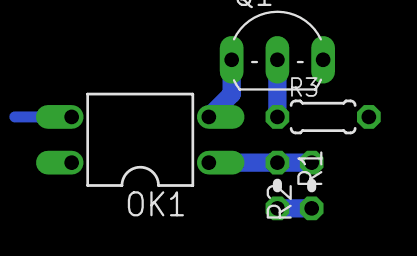
[picture p100: board OptoInputs.brd from above]

Board: 2 copper layers, 6 parts (1 on the bottom side), 5 nets.
