cnz95/SWTE_UTN_FRN_GESE_PID/partes/placa de control/placa micro PCB/WT_Interface/SubCircuits/OptoOutput.brd

## EAGLE design partes/placa de control/placa micro PCB/WT_Interface/SubCircuits/OptoOutput.brd (2025-10-28)

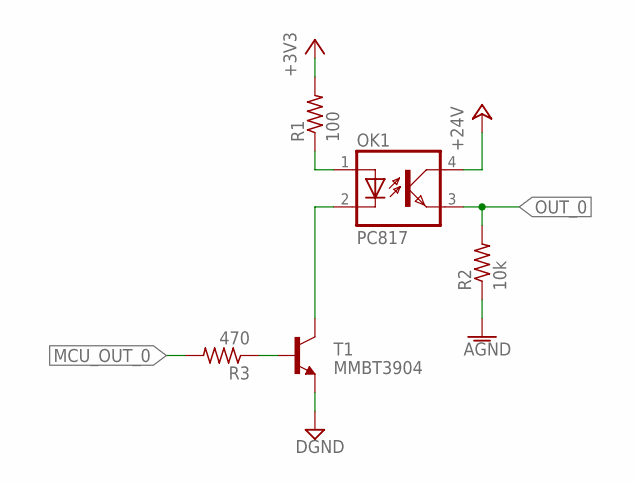
[picture p101: schematic OptoOutput.sch]

Parts:
OK1: PC817; DIL04
R1: 100; R0402
R2: 10k; R0402
R3: 470; 0204/5
T1: MMBT3904; SOT23-BEC

Connections:
+3V3: R1.2
+24V: OK1.4 (COL)
AGND: R2.1
DGND: T1.E
MCU_OUT_0: R3.2
unnamed: OK1.2 (C), T1.C
unnamed: R3.1, T1.B
unnamed: OK1.1 (A), R1.1
OUT_0: OK1.3 (EMIT), R2.2

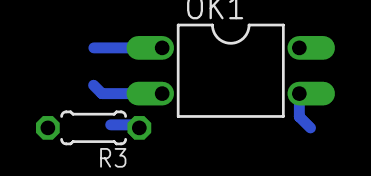
[picture p102: board OptoOutput.brd from above]

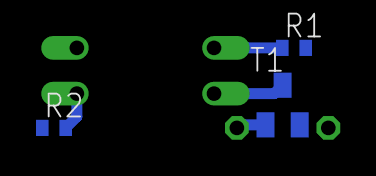
[picture p103: board OptoOutput.brd from below]

Board: 2 copper layers, 5 parts (3 on the bottom side), 4 nets.
