cnz95/SWTE_UTN_FRN_GESE_PID/partes/placa de control/placa micro PCB/nueva placa micro/MicrocontrollerBoard_V0.0.brd

## EAGLE design partes/placa de control/placa micro PCB/nueva placa micro/MicrocontrollerBoard_V0.0.brd (2025-10-28, an earlier design)

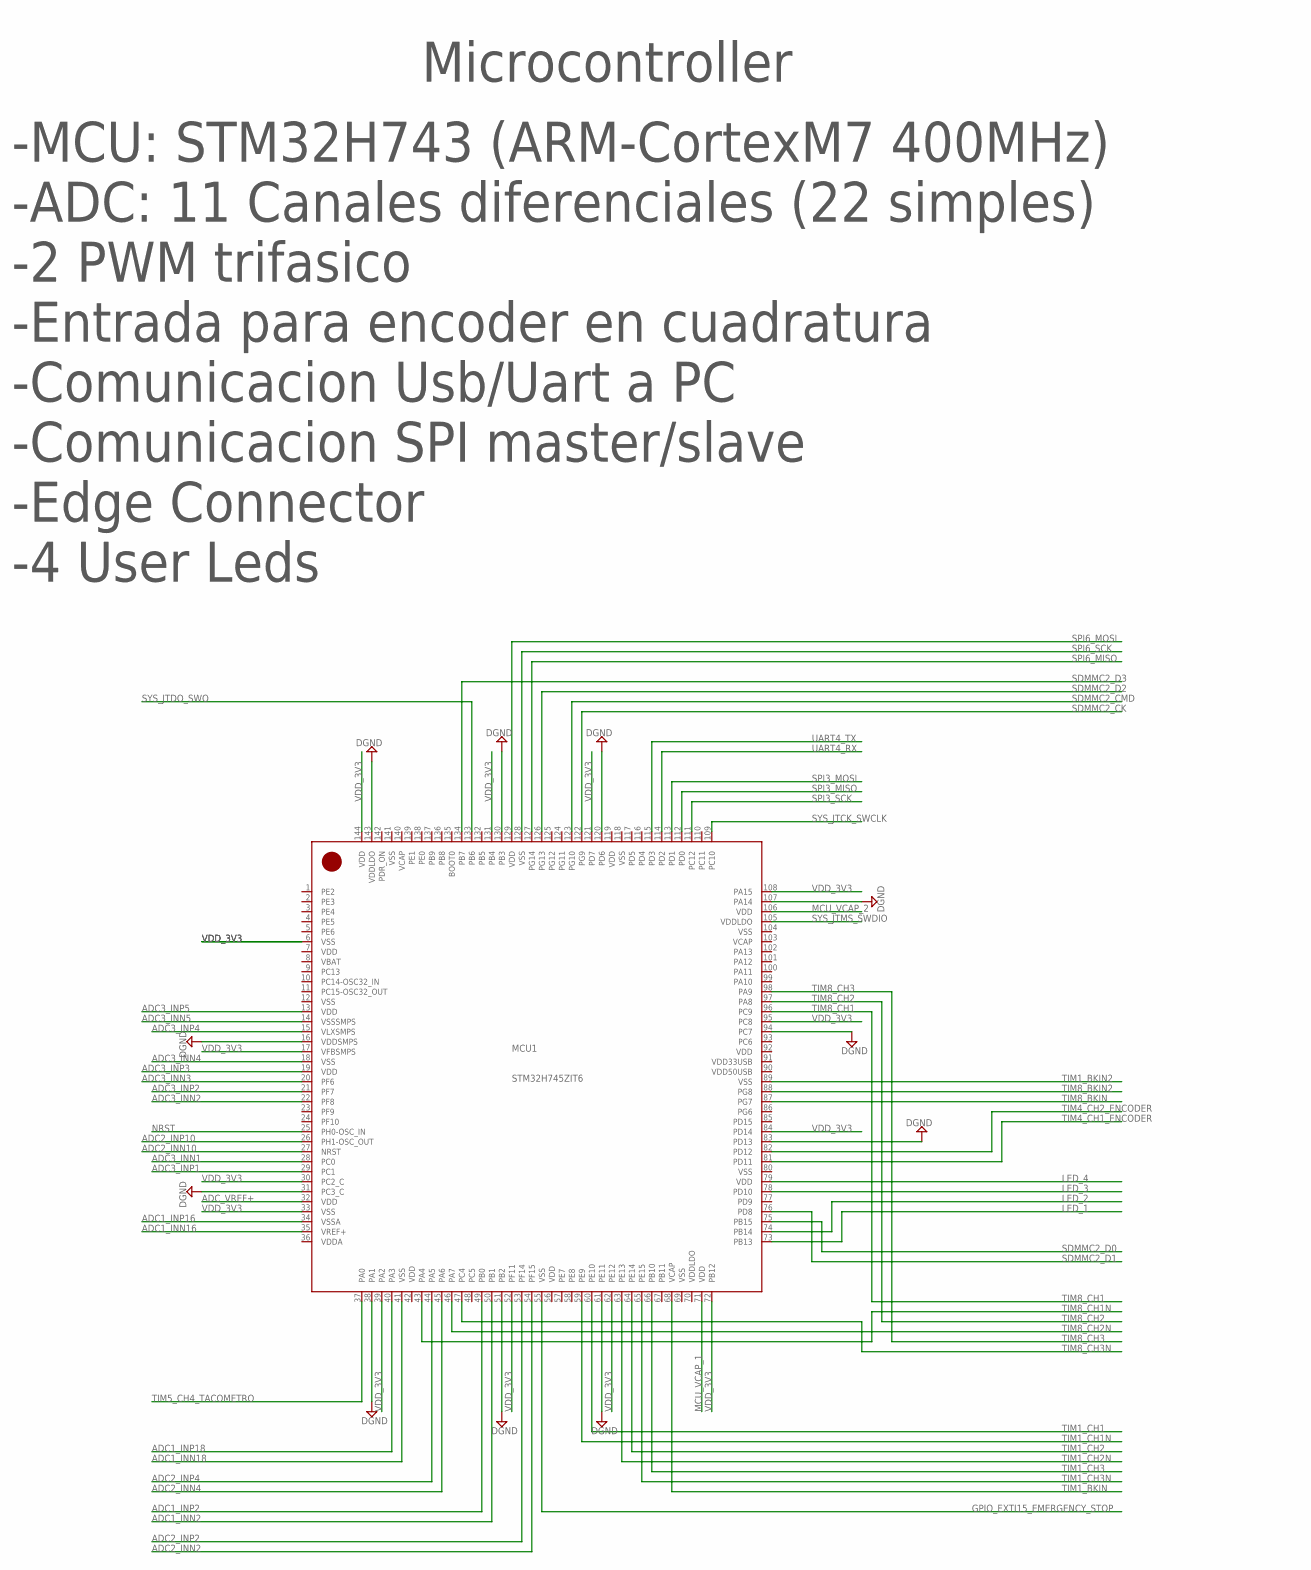
[picture p104: schematic MicrocontrollerBoard_V0.0.sch, part in row 1, column 1]

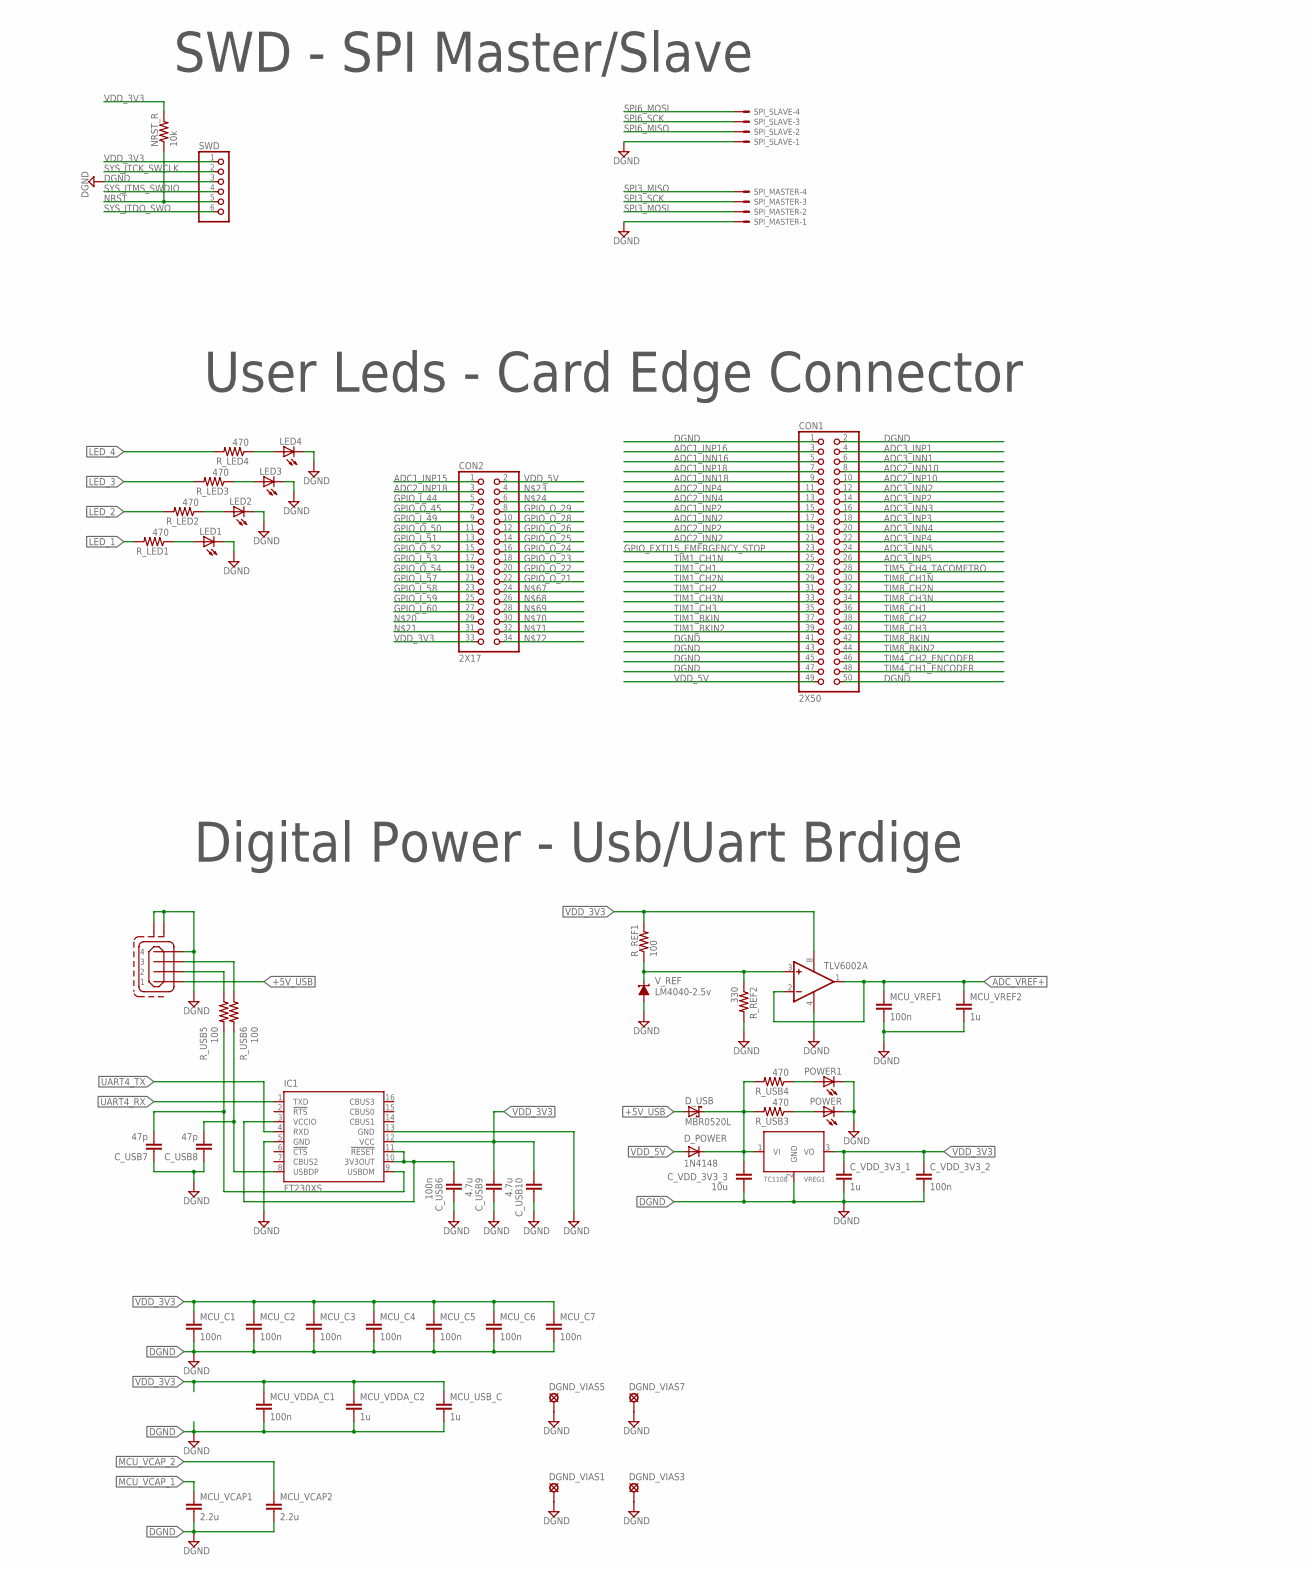
[picture p105: schematic MicrocontrollerBoard_V0.0.sch, part in row 1, column 2]

Parts:
CON1: 2X50; 2X25
CON2: 2X17
C_USB6: 100n; C0402
C_USB7, C_USB8: 47p; C0402
C_USB9, C_USB10: 4.7u; C0402
C_VDD_3V3_1: 1u; C0603K
C_VDD_3V3_2: 100n; C0603K
C_VDD_3V3_3: 10u; C0603K
DGND_VIAS1, DGND_VIAS3, DGND_VIAS5, DGND_VIAS7: LSP10
D_POWER: 1N4148; SMA-DO214AC
D_USB: MBR0520L; SOD-123
IC1: FT230XS; SSOP16
LED1, LED2, LED3, LED4: LEDCHIPLED_0805; CHIPLED_0805
MCU1: STM32H745ZIT6144; LQFP144
MCU_C1, MCU_C2, MCU_C3, MCU_C4, MCU_C5, MCU_C6, MCU_C7: 100n; C0402
MCU_USB_C: 1u; C0402
MCU_VCAP1, MCU_VCAP2: 2.2u; C0402
MCU_VDDA_C1: 100n; C0402
MCU_VDDA_C2: 1u; C0402
MCU_VREF1: 100n; C0402
MCU_VREF2: 1u; C0402
NRST_R: 10k; R0402
POWER, POWER1: LEDCHIPLED_0805; CHIPLED_0805
R_LED1, R_LED2, R_LED3, R_LED4: 470; R0402
R_REF1: 100; R0805
R_REF2: 330; R0805
R_USB3, R_USB4: 470; R0402
R_USB5, R_USB6: 100; R0402
SPI_MASTER: 22-23-2041
SPI_SLAVE: 22-23-2041
SWD: PINHD-1X6/90; 1X06/90
TLV6002: TL082D; SO08
VREG1: TC1108'SOT-223'; SOT-223
V_REF: LM4040-2.5v; DBZ_R-PDSO-G3
X2: MINI-USB_SHIELD4P-85-32004-00X; 85-32004-00X

Connections:
+5V_USB: D_USB.A (IN), X2.1
ADC1_INN2: CON1.17, MCU1.50 (PB1)
ADC1_INN16: CON1.5, MCU1.35 (VREF+)
ADC1_INN18: CON1.9, MCU1.41 (VSS)
ADC1_INP2: CON1.15, MCU1.49 (PB0)
ADC1_INP15: CON2.1
ADC1_INP16: CON1.3, MCU1.34 (VSSA)
ADC1_INP18: CON1.7, MCU1.40 (PA3)
ADC2_INN2: CON1.21, MCU1.54 (PF15)
ADC2_INN4: CON1.13, MCU1.45 (PA6)
ADC2_INN10: CON1.8, MCU1.27 (NRST)
ADC2_INP2: CON1.19, MCU1.53 (PF14)
ADC2_INP4: CON1.11, MCU1.44 (PA5)
ADC2_INP10: CON1.10, MCU1.26 (PH1-OSC_OUT)
ADC2_INP18: CON2.3
ADC3_INN1: CON1.6, MCU1.28 (PC0)
ADC3_INN2: CON1.12, MCU1.22 (PF8)
ADC3_INN3: CON1.16, MCU1.20 (PF6)
ADC3_INN4: CON1.20, MCU1.18 (VSS)
ADC3_INN5: CON1.24, MCU1.14 (VSSSMPS)
ADC3_INP1: CON1.4, MCU1.29 (PC1)
ADC3_INP2: CON1.14, MCU1.21 (PF7)
ADC3_INP3: CON1.18, MCU1.19 (VDD)
ADC3_INP4: CON1.22, MCU1.15 (VLXSMPS)
ADC3_INP5: CON1.26, MCU1.13 (VDD)
ADC_VREF+: MCU1.32 (VDD), MCU_VREF1.1, MCU_VREF2.1, TLV6002.1 (OUT), TLV6002.2 (-IN)
DGND: CON1.1, CON1.2, CON1.41, CON1.43, CON1.45, CON1.47, CON1.50, C_USB6.1, C_USB7.1, C_USB8.1, C_USB9.1, C_USB10.1, C_VDD_3V3_1.2, C_VDD_3V3_2.2, C_VDD_3V3_3.2, DGND_VIAS1.MP, DGND_VIAS3.MP, DGND_VIAS5.MP, DGND_VIAS7.MP, IC1.5 (GND), IC1.13 (GND), LED1.C, LED2.C, LED3.C, LED4.C, MCU1.16 (VDDSMPS), MCU1.31 (PC3_C), MCU1.38 (PA1), MCU1.51 (PB2), MCU1.61 (PE11), MCU1.83 (PD13), MCU1.94 (PC7), MCU1.107 (PA14), MCU1.120 (PD6), MCU1.130 (PB3), MCU1.143 (VDDLDO), MCU_C1.2, MCU_C2.2, MCU_C3.2, MCU_C4.2, MCU_C5.2, MCU_C6.2, MCU_C7.2, MCU_USB_C.2, MCU_VCAP1.2, MCU_VCAP2.2, MCU_VDDA_C1.2, MCU_VDDA_C2.2, MCU_VREF1.2, MCU_VREF2.2, POWER.C, POWER1.C, R_REF2.2, SPI_MASTER.1, SPI_SLAVE.1, SWD.3, TLV6002.4 (V-), VREG1.2 (GND), V_REF.2 (A), X2.4, X2.M1 (S1), X2.M2 (S2)
GPIO_EXTI15_EMERGENCY_STOP: CON1.23, MCU1.55 (VSS)
GPIO_I_44: CON2.5
GPIO_I_49: CON2.9
GPIO_I_51: CON2.13
GPIO_I_53: CON2.17
GPIO_I_57: CON2.21
GPIO_I_58: CON2.23
GPIO_I_59: CON2.25
GPIO_I_60: CON2.27
GPIO_O_21: CON2.22
GPIO_O_22: CON2.20
GPIO_O_23: CON2.18
GPIO_O_24: CON2.16
GPIO_O_25: CON2.14
GPIO_O_26: CON2.12
GPIO_O_28: CON2.10
GPIO_O_29: CON2.8
GPIO_O_45: CON2.7
GPIO_O_50: CON2.11
GPIO_O_52: CON2.15
GPIO_O_54: CON2.19
LED_1: MCU1.73 (PB13), R_LED1.2
LED_2: MCU1.74 (PB14), R_LED2.2
LED_3: MCU1.78 (PD10), R_LED3.2
LED_4: MCU1.79 (VDD), R_LED4.2
MCU_VCAP_1: MCU1.71 (VDD), MCU_VCAP1.1
MCU_VCAP_2: MCU1.106 (VDD), MCU_VCAP2.1
unnamed: LED4.A, R_LED4.1
unnamed: POWER1.A, R_USB4.1
unnamed: LED3.A, R_LED3.1
unnamed: C_USB6.2, IC1.3 (VCCIO), IC1.10 (3V3OUT), IC1.11 (!RESET)
unnamed: C_VDD_3V3_3.1, D_POWER.K (C), D_USB.C (OUT), R_USB3.2, R_USB4.2, VREG1.1 (VI)
unnamed: C_USB8.2, IC1.8 (USBDP), R_USB6.2
unnamed: C_USB7.2, IC1.9 (USBDM), R_USB5.2
unnamed: R_USB5.1, X2.2
unnamed: R_USB6.1, X2.3
unnamed: POWER.A, R_USB3.1
unnamed: R_REF1.1, R_REF2.1, TLV6002.3 (+IN), V_REF.1 (C)
unnamed: LED1.A, R_LED1.1
unnamed: LED2.A, R_LED2.1
NRST: MCU1.25 (PH0-OSC_IN), NRST_R.1, SWD.5
SDMMC2_CK: MCU1.122 (PG9)
SDMMC2_CMD: MCU1.123 (PG10)
SDMMC2_D0: MCU1.75 (PB15)
SDMMC2_D1: MCU1.76 (PD8)
SDMMC2_D2: MCU1.126 (PG13)
SDMMC2_D3: MCU1.134 (PB7)
SPI3_MISO: MCU1.112 (PD0), SPI_MASTER.4
SPI3_MOSI: MCU1.113 (PD1), SPI_MASTER.2
SPI3_SCK: MCU1.111 (PC12), SPI_MASTER.3
SPI6_MISO: MCU1.127 (PG14), SPI_SLAVE.2
SPI6_MOSI: MCU1.129 (VDD), SPI_SLAVE.4
SPI6_SCK: MCU1.128 (VSS), SPI_SLAVE.3
SYS_JTCK_SWCLK: MCU1.109 (PC10), SWD.2
SYS_JTDO_SWO: MCU1.133 (PB6), SWD.6
SYS_JTMS_SWDIO: MCU1.105 (VDDLDO), SWD.4
TIM1_BKIN: CON1.37, MCU1.68 (VCAP)
TIM1_BKIN2: CON1.39, MCU1.89 (VSS)
TIM1_CH1: CON1.27, MCU1.60 (PE10)
TIM1_CH1N: CON1.25, MCU1.59 (PE9)
TIM1_CH2: CON1.31, MCU1.64 (PE14)
TIM1_CH2N: CON1.29, MCU1.63 (PE13)
TIM1_CH3: CON1.35, MCU1.66 (PB10)
TIM1_CH3N: CON1.33, MCU1.65 (PE15)
TIM4_CH1_ENCODER: CON1.48, MCU1.81 (PD11)
TIM4_CH2_ENCODER: CON1.46, MCU1.82 (PD12)
TIM5_CH4_TACOMETRO: CON1.28, MCU1.37 (PA0)
TIM8_BKIN: CON1.42, MCU1.87 (PG7)
TIM8_BKIN2: CON1.44, MCU1.88 (PG8)
TIM8_CH1: CON1.36, MCU1.96 (PC9)
TIM8_CH1N: CON1.30, MCU1.43 (PA4)
TIM8_CH2: CON1.38, MCU1.97 (PA8)
TIM8_CH2N: CON1.32, MCU1.46 (PA7)
TIM8_CH3: CON1.40, MCU1.98 (PA9)
TIM8_CH3N: CON1.34, MCU1.47 (PC4)
UART4_RX: IC1.1 (TXD), MCU1.114 (PD2)
UART4_TX: IC1.4 (RXD), MCU1.115 (PD3)
VDD_3V3: CON2.33, C_USB9.2, C_USB10.2, C_VDD_3V3_1.1, C_VDD_3V3_2.1, IC1.12 (VCC), MCU1.6 (VSS), MCU1.17 (VFBSMPS), MCU1.30 (PC2_C), MCU1.33 (VSS), MCU1.39 (PA2), MCU1.52 (PF11), MCU1.62 (PE12), MCU1.72 (PB12), MCU1.84 (PD14), MCU1.95 (PC8), MCU1.108 (PA15), MCU1.121 (PD7), MCU1.131 (PB4), MCU1.144 (VDD), MCU_C1.1, MCU_C2.1, MCU_C3.1, MCU_C4.1, MCU_C5.1, MCU_C6.1, MCU_C7.1, MCU_USB_C.1, MCU_VDDA_C1.1, MCU_VDDA_C2.1, NRST_R.2, R_REF1.2, SWD.1, TLV6002.8 (V+), VREG1.3 (VO)
VDD_5V: CON1.49, CON2.2, D_POWER.A

Notes on the sheet:
Microcontroller
SWD - SPI Master/Slave
User Leds - Card Edge Connector
Digital Power - Usb/Uart Brdige
-MCU: STM32H743 (ARM-CortexM7 400MHz) -ADC: 11 Canales diferenciales (22 simples) -2 PWM trifasico -Entrada para encoder en cuadratura -Comunicacion Usb/Uart a PC -Comunicacion SPI master/slave -Edge Connector -4 User Leds

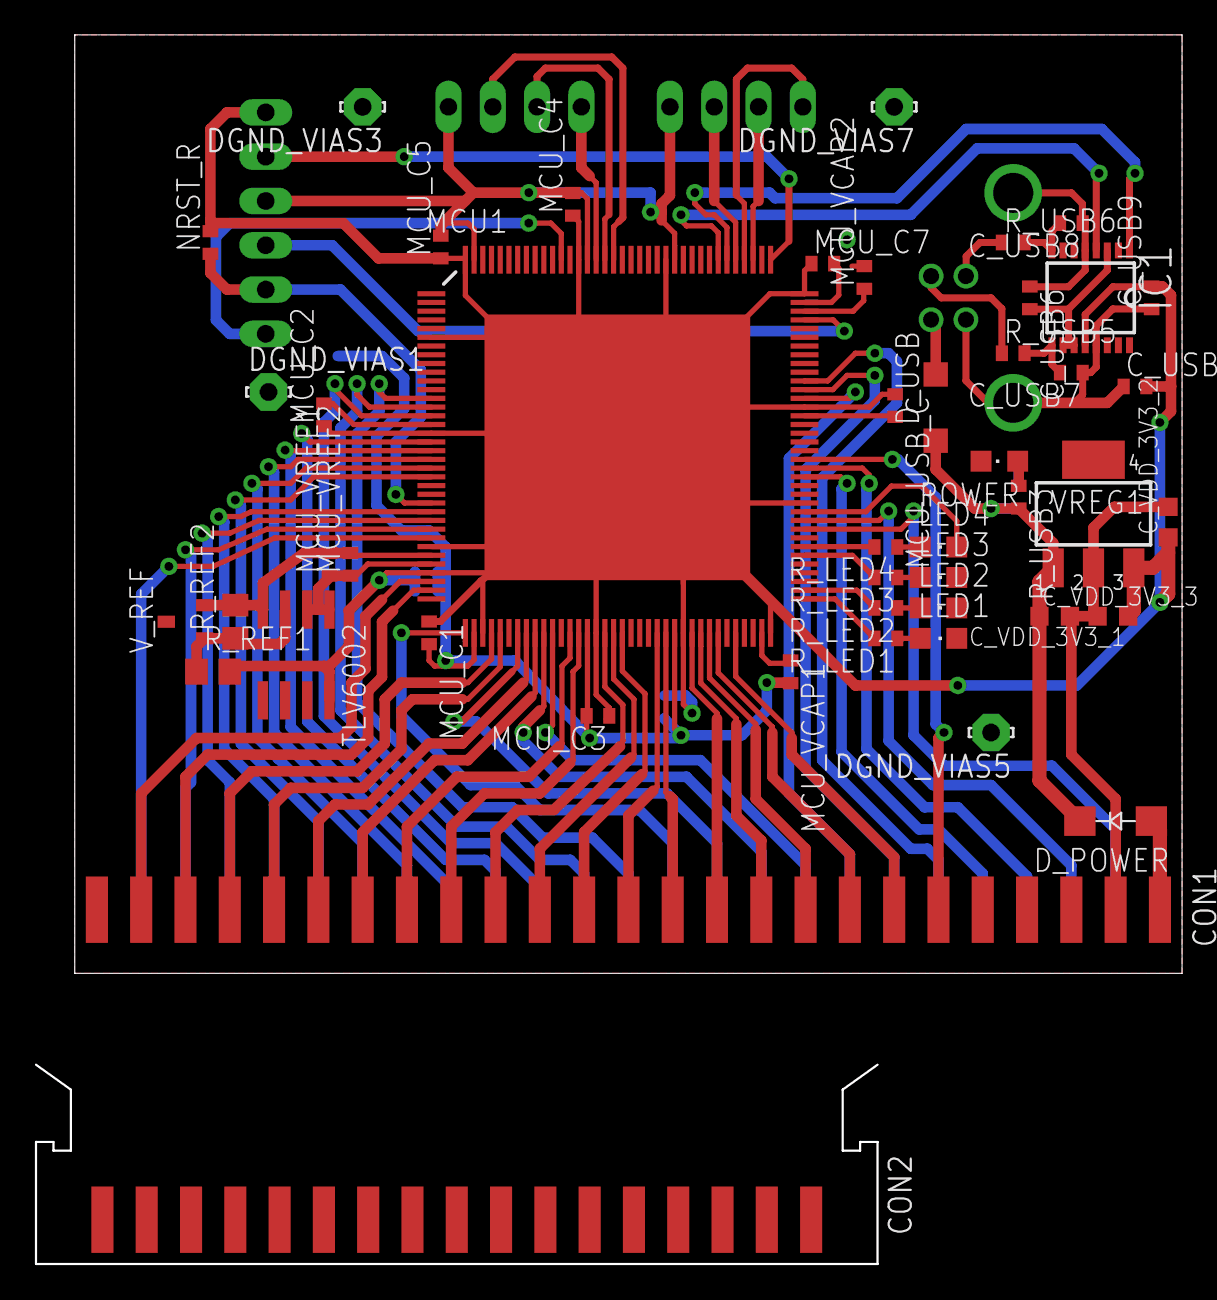
[picture p106: board MicrocontrollerBoard_V0.0.brd from above]

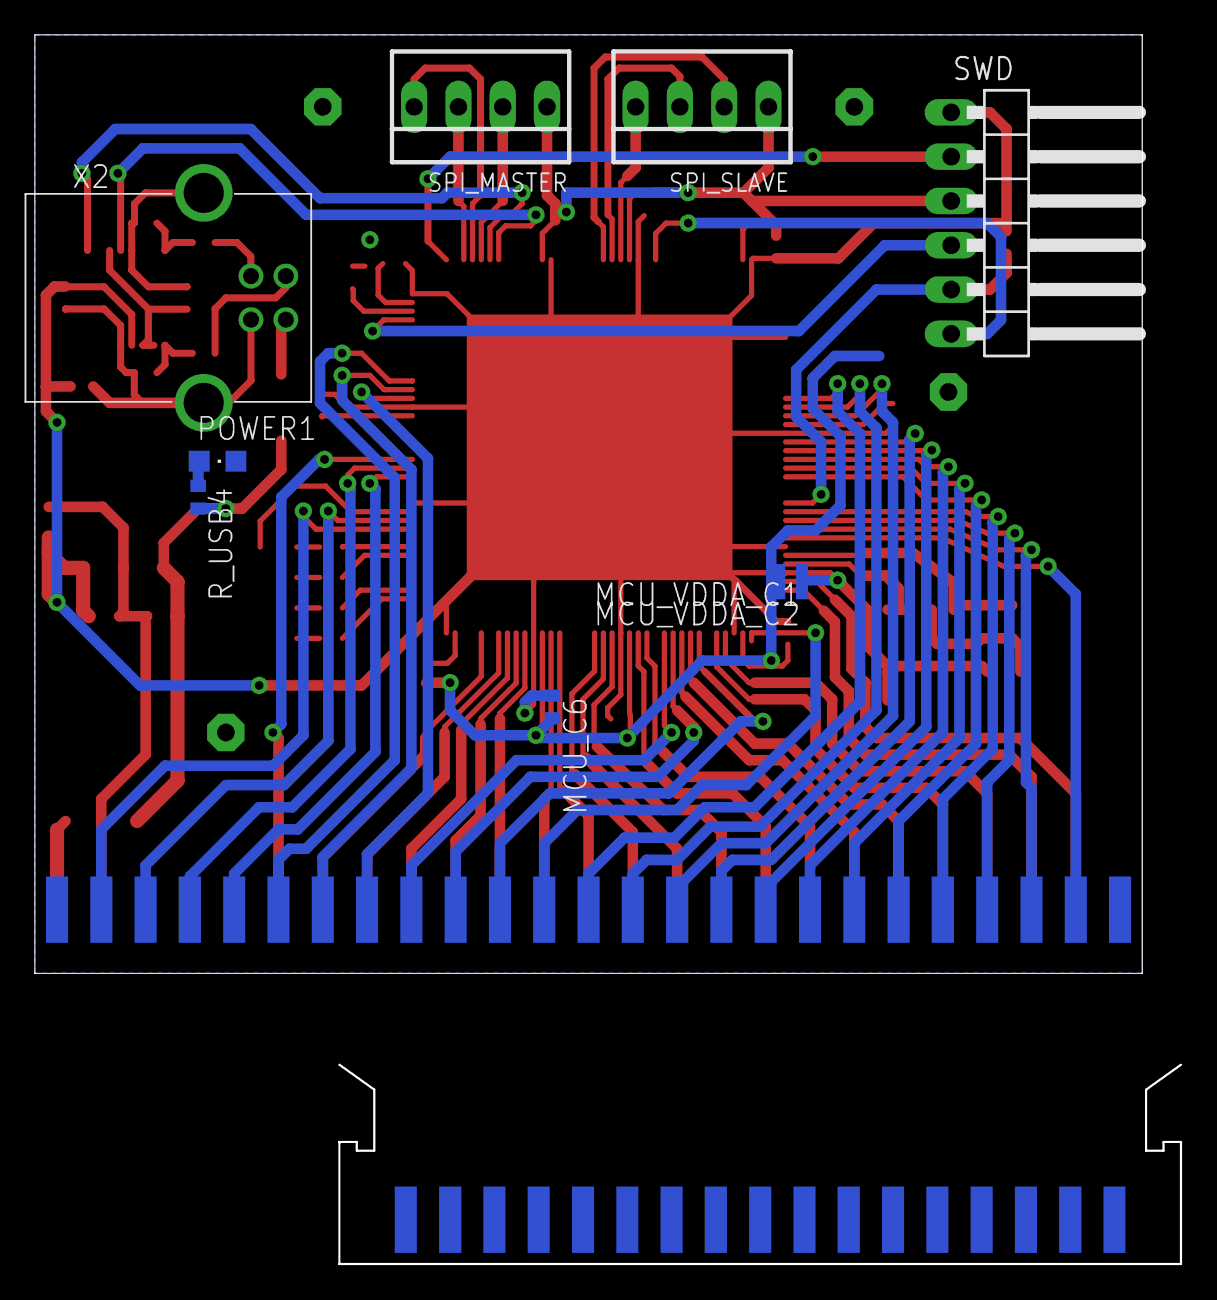
[picture p107: board MicrocontrollerBoard_V0.0.brd from below]

Board: 2 copper layers, 63.5 x 53.8 mm, 56 parts (9 on the bottom side), 78 nets.
