cnz95/SWTE_UTN_FRN_GESE_PID/partes/placa de control/placa micro PCB/WT_Interface/SubCircuits/OptoBidirectional.brd

## EAGLE design partes/placa de control/placa micro PCB/WT_Interface/SubCircuits/OptoBidirectional.brd (2025-10-28)

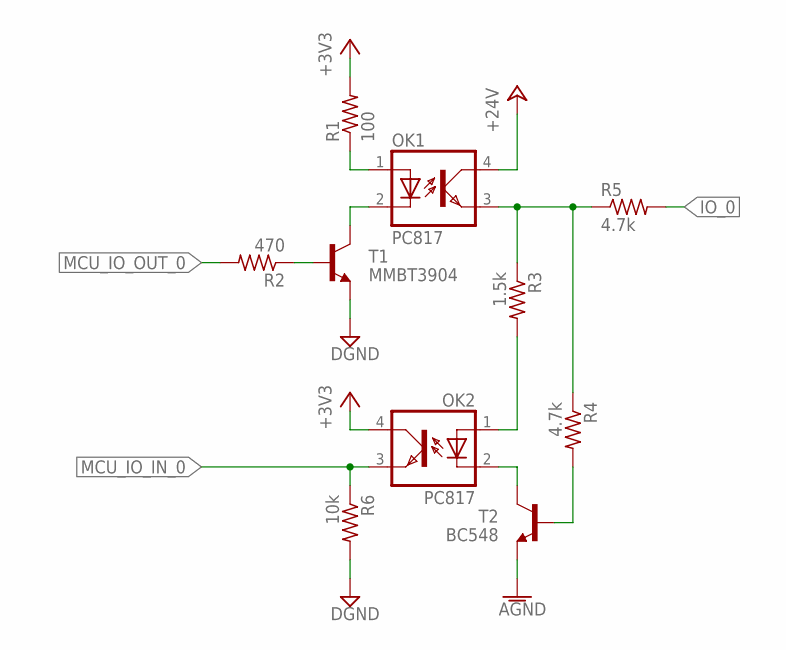
[picture p108: schematic OptoBidirectional.sch]

Parts:
OK1, OK2: PC817; DIL04
R1: 100; 0204/7
R2: 470; R0402
R3: 1.5k; 0204/5
R4, R5: 4.7k; 0204V
R6: 10k; 0204/5
T1: MMBT3904; SOT23-BEC
T2: BC548; TO92-CBE

Connections:
+3V3: OK2.4 (COL), R1.2
+24V: OK1.4 (COL)
AGND: T2.E
DGND: R6.2, T1.E
IO_0: R5.2
MCU_IO_IN_0: OK2.3 (EMIT), R6.1
MCU_IO_OUT_0: R2.2
unnamed: OK2.2 (C), T2.C
unnamed: OK1.2 (C), T1.C
unnamed: R2.1, T1.B
unnamed: OK1.1 (A), R1.1
unnamed: OK1.3 (EMIT), R3.1, R4.1, R5.1
unnamed: OK2.1 (A), R3.2
unnamed: R4.2, T2.B

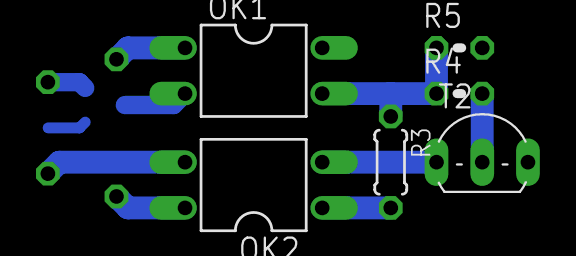
[picture p109: board OptoBidirectional.brd from above]

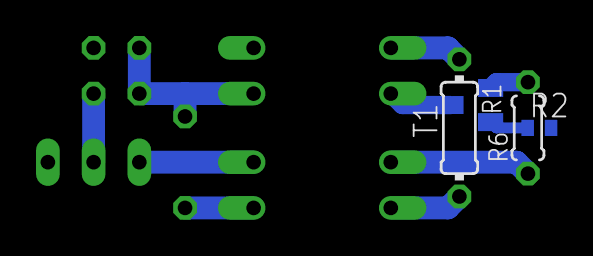
[picture p110: board OptoBidirectional.brd from below]

Board: 2 copper layers, 10 parts (4 on the bottom side), 10 nets.
